14chanwa/MiAM_robotics_ESP32/CAD/PAMI DC Base V2.stl

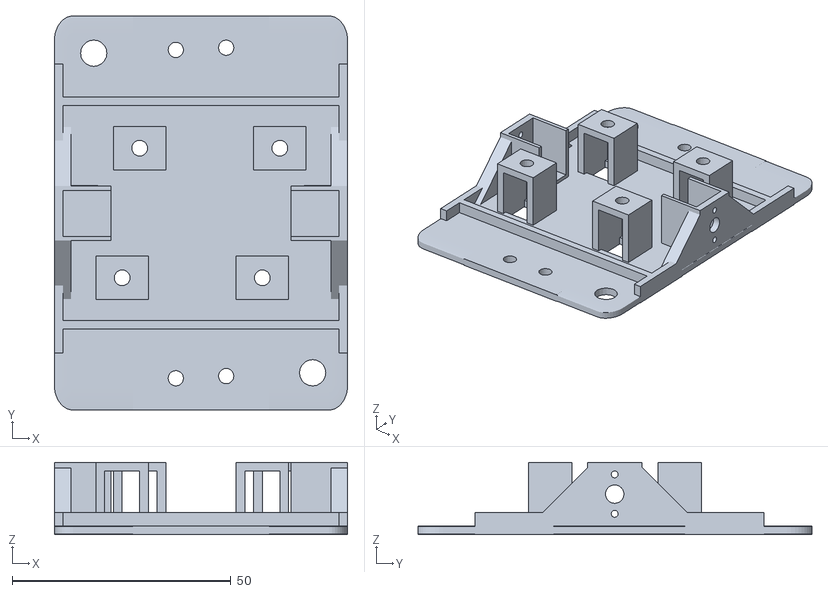
[picture p1: CAD file, 2023-10-16]
CAD/PAMI DC Base V2.stl
67.0 x 90.0 x 16.5
