14chanwa/MiAM_robotics_ESP32/Electronics/eurobot2024/MiAM_PAMI2024_DC/MiAM_PAMI_2024_DC.kicad_pcb

## KiCad design Electronics/eurobot2024/MiAM_PAMI2024_DC/MiAM_PAMI_2024_DC.kicad_pcb (2025-01-02)

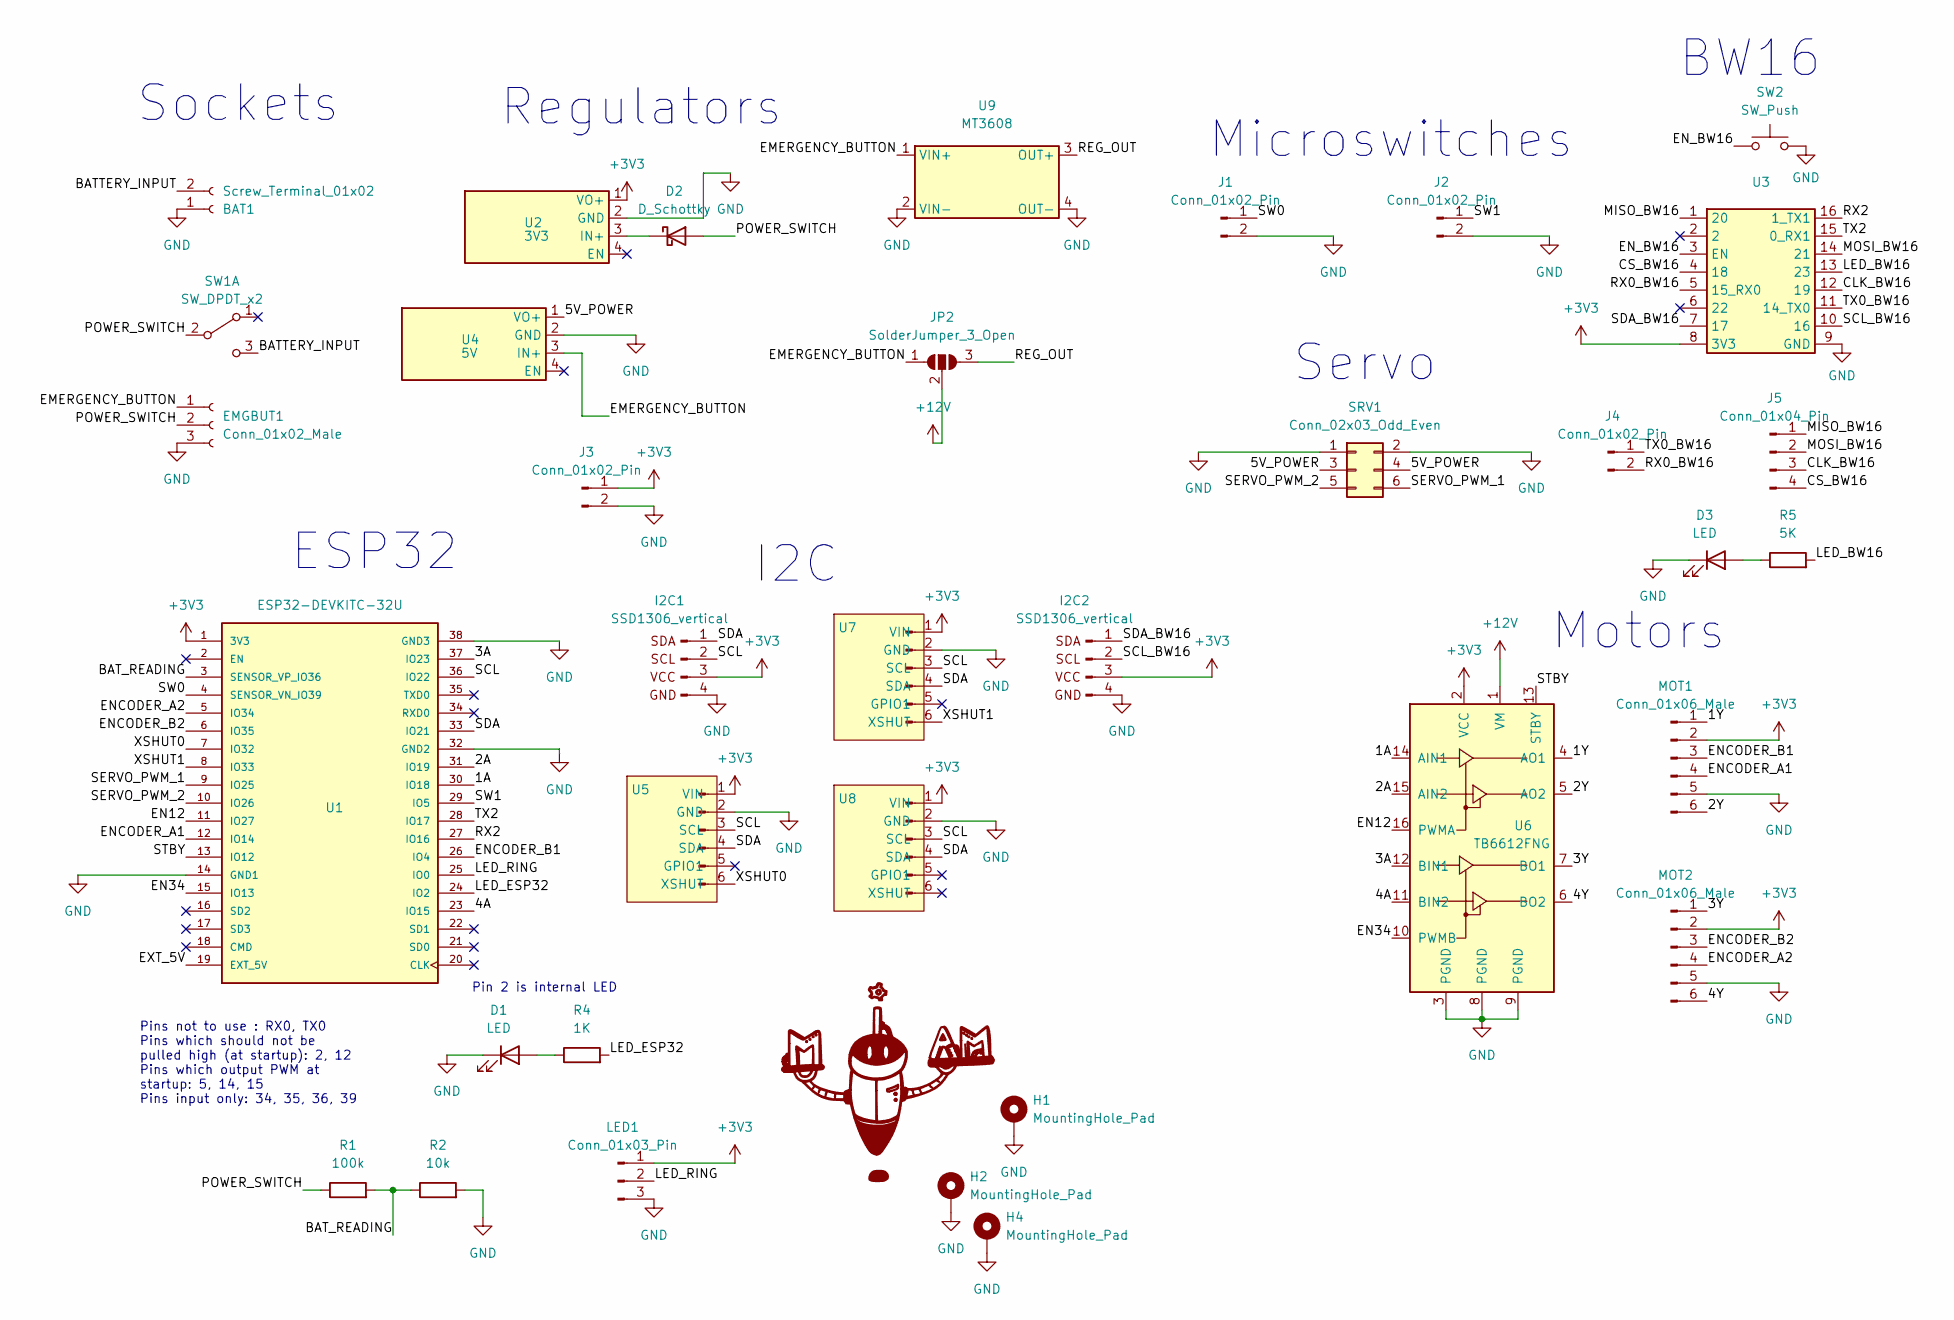
[picture p2: schematic MiAM_PAMI_2024_DC.kicad_sch]

Parts:
BAT1: Screw_Terminal_01x02; JST_PH_B2B-PH-K_1x02_P2.00mm_Vertical
D1, D3: LED; LED_0805_2012Metric
D2: D_Schottky; D_SOD-323_HandSoldering
EMGBUT1: Conn_01x02_Male; JST_PH_B3B-PH-K_1x03_P2.00mm_Vertical
H1, H2, H4: MountingHole_Pad; MountingHole_3.2mm_M3_DIN965_Pad
I2C1, I2C2: SSD1306_vertical; PinHeader_1x04_P2.54mm_Vertical
J1, J2, J3, J4: Conn_01x02_Pin; PinHeader_1x02_P2.54mm_Vertical
J5: Conn_01x04_Pin; PinHeader_1x04_P2.54mm_Vertical
JP2: SolderJumper_3_Open; SolderJumper-3_P1.3mm_Bridged12_Pad1.0x1.5mm_NumberLabels
LED1: Conn_01x03_Pin; PinHeader_1x03_P2.54mm_Vertical
MOT1, MOT2: Conn_01x06_Male; PinHeader_1x06_P2.54mm_Vertical
R1: 100k; R_0805_2012Metric_Pad1.20x1.40mm_HandSolder
R2: 10k; R_0805_2012Metric_Pad1.20x1.40mm_HandSolder
R4: 1K; R_0805_2012Metric
R5: 5K; R_0805_2012Metric
SRV1: Conn_02x03_Odd_Even; PinHeader_2x03_P2.54mm_Vertical
SW1: SW_DPDT_x2; SS-12D11
SW2: SW_Push; SW_Push_1P1T_NO_Vertical_Wuerth_434133025816
U1: ESP32-DEVKITC-32U; ESP32U-ShieldPattern
U2: 3V3; VoltageRegulator
U3: BW16_Breakout
U4: 5V; VoltageRegulator
U5, U7, U8: PinHeader_1x06_P2.54mm_Vertical
U6: TB6612FNG
U9: MT3608

Connections:
+3V3: I2C1.3 (VCC), I2C2.3 (VCC), J3.1, LED1.1, MOT1.2, MOT2.2, U1.1 (3V3), U2.1 (VO+), U3.8 (3V3), U5.1 (VIN), U6.2 (VCC), U7.1 (VIN), U8.1 (VIN)
+12V: JP2.2 (C), U6.1 (VM)
/1A: U1.30 (IO18), U6.14 (AIN1)
/1Y: MOT1.1, U6.4 (AO1)
/2A: U1.31 (IO19), U6.15 (AIN2)
/2Y: MOT1.6, U6.5 (AO2)
/3A: U1.37 (IO23), U6.12 (BIN1)
/3Y: MOT2.1, U6.7 (BO1)
/4A: U1.23 (IO15), U6.11 (BIN2)
/4Y: MOT2.6, U6.6 (BO2)
/5V_POWER: SRV1.3, SRV1.4, U4.1 (VO+)
/BATTERY_INPUT: BAT1.2, SW1.3 (C)
/BAT_READING: R1.2, R2.1, U1.3 (SENSOR_VP_IO36)
/CLK_BW16: J5.3, U3.12 (19)
/CS_BW16: J5.4, U3.4 (18)
/EMERGENCY_BUTTON: EMGBUT1.1, JP2.1 (A), U4.3 (IN+), U9.1 (VIN+)
/EN12: U1.11 (IO27), U6.16 (PWMA)
/EN34: U1.15 (IO13), U6.10 (PWMB)
/ENCODER_A1: MOT1.4, U1.12 (IO14)
/ENCODER_A2: MOT2.4, U1.5 (IO34)
/ENCODER_B1: MOT1.3, U1.26 (IO4)
/ENCODER_B2: MOT2.3, U1.6 (IO35)
/EN_BW16: SW2.1, U3.3 (EN)
/EXT_5V: U1.19 (EXT_5V)
/LED_BW16: R5.2, U3.13 (23)
/LED_ESP32: R4.2, U1.24 (IO2)
/LED_RING: LED1.2, U1.25 (IO0)
/MISO_BW16: J5.1, U3.1 (20)
/MOSI_BW16: J5.2, U3.14 (21)
/POWER_SWITCH: D2.2 (A), EMGBUT1.2, R1.1, SW1.2 (B)
/REG_OUT: JP2.3 (B), U9.3 (OUT+)
/RX0_BW16: J4.2, U3.5 (15_RX0)
/RX2: U1.27 (IO16), U3.16 (1_TX1)
/SCL: I2C1.2 (SCL), U1.36 (IO22), U5.3 (SCL), U7.3 (SCL), U8.3 (SCL)
/SCL_BW16: I2C2.2 (SCL), U3.10 (16)
/SDA: I2C1.1 (SDA), U1.33 (IO21), U5.4 (SDA), U7.4 (SDA), U8.4 (SDA)
/SDA_BW16: I2C2.1 (SDA), U3.7 (17)
/SERVO_PWM_1: SRV1.6, U1.9 (IO25)
/SERVO_PWM_2: SRV1.5, U1.10 (IO26)
/STBY: U1.13 (IO12), U6.13 (STBY)
/SW0: J1.1, U1.4 (SENSOR_VN_IO39)
/SW1: J2.1, U1.29 (IO5)
/TX0_BW16: J4.1, U3.11 (14_TX0)
/TX2: U1.28 (IO17), U3.15 (0_RX1)
/XSHUT0: U1.7 (IO32), U5.6 (XSHUT)
/XSHUT1: U1.8 (IO33), U7.6 (XSHUT)
GND: BAT1.1, D1.1 (K), D3.1 (K), EMGBUT1.3, H1.1, H2.1, H4.1, I2C1.4 (GND), I2C2.4 (GND), J1.2, J2.2, J3.2, LED1.3, MOT1.5, MOT2.5, R2.2, SRV1.1, SRV1.2, SW2.2, U1.14 (GND1), U1.32 (GND2), U1.38 (GND3), U2.2 (GND), U3.9 (GND), U4.2 (GND), U5.2 (GND), U6.3 (PGND), U6.8 (PGND), U6.9 (PGND), U7.2 (GND), U8.2 (GND), U9.2 (VIN-), U9.4 (OUT-)
unnamed: D1.2 (A), R4.1
unnamed: D2.1 (K), U2.3 (IN+)
unnamed: D3.2 (A), R5.1

Notes on the sheet:
Pins not to use : RX0, TX0 Pins which should not be pulled high (at startup): 2, 12 Pins which output PWM at startup: 5, 14, 15 Pins input only: 34, 35, 36, 39
Sockets
ESP32
Regulators
BW16
Microswitches
Pin 2 is internal LED
I2C
Motors
Servo

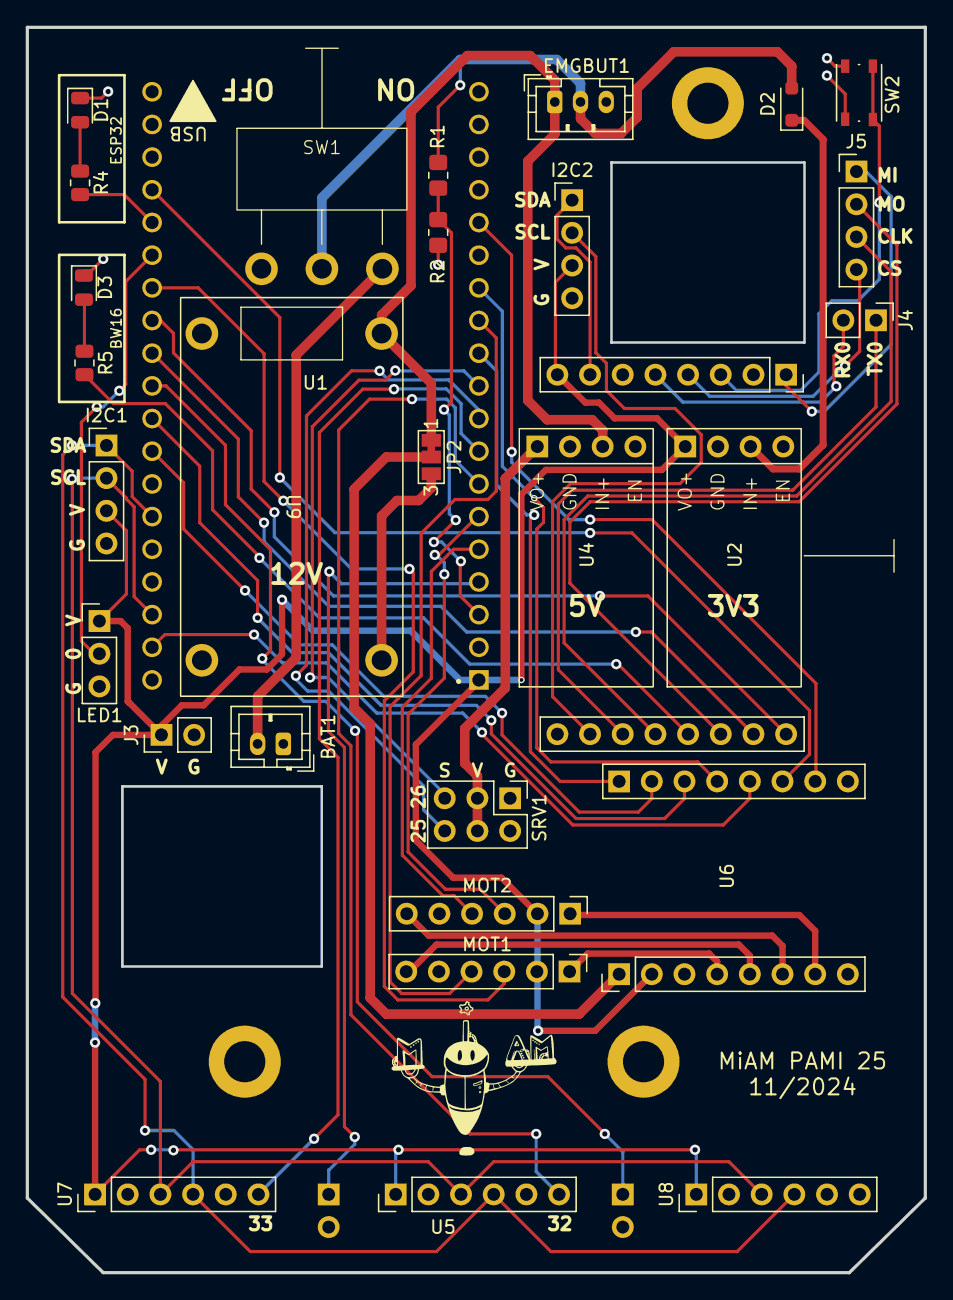
[picture p3: board MiAM_PAMI_2024_DC.kicad_pcb from above]

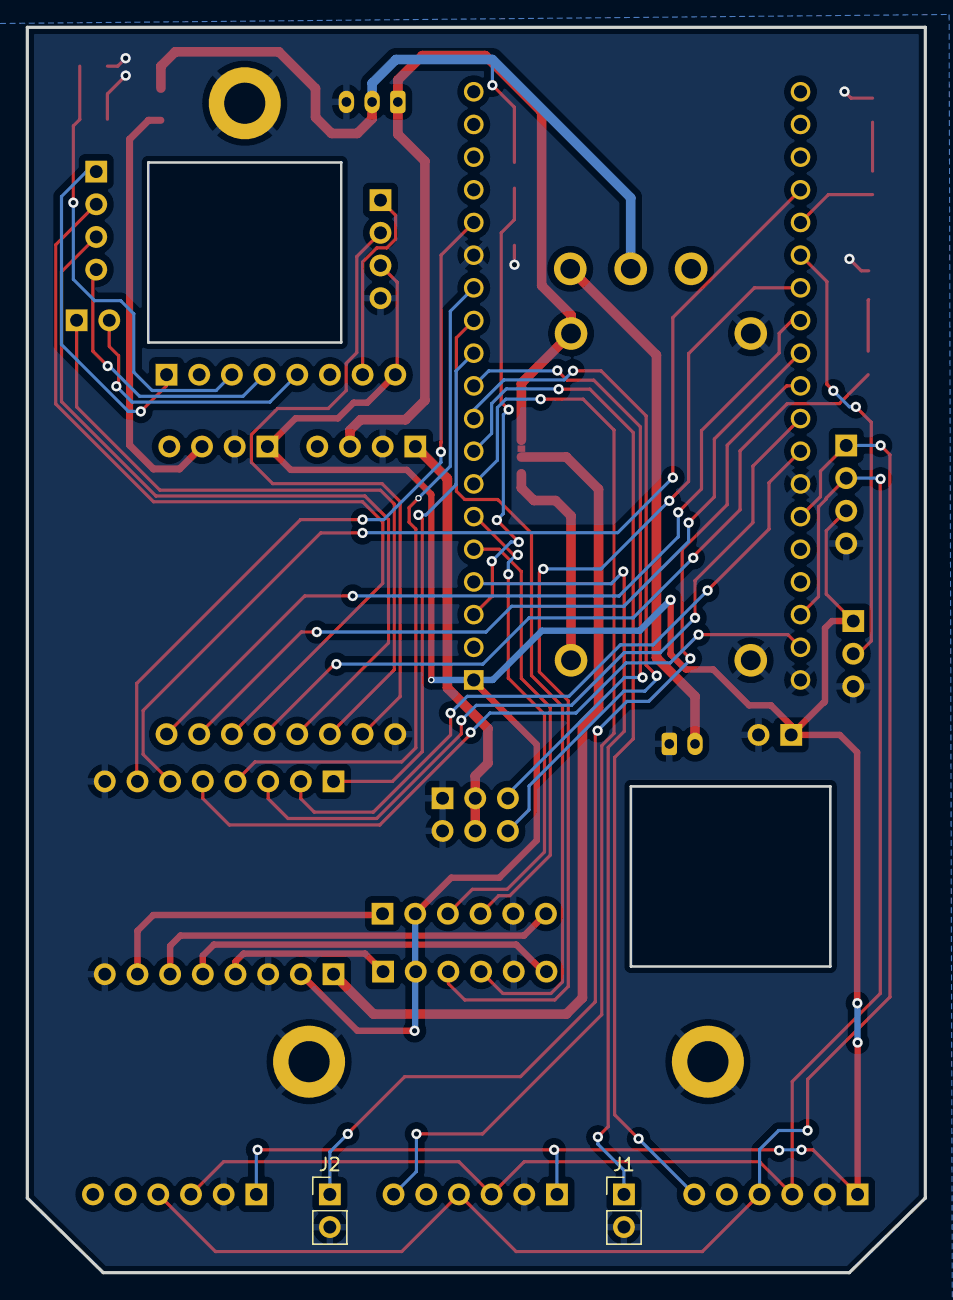
[picture p4: board MiAM_PAMI_2024_DC.kicad_pcb from below]

Board: 2 copper layers, 69.8 x 96.8 mm, 35 parts (2 on the bottom side), 49 nets.
