14chanwa/MiAM_robotics_ESP32/Electronics/eurobot2023/MiAM_PAMI_V2_StepperDriverBoard/MiAM_PAMI_V2_StepperDriverBoard.kicad_pcb

## KiCad design Electronics/eurobot2023/MiAM_PAMI_V2_StepperDriverBoard/MiAM_PAMI_V2_StepperDriverBoard.kicad_pcb (2023-11-03)

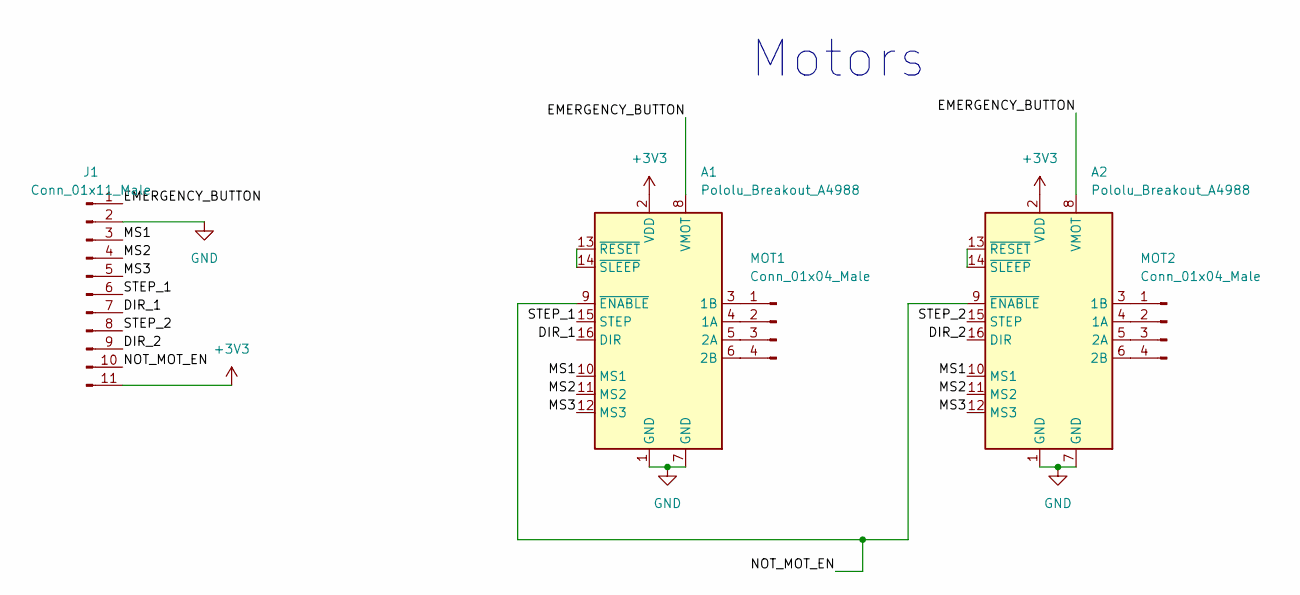
[picture p5: schematic MiAM_PAMI_V2_StepperDriverBoard.kicad_sch]

Parts:
A1, A2: Pololu_Breakout_A4988; Pololu_Breakout-16_15.2x20.3mm
J1: Conn_01x11_Male; PinSocket_1x11_P2.54mm_Vertical
MOT1, MOT2: Conn_01x04_Male; PinHeader_1x04_P2.54mm_Vertical

Connections:
+3V3: A1.2 (VDD), A2.2 (VDD), J1.11
/DIR_1: A1.16 (DIR), J1.7
/DIR_2: A2.16 (DIR), J1.9
/EMERGENCY_BUTTON: A1.8 (VMOT), A2.8 (VMOT), J1.1
/MS1: A1.10 (MS1), A2.10 (MS1), J1.3
/MS2: A1.11 (MS2), A2.11 (MS2), J1.4
/MS3: A1.12 (MS3), A2.12 (MS3), J1.5
/NOT_MOT_EN: A1.9 (~ENABLE), A2.9 (~ENABLE), J1.10
/STEP_1: A1.15 (STEP), J1.6
/STEP_2: A2.15 (STEP), J1.8
GND: A1.1 (GND), A1.7 (GND), A2.1 (GND), A2.7 (GND), J1.2
unnamed: A1.4 (1A), MOT1.2
unnamed: A1.3 (1B), MOT1.1
unnamed: A1.5 (2A), MOT1.3
unnamed: A1.6 (2B), MOT1.4
unnamed: A1.13 (~RESET), A1.14 (~SLEEP)
unnamed: A2.4 (1A), MOT2.2
unnamed: A2.3 (1B), MOT2.1
unnamed: A2.5 (2A), MOT2.3
unnamed: A2.6 (2B), MOT2.4
unnamed: A2.13 (~RESET), A2.14 (~SLEEP)

Notes on the sheet:
Motors

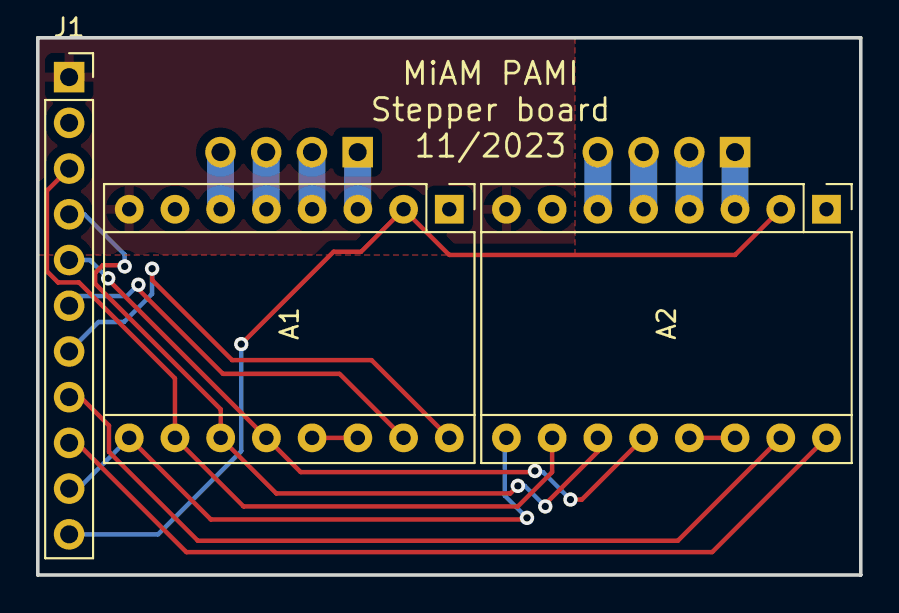
[picture p6: board MiAM_PAMI_V2_StepperDriverBoard.kicad_pcb from above]

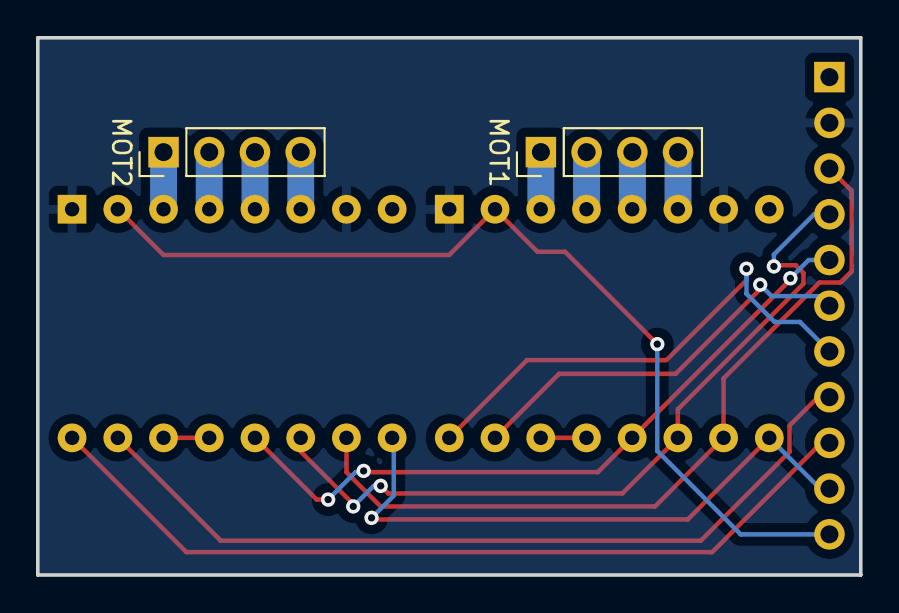
[picture p7: board MiAM_PAMI_V2_StepperDriverBoard.kicad_pcb from below]

Board: 2 copper layers, 45.7 x 29.8 mm, 5 parts (2 on the bottom side), 21 nets.
