14chanwa/MiAM_robotics_ESP32/Electronics/eurobot2023/MiAM_SupervisorBoard/MiAM_SupervisorBoard.kicad_pcb

## KiCad design Electronics/eurobot2023/MiAM_SupervisorBoard/MiAM_SupervisorBoard.kicad_pcb (2024-03-25)

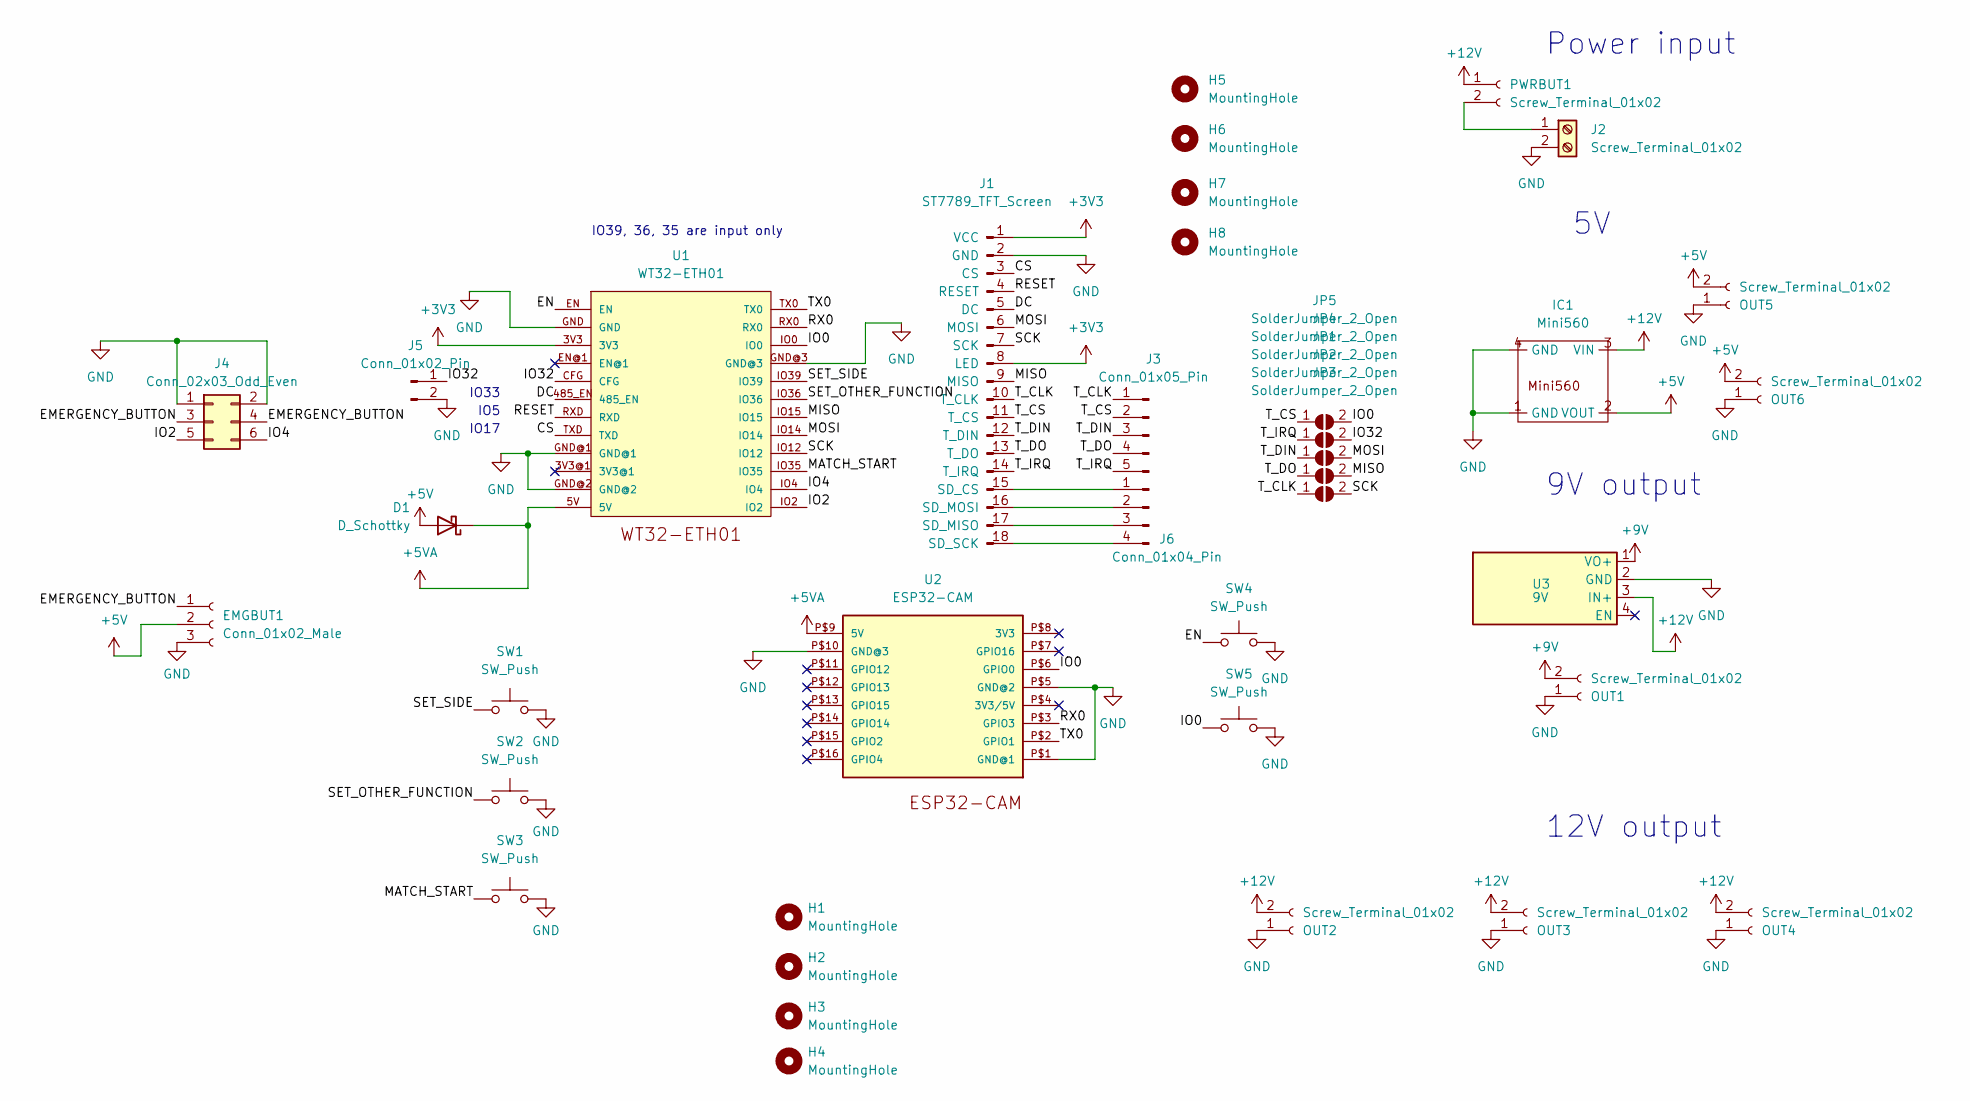
[picture p8: schematic MiAM_SupervisorBoard.kicad_sch]

Parts:
D1: D_Schottky; D_SOD-323_HandSoldering
EMGBUT1: Conn_01x02_Male; JST_PH_B3B-PH-K_1x03_P2.00mm_Vertical
H1, H2, H3, H4: MountingHole; MountingHole_3.2mm_M3
H5, H6, H7, H8: MountingHole; MountingHole_2.7mm_M2.5
IC1: Mini560
J1: ST7789_TFT_Screen; 2.8_tft_240x320_touch_sd_spi
J2: Screw_Terminal_01x02; USBC-Dummy-Card
J3: Conn_01x05_Pin; PinHeader_1x05_P2.54mm_Vertical
J4: Conn_02x03_Odd_Even; PinHeader_2x03_P2.54mm_Vertical
J5: Conn_01x02_Pin; PinHeader_1x02_P2.54mm_Vertical
J6: Conn_01x04_Pin; PinHeader_1x04_P2.54mm_Vertical
JP1, JP2, JP3, JP4, JP5: SolderJumper_2_Open; SolderJumper-2_P1.3mm_Open_RoundedPad1.0x1.5mm
OUT1, OUT2, OUT3, OUT4, OUT5, OUT6: Screw_Terminal_01x02; JST_PH_B2B-PH-K_1x02_P2.00mm_Vertical
PWRBUT1: Screw_Terminal_01x02; JST_PH_B2B-PH-K_1x02_P2.00mm_Vertical
SW1, SW2, SW3: SW_Push; JST_PH_B2B-PH-K_1x02_P2.00mm_Vertical
SW4, SW5: SW_Push; SW_Push_1P1T_NO_Vertical_Wuerth_434133025816
U1: WT32-ETH01; WT32-ETH01-MB
U2: ESP32-CAM; ESP32-CAM_MB
U3: 9V; VoltageRegulator

Connections:
+3V3: J1.1 (VCC), J1.8 (LED), U1.3V3
+5V: D1.2 (A), EMGBUT1.2, IC1.2 (VOUT), OUT5.2, OUT6.2
+5VA: D1.1 (K), U1.5V, U2.P$9 (5V)
+9V: OUT1.2, U3.1 (VO+)
+12V: IC1.3 (VIN), OUT2.2, OUT3.2, OUT4.2, PWRBUT1.1, U3.3 (IN+)
/CS: J1.3 (CS), U1.TXD
/DC: J1.5 (DC), U1.485_EN
/EMERGENCY_BUTTON: EMGBUT1.1, J4.3, J4.4
/EN: SW4.1, U1.EN
/IO0: JP5.2 (B), SW5.1, U1.IO0, U2.P$6 (GPIO0)
/IO2: J4.5, U1.IO2
/IO4: J4.6, U1.IO4
/IO32: J5.1, JP4.2 (B), U1.CFG
/MATCH_START: SW3.1, U1.IO35
/MISO: J1.9 (MISO), JP2.2 (B), U1.IO15
/MOSI: J1.6 (MOSI), JP1.2 (B), U1.IO14
/RESET: J1.4 (RESET), U1.RXD
/RX0: U1.RX0, U2.P$3 (GPIO3)
/SCK: J1.7 (SCK), JP3.2 (B), U1.IO12
/SET_OTHER_FUNCTION: SW2.1, U1.IO36
/SET_SIDE: SW1.1, U1.IO39
/TX0: U1.TX0, U2.P$2 (GPIO1)
/T_CLK: J1.10 (T_CLK), J3.1, JP3.1 (A)
/T_CS: J1.11 (T_CS), J3.2, JP5.1 (A)
/T_DIN: J1.12 (T_DIN), J3.3, JP1.1 (A)
/T_DO: J1.13 (T_DO), J3.4, JP2.1 (A)
/T_IRQ: J1.14 (T_IRQ), J3.5, JP4.1 (A)
GND: EMGBUT1.3, IC1.1 (GND), IC1.4 (GND), J1.2 (GND), J2.2, J4.1, J4.2, J5.2, OUT1.1, OUT2.1, OUT3.1, OUT4.1, OUT5.1, OUT6.1, SW1.2, SW2.2, SW3.2, SW4.2, SW5.2, U1.GND, U1.GND@1, U1.GND@2, U1.GND@3, U2.P$1 (GND@1), U2.P$5 (GND@2), U2.P$10 (GND@3), U3.2 (GND)
unnamed: J1.15 (SD_CS), J6.1
unnamed: J1.17 (SD_MISO), J6.3
unnamed: J1.16 (SD_MOSI), J6.2
unnamed: J1.18 (SD_SCK), J6.4
unnamed: J2.1, PWRBUT1.2

Notes on the sheet:
9V output
IO33
IO39, 36, 35 are input only
IO5
Power input
12V output
IO17

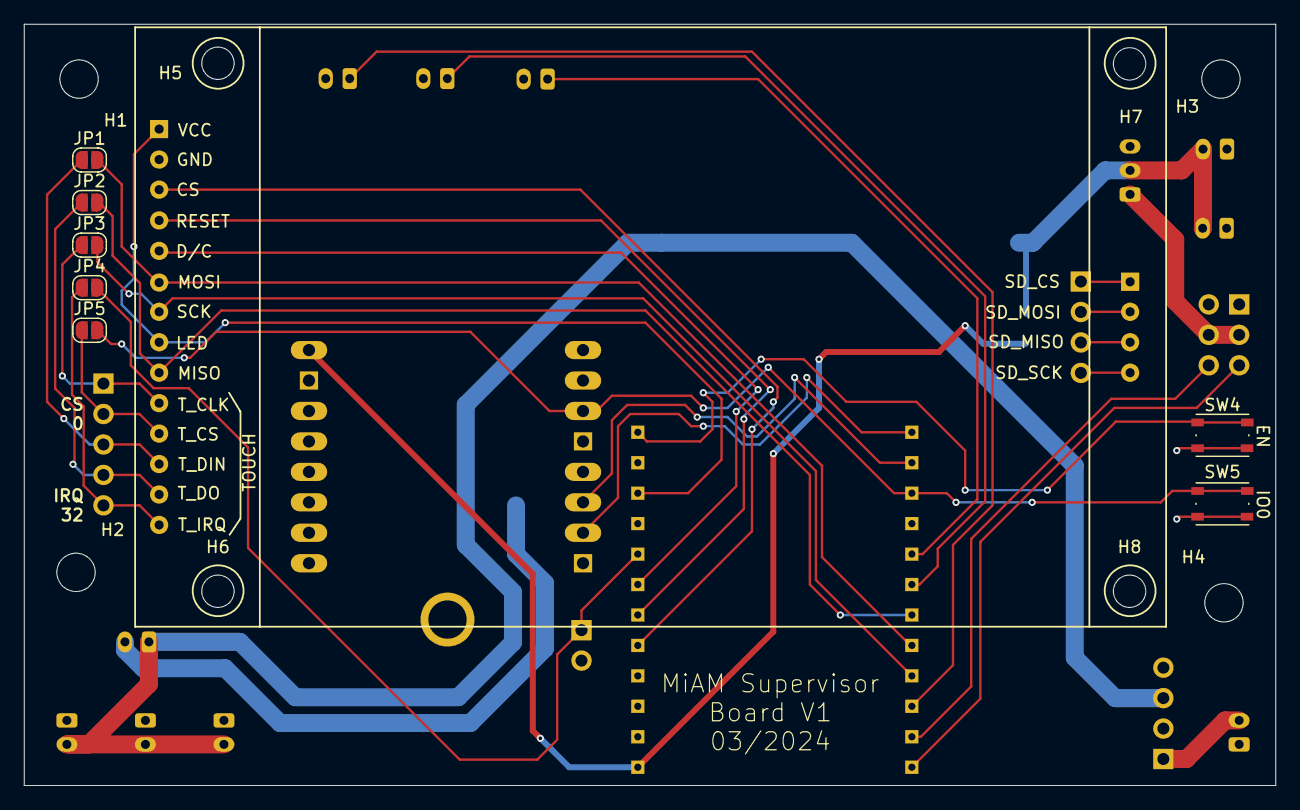
[picture p9: board MiAM_SupervisorBoard.kicad_pcb from above]

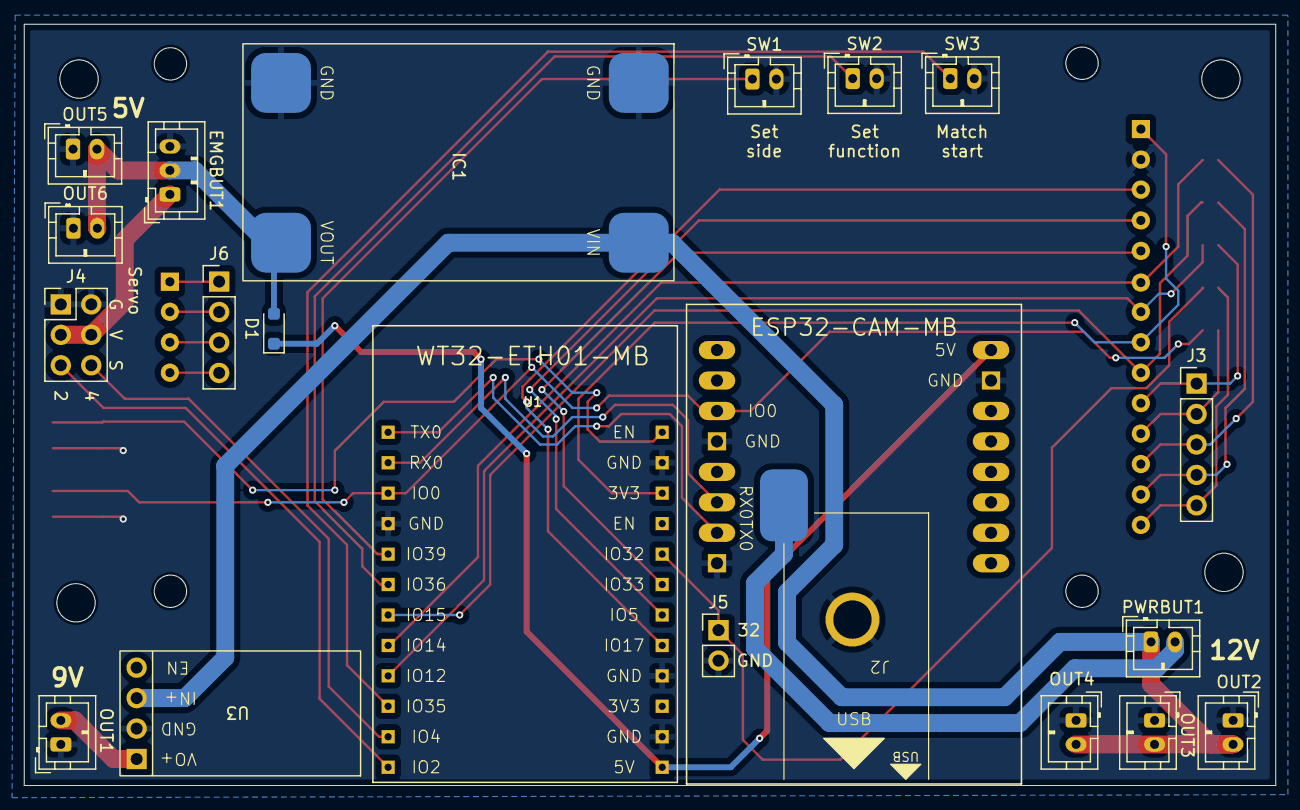
[picture p10: board MiAM_SupervisorBoard.kicad_pcb from below]

Board: 2 copper layers, 104.4 x 63.5 mm, 37 parts (21 on the bottom side), 33 nets.
