14chanwa/MiAM_robotics_ESP32/Electronics/eurobot2023/MiAM_PAMI_V2_StepperMainBoard/MiAM_PAMI_V2_StepperMainBoard.kicad_pcb

## KiCad design Electronics/eurobot2023/MiAM_PAMI_V2_StepperMainBoard/MiAM_PAMI_V2_StepperMainBoard.kicad_pcb (2023-11-26)

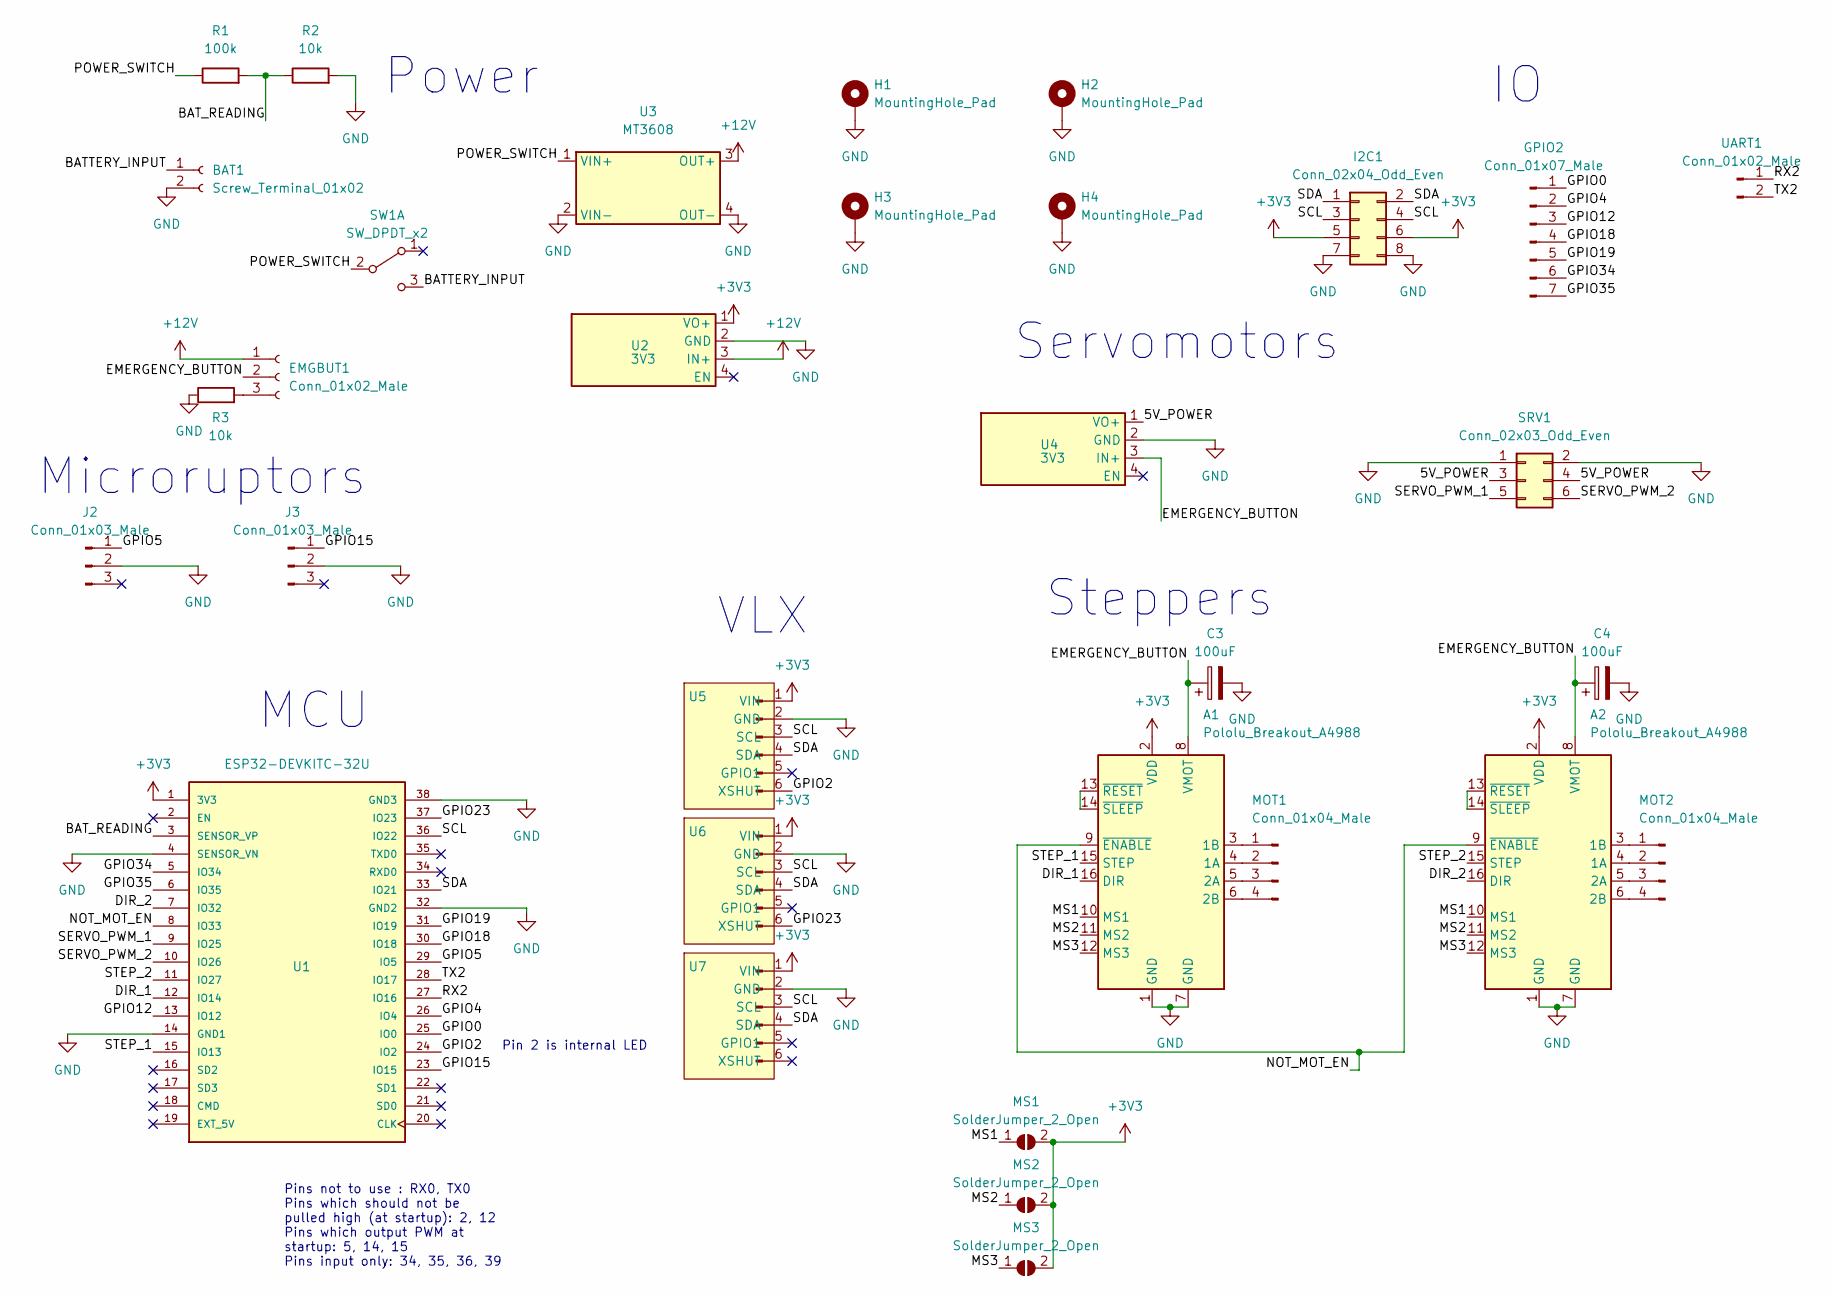
[picture p11: schematic MiAM_PAMI_V2_StepperMainBoard.kicad_sch]

Parts:
A1, A2: Pololu_Breakout_A4988; Pololu_Breakout-16_15.2x20.3mm
BAT1: Screw_Terminal_01x02; JST_PH_B2B-PH-K_1x02_P2.00mm_Vertical
C3, C4: 100uF; CP_Radial_D4.0mm_P2.00mm
EMGBUT1: Conn_01x02_Male; JST_PH_B3B-PH-K_1x03_P2.00mm_Vertical
GPIO2: Conn_01x07_Male; PinHeader_1x07_P2.54mm_Vertical
H1, H2, H3, H4: MountingHole_Pad; MountingHole_3.2mm_M3_DIN965_Pad
I2C1: Conn_02x04_Odd_Even; PinHeader_2x04_P2.54mm_Vertical
J2, J3: Conn_01x03_Male; Microruptor
MOT1, MOT2: Conn_01x04_Male; PinHeader_1x04_P2.54mm_Vertical
MS1, MS2, MS3: SolderJumper_2_Open; SolderJumper-2_P1.3mm_Open_RoundedPad1.0x1.5mm
R1: 100k; R_0805_2012Metric_Pad1.20x1.40mm_HandSolder
R2, R3: 10k; R_0805_2012Metric_Pad1.20x1.40mm_HandSolder
SRV1: Conn_02x03_Odd_Even; PinHeader_2x03_P2.54mm_Vertical
SW1: SW_DPDT_x2; SS-12D11
U1: ESP32-DEVKITC-32U; ESP32U-ShieldPattern
U2, U4: 3V3; VoltageRegulator
U3: MT3608
U5, U6, U7: PinHeader_1x06_P2.54mm_Vertical
UART1: Conn_01x02_Male; PinHeader_1x02_P2.54mm_Vertical

Connections:
+3V3: A1.2 (VDD), A2.2 (VDD), I2C1.5, I2C1.6, MS1.2 (B), MS2.2 (B), MS3.2 (B), U1.1 (3V3), U2.1 (VO+), U5.1 (VIN), U6.1 (VIN), U7.1 (VIN)
+12V: EMGBUT1.1, U2.3 (IN+), U3.3 (OUT+)
/5V_POWER: SRV1.3, SRV1.4, U4.1 (VO+)
/BATTERY_INPUT: BAT1.1, SW1.3 (C)
/BAT_READING: R1.2, R2.1, U1.3 (SENSOR_VP)
/DIR_1: A1.16 (DIR), U1.12 (IO14)
/DIR_2: A2.16 (DIR), U1.7 (IO32)
/EMERGENCY_BUTTON: A1.8 (VMOT), A2.8 (VMOT), C3.1, C4.1, EMGBUT1.2, U4.3 (IN+)
/GPIO0: GPIO2.1, U1.25 (IO0)
/GPIO2: U1.24 (IO2), U5.6 (XSHUT)
/GPIO4: GPIO2.2, U1.26 (IO4)
/GPIO5: J2.1, U1.29 (IO5)
/GPIO12: GPIO2.3, U1.13 (IO12)
/GPIO15: J3.1, U1.23 (IO15)
/GPIO18: GPIO2.4, U1.30 (IO18)
/GPIO19: GPIO2.5, U1.31 (IO19)
/GPIO23: U1.37 (IO23), U6.6 (XSHUT)
/GPIO34: GPIO2.6, U1.5 (IO34)
/GPIO35: GPIO2.7, U1.6 (IO35)
/MS1: A1.10 (MS1), A2.10 (MS1), MS1.1 (A)
/MS2: A1.11 (MS2), A2.11 (MS2), MS2.1 (A)
/MS3: A1.12 (MS3), A2.12 (MS3), MS3.1 (A)
/NOT_MOT_EN: A1.9 (~ENABLE), A2.9 (~ENABLE), U1.8 (IO33)
/POWER_SWITCH: R1.1, SW1.2 (B), U3.1 (VIN+)
/RX2: U1.27 (IO16), UART1.1
/SCL: I2C1.3, I2C1.4, U1.36 (IO22), U5.3 (SCL), U6.3 (SCL), U7.3 (SCL)
/SDA: I2C1.1, I2C1.2, U1.33 (IO21), U5.4 (SDA), U6.4 (SDA), U7.4 (SDA)
/SERVO_PWM_1: SRV1.5, U1.9 (IO25)
/SERVO_PWM_2: SRV1.6, U1.10 (IO26)
/STEP_1: A1.15 (STEP), U1.15 (IO13)
/STEP_2: A2.15 (STEP), U1.11 (IO27)
/TX2: U1.28 (IO17), UART1.2
GND: A1.1 (GND), A1.7 (GND), A2.1 (GND), A2.7 (GND), BAT1.2, C3.2, C4.2, H1.1, H2.1, H3.1, H4.1, I2C1.7, I2C1.8, J2.2, J3.2, R2.2, R3.1, SRV1.1, SRV1.2, U1.4 (SENSOR_VN), U1.14 (GND1), U1.32 (GND2), U1.38 (GND3), U2.2 (GND), U3.2 (VIN-), U3.4 (OUT-), U4.2 (GND), U5.2 (GND), U6.2 (GND), U7.2 (GND)
unnamed: A1.4 (1A), MOT1.2
unnamed: A1.3 (1B), MOT1.1
unnamed: A1.5 (2A), MOT1.3
unnamed: A1.6 (2B), MOT1.4
unnamed: A1.13 (~RESET), A1.14 (~SLEEP)
unnamed: A2.4 (1A), MOT2.2
unnamed: A2.3 (1B), MOT2.1
unnamed: A2.5 (2A), MOT2.3
unnamed: A2.6 (2B), MOT2.4
unnamed: A2.13 (~RESET), A2.14 (~SLEEP)
unnamed: EMGBUT1.3, R3.2

Notes on the sheet:
Pins not to use : RX0, TX0 Pins which should not be pulled high (at startup): 2, 12 Pins which output PWM at startup: 5, 14, 15 Pins input only: 34, 35, 36, 39
Power
MCU
Microruptors
Pin 2 is internal LED
VLX
Steppers
Servomotors

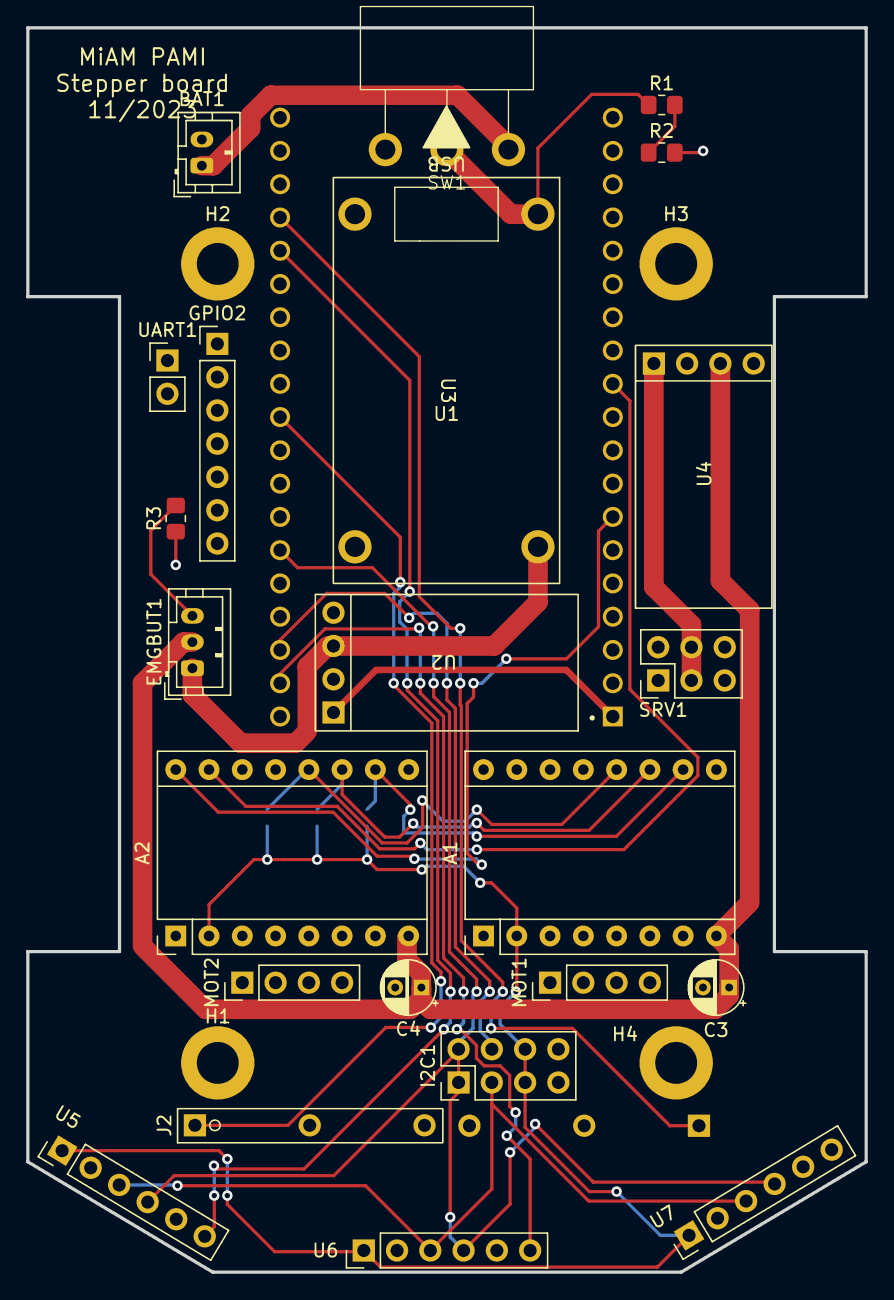
[picture p12: board MiAM_PAMI_V2_StepperMainBoard.kicad_pcb from above]

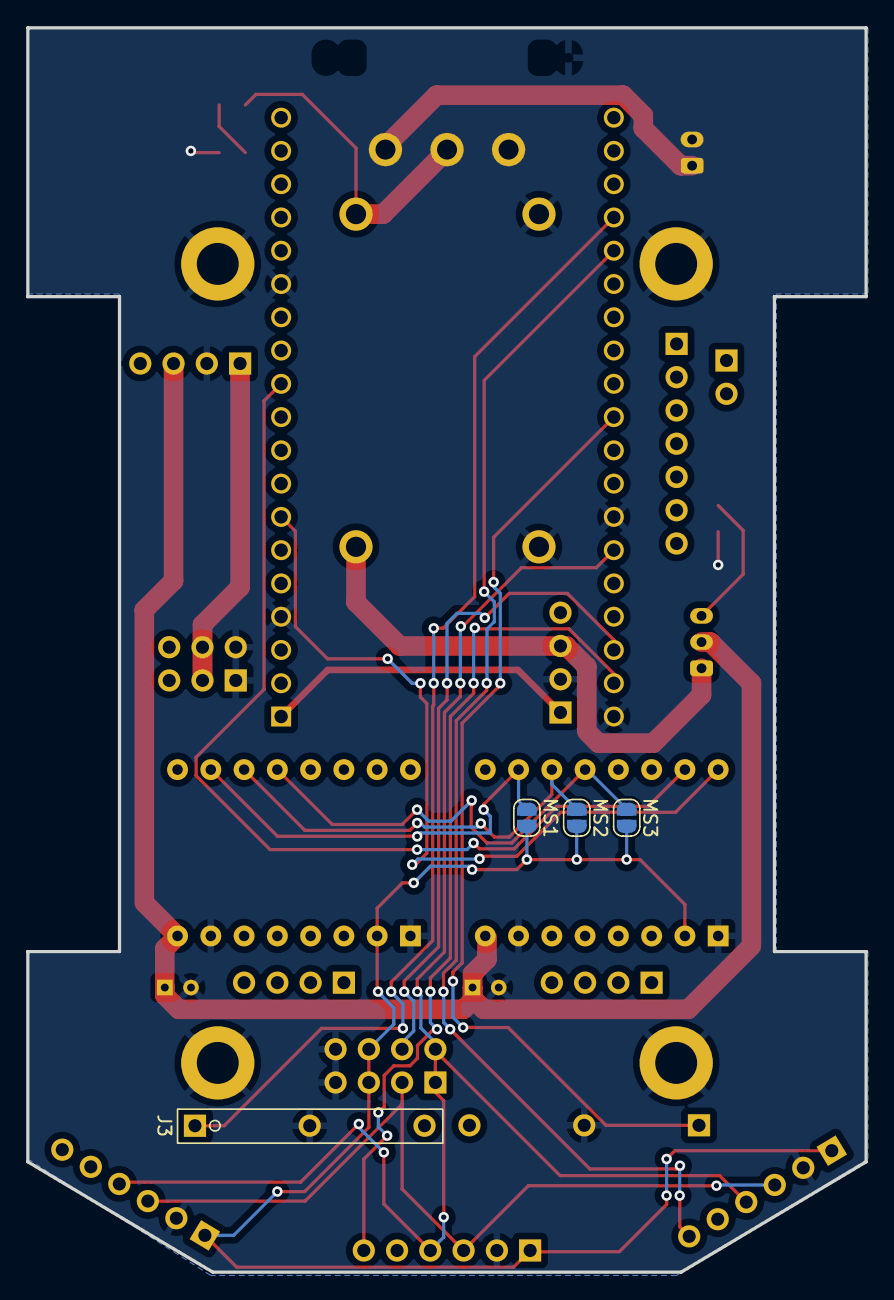
[picture p13: board MiAM_PAMI_V2_StepperMainBoard.kicad_pcb from below]

Board: 2 copper layers, 64.0 x 95.0 mm, 32 parts (4 on the bottom side), 44 nets.
