14chanwa/MiAM_robotics_ESP32/Electronics/eurobot2023/MiAM_ESP32/MiAM_ESP32.kicad_pcb

## KiCad design Electronics/eurobot2023/MiAM_ESP32/MiAM_ESP32.kicad_pcb (2023-10-28)

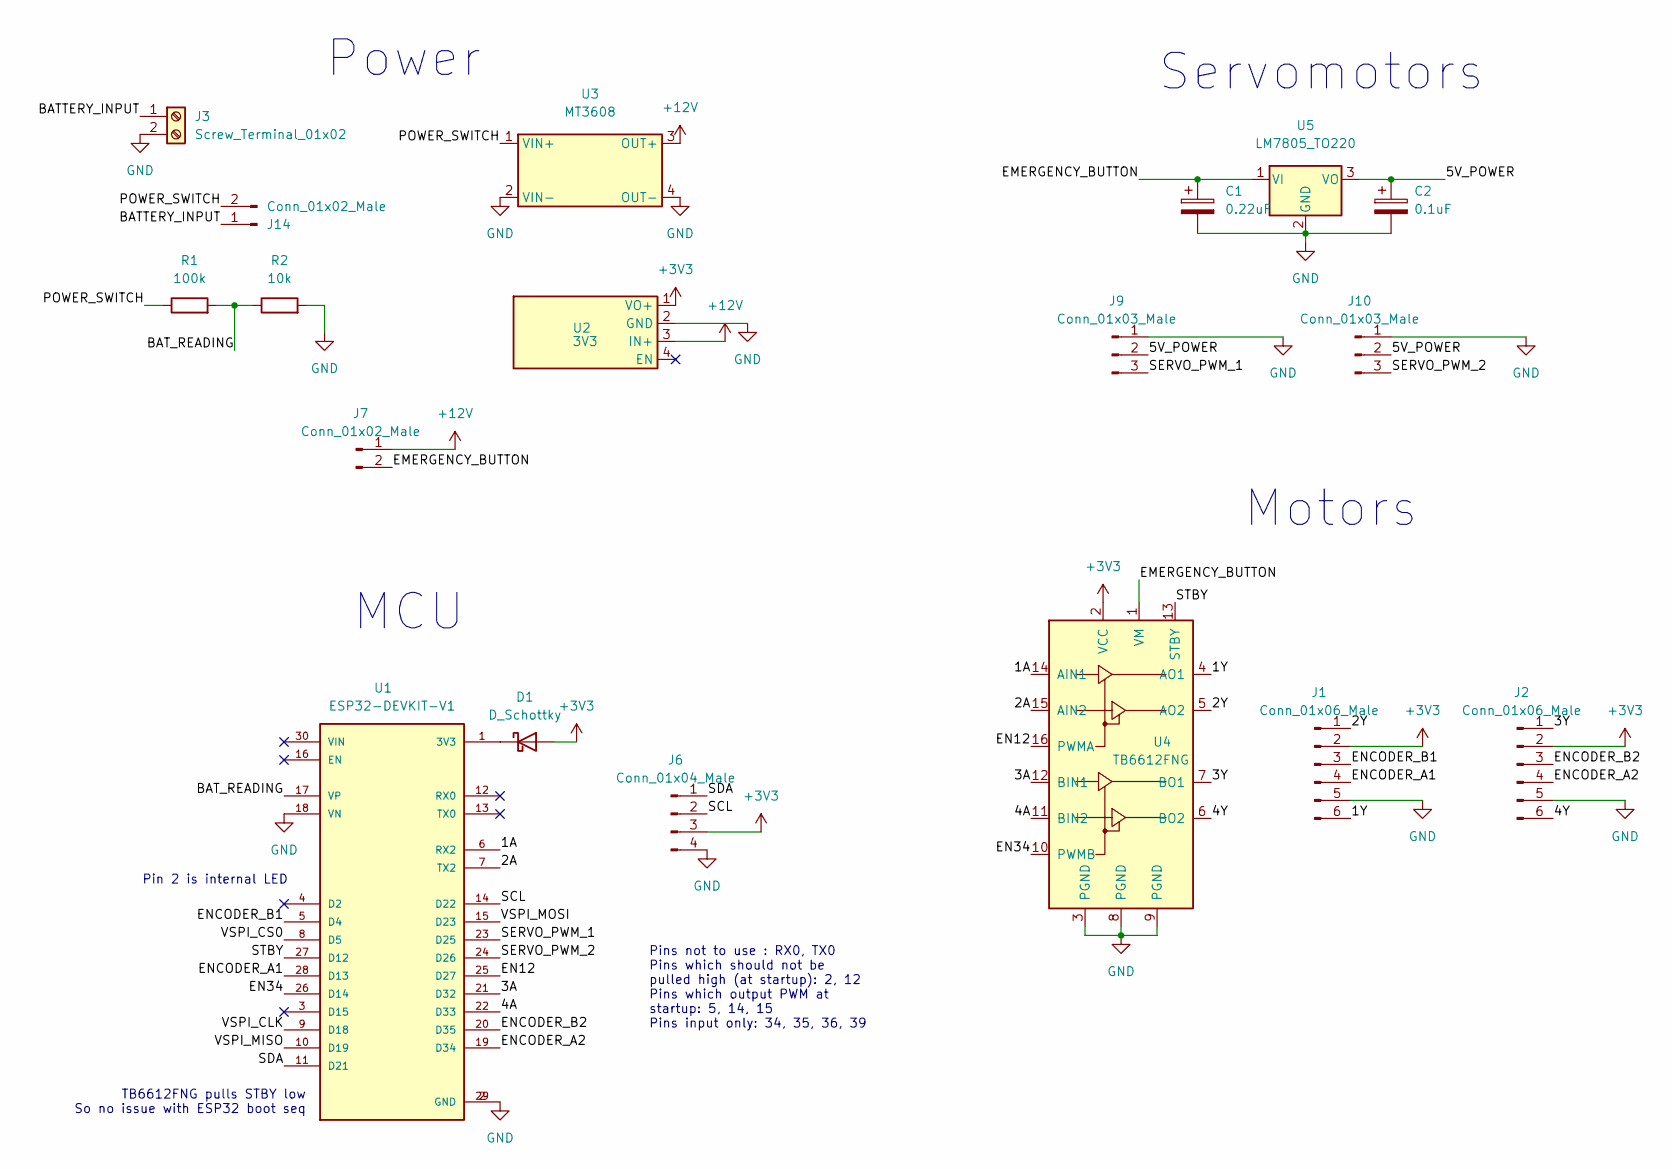
[picture p14: schematic MiAM_ESP32.kicad_sch]

Parts:
C1: 0.22uF; CP_Radial_D4.0mm_P2.00mm
C2: 0.1uF; CP_Radial_Tantal_D5.0mm_P5.00mm
D1: D_Schottky; D_DO-41_SOD81_P7.62mm_Horizontal
J1, J2: Conn_01x06_Male; PinHeader_1x06_P2.54mm_Vertical
J3: Screw_Terminal_01x02; JST_PH_B2B-PH-K_1x02_P2.00mm_Vertical
J6: Conn_01x04_Male; PinHeader_1x04_P2.54mm_Vertical
J7, J14: Conn_01x02_Male; PinHeader_1x02_P2.54mm_Vertical
J9, J10: Conn_01x03_Male; PinHeader_1x03_P2.54mm_Vertical
R1: 100k; R_Axial_DIN0309_L9.0mm_D3.2mm_P12.70mm_Horizontal
R2: 10k; R_Axial_DIN0309_L9.0mm_D3.2mm_P12.70mm_Horizontal
U1: ESP32-DEVKIT-V1; MODULE_ESP32_DEVKIT_V1; PARTREV N/A
U2: 3V3; VoltageRegulator
U3: MT3608
U4: TB6612FNG
U5: LM7805_TO220; TO-220-3_Vertical

Connections:
+3V3: D1.2 (A), J1.2, J2.2, J6.3, U2.1 (VO+), U4.2 (VCC)
+12V: J7.1, U2.3 (IN+), U3.3 (OUT+)
/1A: U1.6 (RX2), U4.14 (AIN1)
/1Y: J1.6, U4.4 (AO1)
/2A: U1.7 (TX2), U4.15 (AIN2)
/2Y: J1.1, U4.5 (AO2)
/3A: U1.21 (D32), U4.12 (BIN1)
/3Y: J2.1, U4.7 (BO1)
/4A: U1.22 (D33), U4.11 (BIN2)
/4Y: J2.6, U4.6 (BO2)
/5V_POWER: C2.1, J9.2, J10.2, U5.3 (VO)
/BATTERY_INPUT: J3.1, J14.1
/BAT_READING: R1.2, R2.1, U1.17 (VP)
/EMERGENCY_BUTTON: C1.1, J7.2, U4.1 (VM), U5.1 (VI)
/EN12: U1.25 (D27), U4.16 (PWMA)
/EN34: U1.26 (D14), U4.10 (PWMB)
/ENCODER_A1: J1.4, U1.28 (D13)
/ENCODER_A2: J2.4, U1.19 (D34)
/ENCODER_B1: J1.3, U1.5 (D4)
/ENCODER_B2: J2.3, U1.20 (D35)
/POWER_SWITCH: J14.2, R1.1, U3.1 (VIN+)
/SCL: J6.2, U1.14 (D22)
/SDA: J6.1, U1.11 (D21)
/SERVO_PWM_1: J9.3, U1.23 (D25)
/SERVO_PWM_2: J10.3, U1.24 (D26)
/STBY: U1.27 (D12), U4.13 (STBY)
/VSPI_CLK: U1.9 (D18)
/VSPI_CS0: U1.8 (D5)
/VSPI_MISO: U1.10 (D19)
/VSPI_MOSI: U1.15 (D23)
GND: C1.2, C2.2, J1.5, J2.5, J3.2, J6.4, J9.1, J10.1, R2.2, U1.2 (GND), U1.18 (VN), U1.29 (GND), U2.2 (GND), U3.2 (VIN-), U3.4 (OUT-), U4.3 (PGND), U4.8 (PGND), U4.9 (PGND), U5.2 (GND)
unnamed: D1.1 (K), U1.1 (3V3)

Notes on the sheet:
Servomotors
Pin 2 is internal LED
Power
TB6612FNG pulls STBY low So no issue with ESP32 boot seq
MCU
Motors
Pins not to use : RX0, TX0 Pins which should not be pulled high (at startup): 2, 12 Pins which output PWM at startup: 5, 14, 15 Pins input only: 34, 35, 36, 39

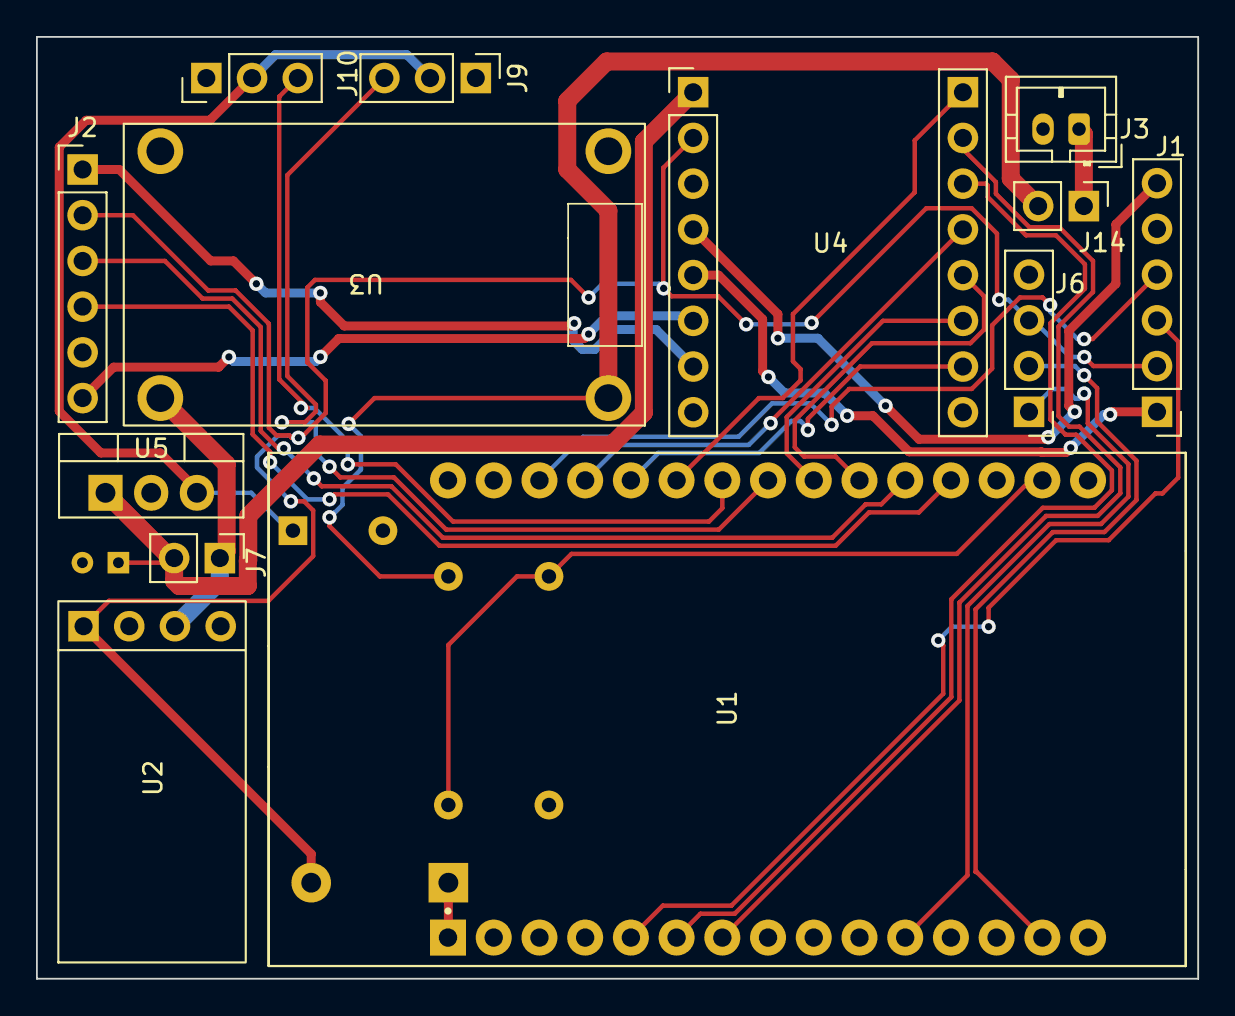
[picture p15: board MiAM_ESP32.kicad_pcb from above]

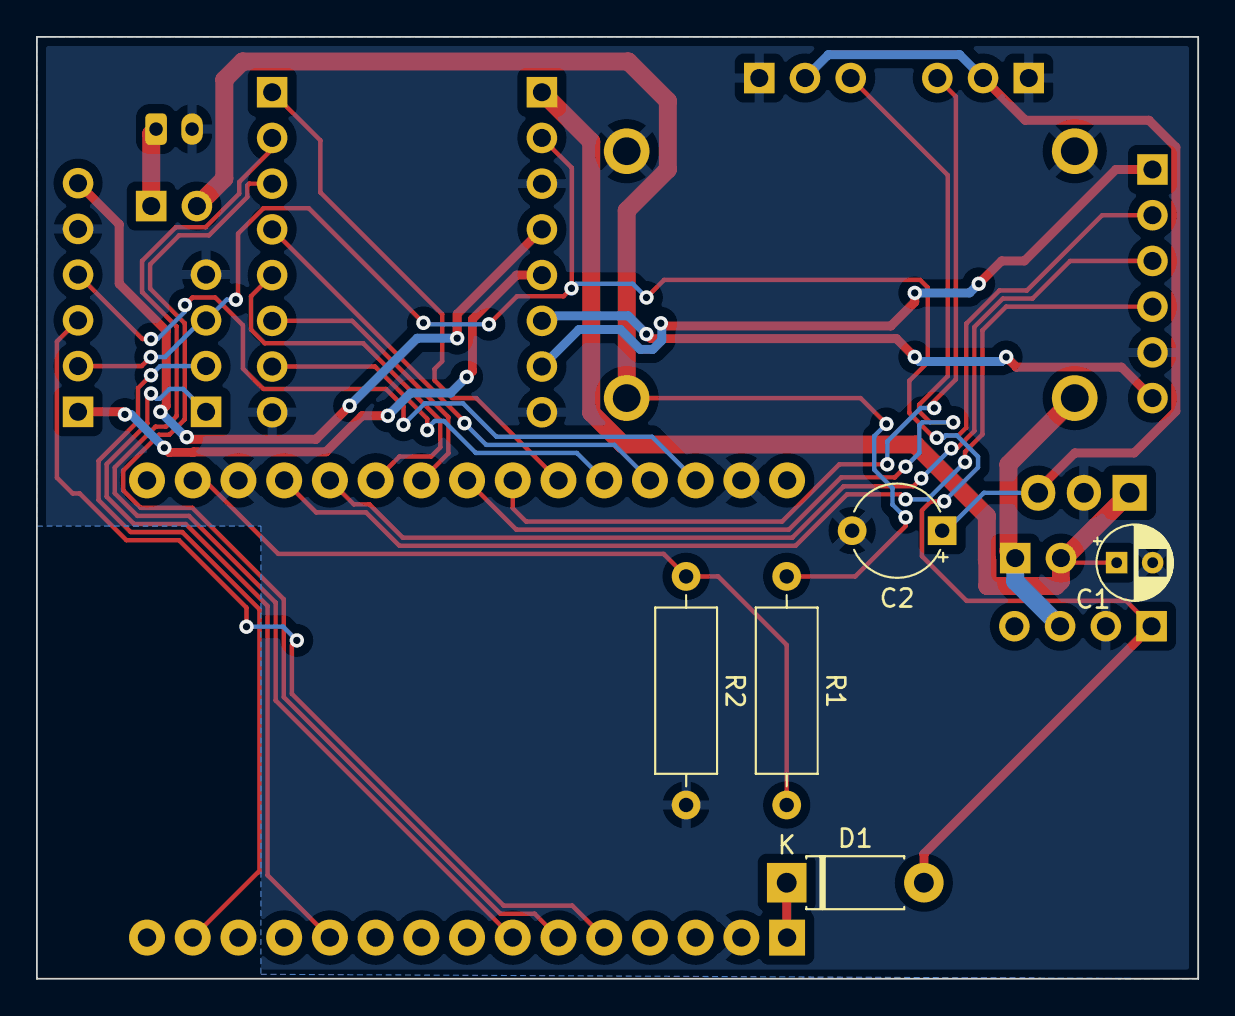
[picture p16: board MiAM_ESP32.kicad_pcb from below]

Board: 2 copper layers, 64.5 x 52.3 mm, 18 parts (5 on the bottom side), 28 nets.
