14chanwa/MiAM_robotics_ESP32/Electronics/eurobot2023/MiAM_PAMI_V3_Stepper/MiAM_PAMI_V3_Stepper.kicad_pcb

## KiCad design Electronics/eurobot2023/MiAM_PAMI_V3_Stepper/MiAM_PAMI_V3_Stepper.kicad_pcb (2023-11-29)

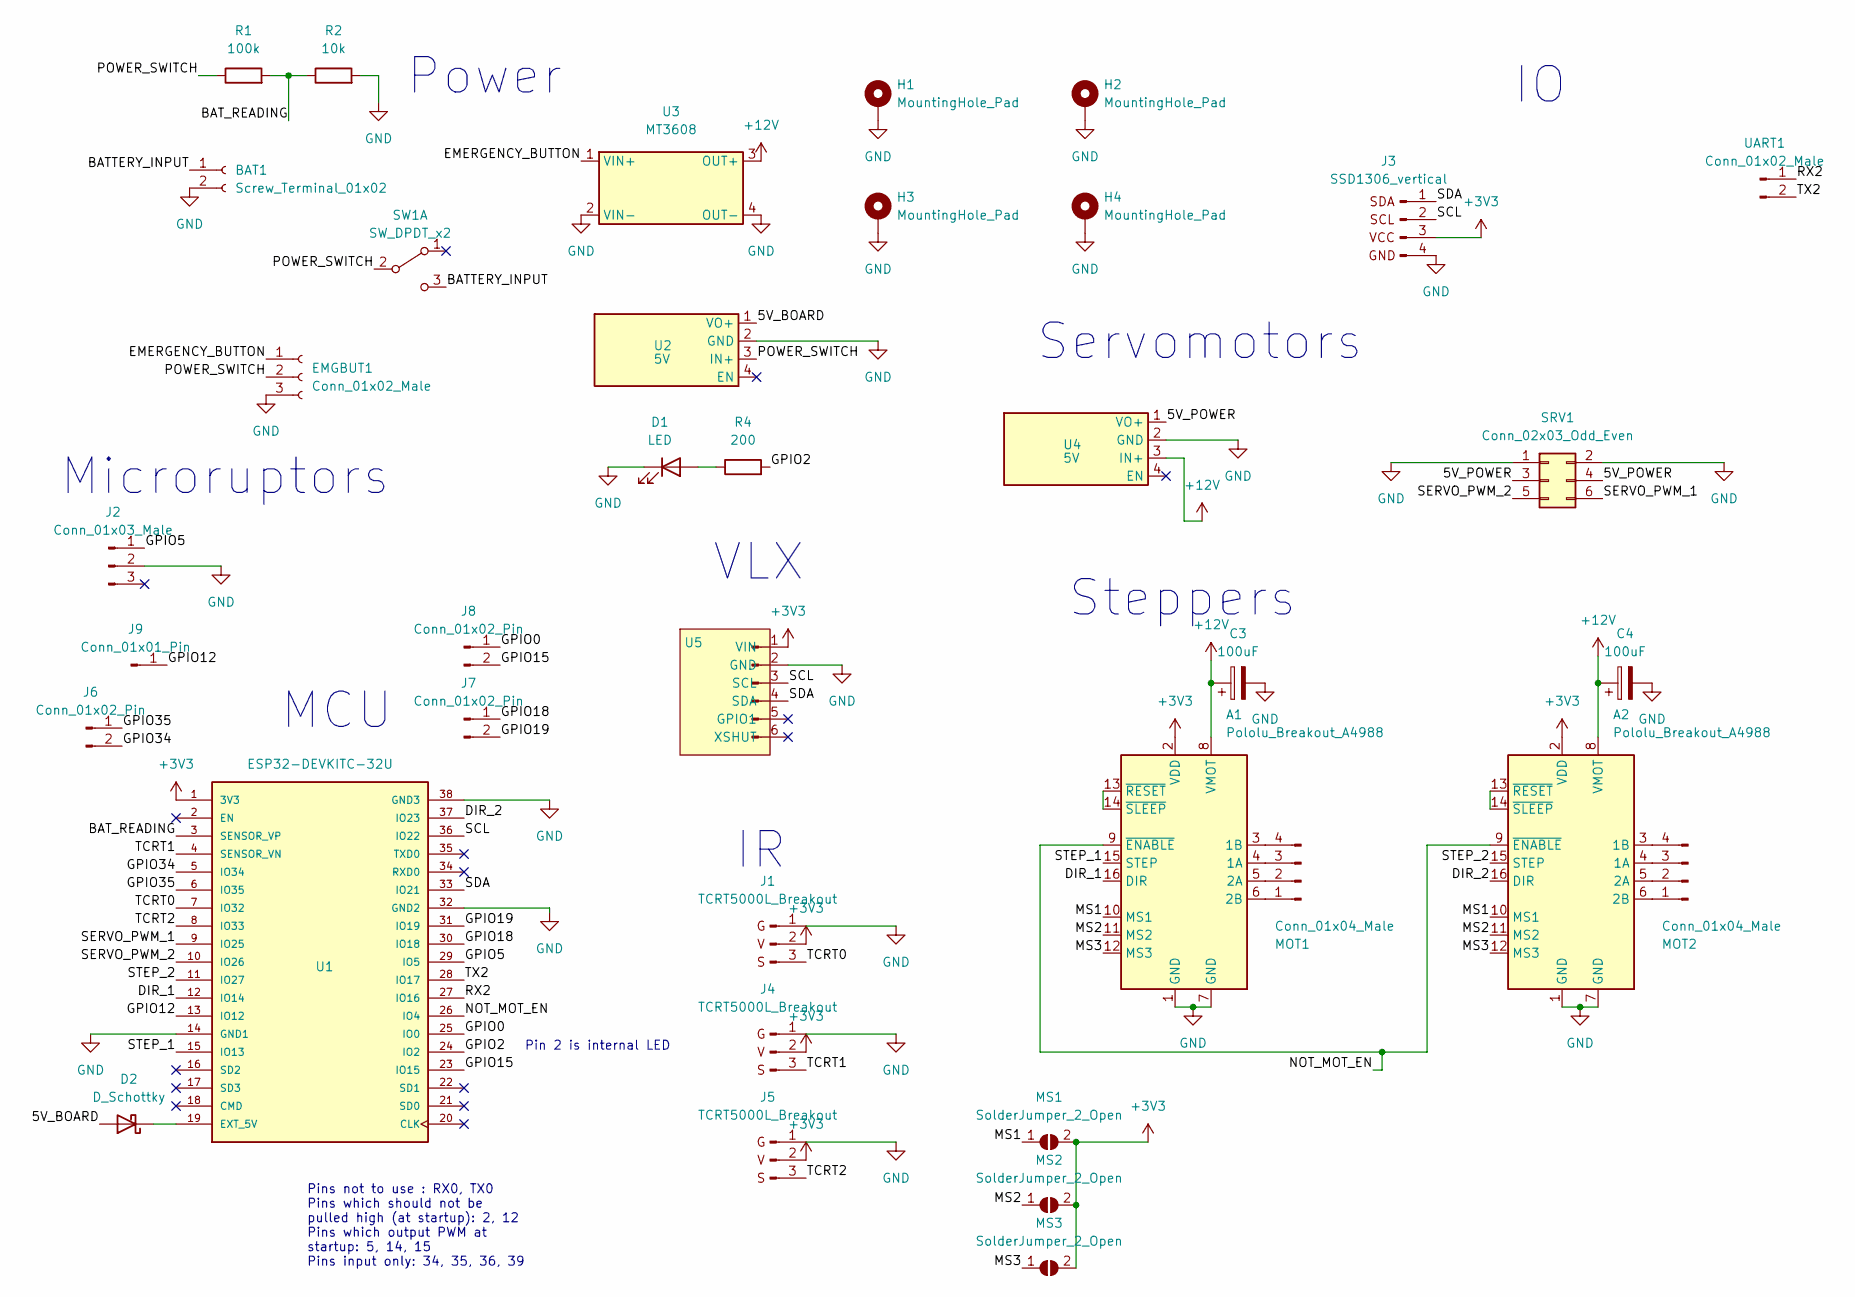
[picture p17: schematic MiAM_PAMI_V3_Stepper.kicad_sch]

Parts:
A1, A2: Pololu_Breakout_A4988; Pololu_Breakout-16_15.2x20.3mm
BAT1: Screw_Terminal_01x02; JST_PH_B2B-PH-K_1x02_P2.00mm_Vertical
C3, C4: 100uF; CP_Radial_D6.3mm_P2.50mm
D1: LED; LED_D3.0mm
D2: D_Schottky; D_SOD-323_HandSoldering
EMGBUT1: Conn_01x02_Male; JST_PH_B3B-PH-K_1x03_P2.00mm_Vertical
H1, H2, H3, H4: MountingHole_Pad; MountingHole_3.2mm_M3_DIN965_Pad
J1, J4, J5: TCRT5000L_Breakout
J2: Conn_01x03_Male; Microruptor
J3: SSD1306_vertical
J6, J7, J8: Conn_01x02_Pin; PinHeader_1x02_P2.54mm_Vertical
J9: Conn_01x01_Pin; PinHeader_1x01_P2.54mm_Vertical
MOT1, MOT2: Conn_01x04_Male; JST_SH_BM04B-SRSS-TB_1x04-1MP_P1.00mm_Vertical
MS1, MS2, MS3: SolderJumper_2_Open; SolderJumper-2_P1.3mm_Open_RoundedPad1.0x1.5mm
R1: 100k; R_0805_2012Metric_Pad1.20x1.40mm_HandSolder
R2: 10k; R_0805_2012Metric_Pad1.20x1.40mm_HandSolder
R4: 200; R_0805_2012Metric
SRV1: Conn_02x03_Odd_Even; PinHeader_2x03_P2.54mm_Vertical
SW1: SW_DPDT_x2; SS-12D11
U1: ESP32-DEVKITC-32U; ESP32U-ShieldPattern
U2, U4: 5V; VoltageRegulator
U3: MT3608
U5: PinHeader_1x06_P2.54mm_Vertical
UART1: Conn_01x02_Male; PinHeader_1x02_P2.54mm_Vertical

Connections:
+3V3: A1.2 (VDD), A2.2 (VDD), J1.2 (V), J3.3 (VCC), J4.2 (V), J5.2 (V), MS1.2 (B), MS2.2 (B), MS3.2 (B), U1.1 (3V3), U5.1 (VIN)
+12V: A1.8 (VMOT), A2.8 (VMOT), C3.1, C4.1, U3.3 (OUT+), U4.3 (IN+)
/5V_BOARD: D2.2 (A), U2.1 (VO+)
/5V_POWER: SRV1.3, SRV1.4, U4.1 (VO+)
/BATTERY_INPUT: BAT1.1, SW1.3 (C)
/BAT_READING: R1.2, R2.1, U1.3 (SENSOR_VP)
/DIR_1: A1.16 (DIR), U1.12 (IO14)
/DIR_2: A2.16 (DIR), U1.37 (IO23)
/EMERGENCY_BUTTON: EMGBUT1.1, U3.1 (VIN+)
/GPIO0: J8.1, U1.25 (IO0)
/GPIO2: R4.2, U1.24 (IO2)
/GPIO5: J2.1, U1.29 (IO5)
/GPIO12: J9.1, U1.13 (IO12)
/GPIO15: J8.2, U1.23 (IO15)
/GPIO18: J7.1, U1.30 (IO18)
/GPIO19: J7.2, U1.31 (IO19)
/GPIO34: J6.2, U1.5 (IO34)
/GPIO35: J6.1, U1.6 (IO35)
/MS1: A1.10 (MS1), A2.10 (MS1), MS1.1 (A)
/MS2: A1.11 (MS2), A2.11 (MS2), MS2.1 (A)
/MS3: A1.12 (MS3), A2.12 (MS3), MS3.1 (A)
/NOT_MOT_EN: A1.9 (~ENABLE), A2.9 (~ENABLE), U1.26 (IO4)
/POWER_SWITCH: EMGBUT1.2, R1.1, SW1.2 (B), U2.3 (IN+)
/RX2: U1.27 (IO16), UART1.1
/SCL: J3.2 (SCL), U1.36 (IO22), U5.3 (SCL)
/SDA: J3.1 (SDA), U1.33 (IO21), U5.4 (SDA)
/SERVO_PWM_1: SRV1.6, U1.9 (IO25)
/SERVO_PWM_2: SRV1.5, U1.10 (IO26)
/STEP_1: A1.15 (STEP), U1.15 (IO13)
/STEP_2: A2.15 (STEP), U1.11 (IO27)
/TCRT0: J1.3 (S), U1.7 (IO32)
/TCRT1: J4.3 (S), U1.4 (SENSOR_VN)
/TCRT2: J5.3 (S), U1.8 (IO33)
/TX2: U1.28 (IO17), UART1.2
GND: A1.1 (GND), A1.7 (GND), A2.1 (GND), A2.7 (GND), BAT1.2, C3.2, C4.2, D1.1 (K), EMGBUT1.3, H1.1, H2.1, H3.1, H4.1, J1.1 (G), J2.2, J3.4 (GND), J4.1 (G), J5.1 (G), R2.2, SRV1.1, SRV1.2, U1.14 (GND1), U1.32 (GND2), U1.38 (GND3), U2.2 (GND), U3.2 (VIN-), U3.4 (OUT-), U4.2 (GND), U5.2 (GND)
unnamed: A1.4 (1A), MOT1.3
unnamed: A1.3 (1B), MOT1.4
unnamed: A1.5 (2A), MOT1.2
unnamed: A1.6 (2B), MOT1.1
unnamed: A1.13 (~RESET), A1.14 (~SLEEP)
unnamed: A2.4 (1A), MOT2.3
unnamed: A2.3 (1B), MOT2.4
unnamed: A2.5 (2A), MOT2.2
unnamed: A2.6 (2B), MOT2.1
unnamed: A2.13 (~RESET), A2.14 (~SLEEP)
unnamed: D1.2 (A), R4.1
unnamed: D2.1 (K), U1.19 (EXT_5V)

Notes on the sheet:
Pins not to use : RX0, TX0 Pins which should not be pulled high (at startup): 2, 12 Pins which output PWM at startup: 5, 14, 15 Pins input only: 34, 35, 36, 39
Power
MCU
Microruptors
Pin 2 is internal LED
VLX
Steppers
Servomotors

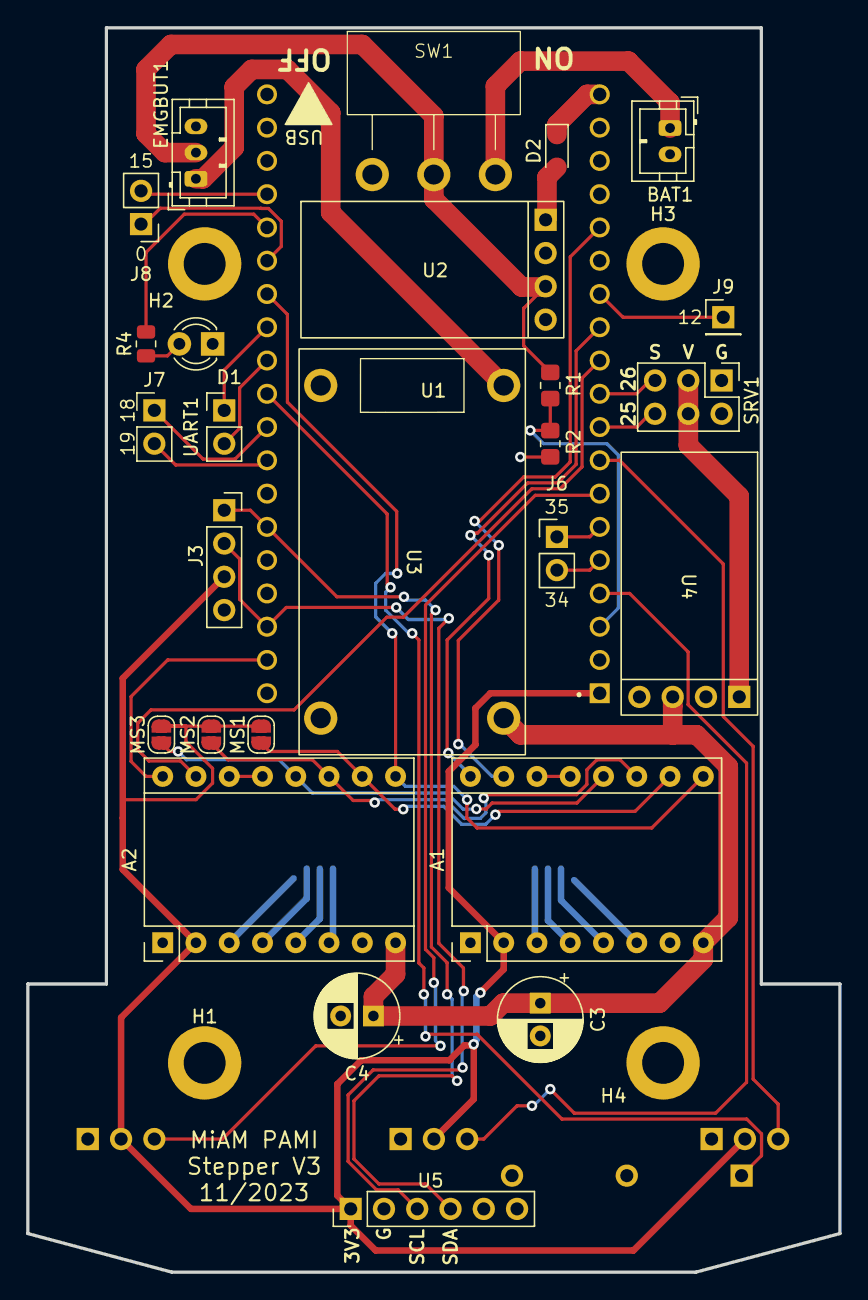
[picture p18: board MiAM_PAMI_V3_Stepper.kicad_pcb from above]

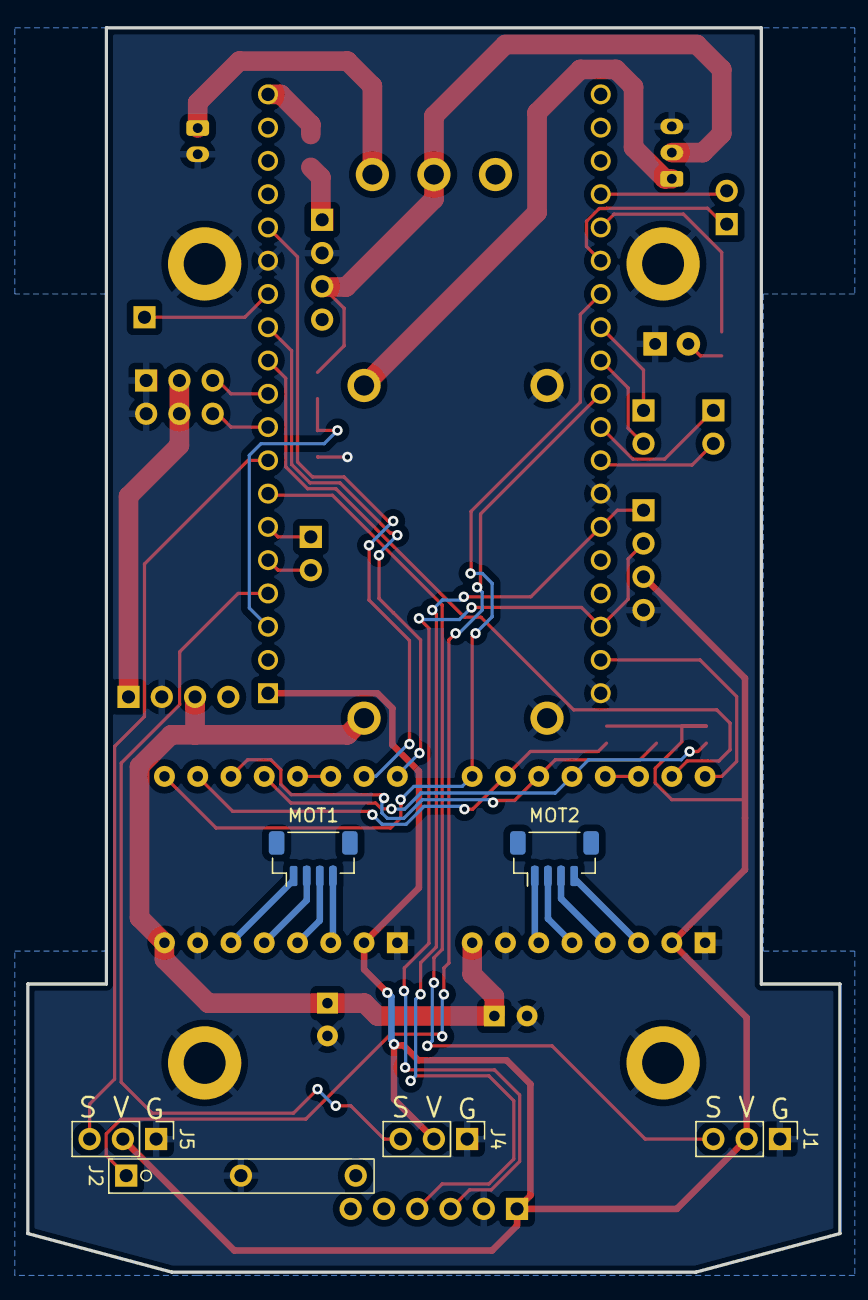
[picture p19: board MiAM_PAMI_V3_Stepper.kicad_pcb from below]

Board: 2 copper layers, 62.0 x 95.0 mm, 37 parts (6 on the bottom side), 47 nets.
