14chanwa/MiAM_robotics_ESP32/Electronics/eurobot2023/MiAM_PAMI_DCShield/MiAM_PAMI_DCShield.kicad_pcb

## KiCad design Electronics/eurobot2023/MiAM_PAMI_DCShield/MiAM_PAMI_DCShield.kicad_pcb (2023-11-01)

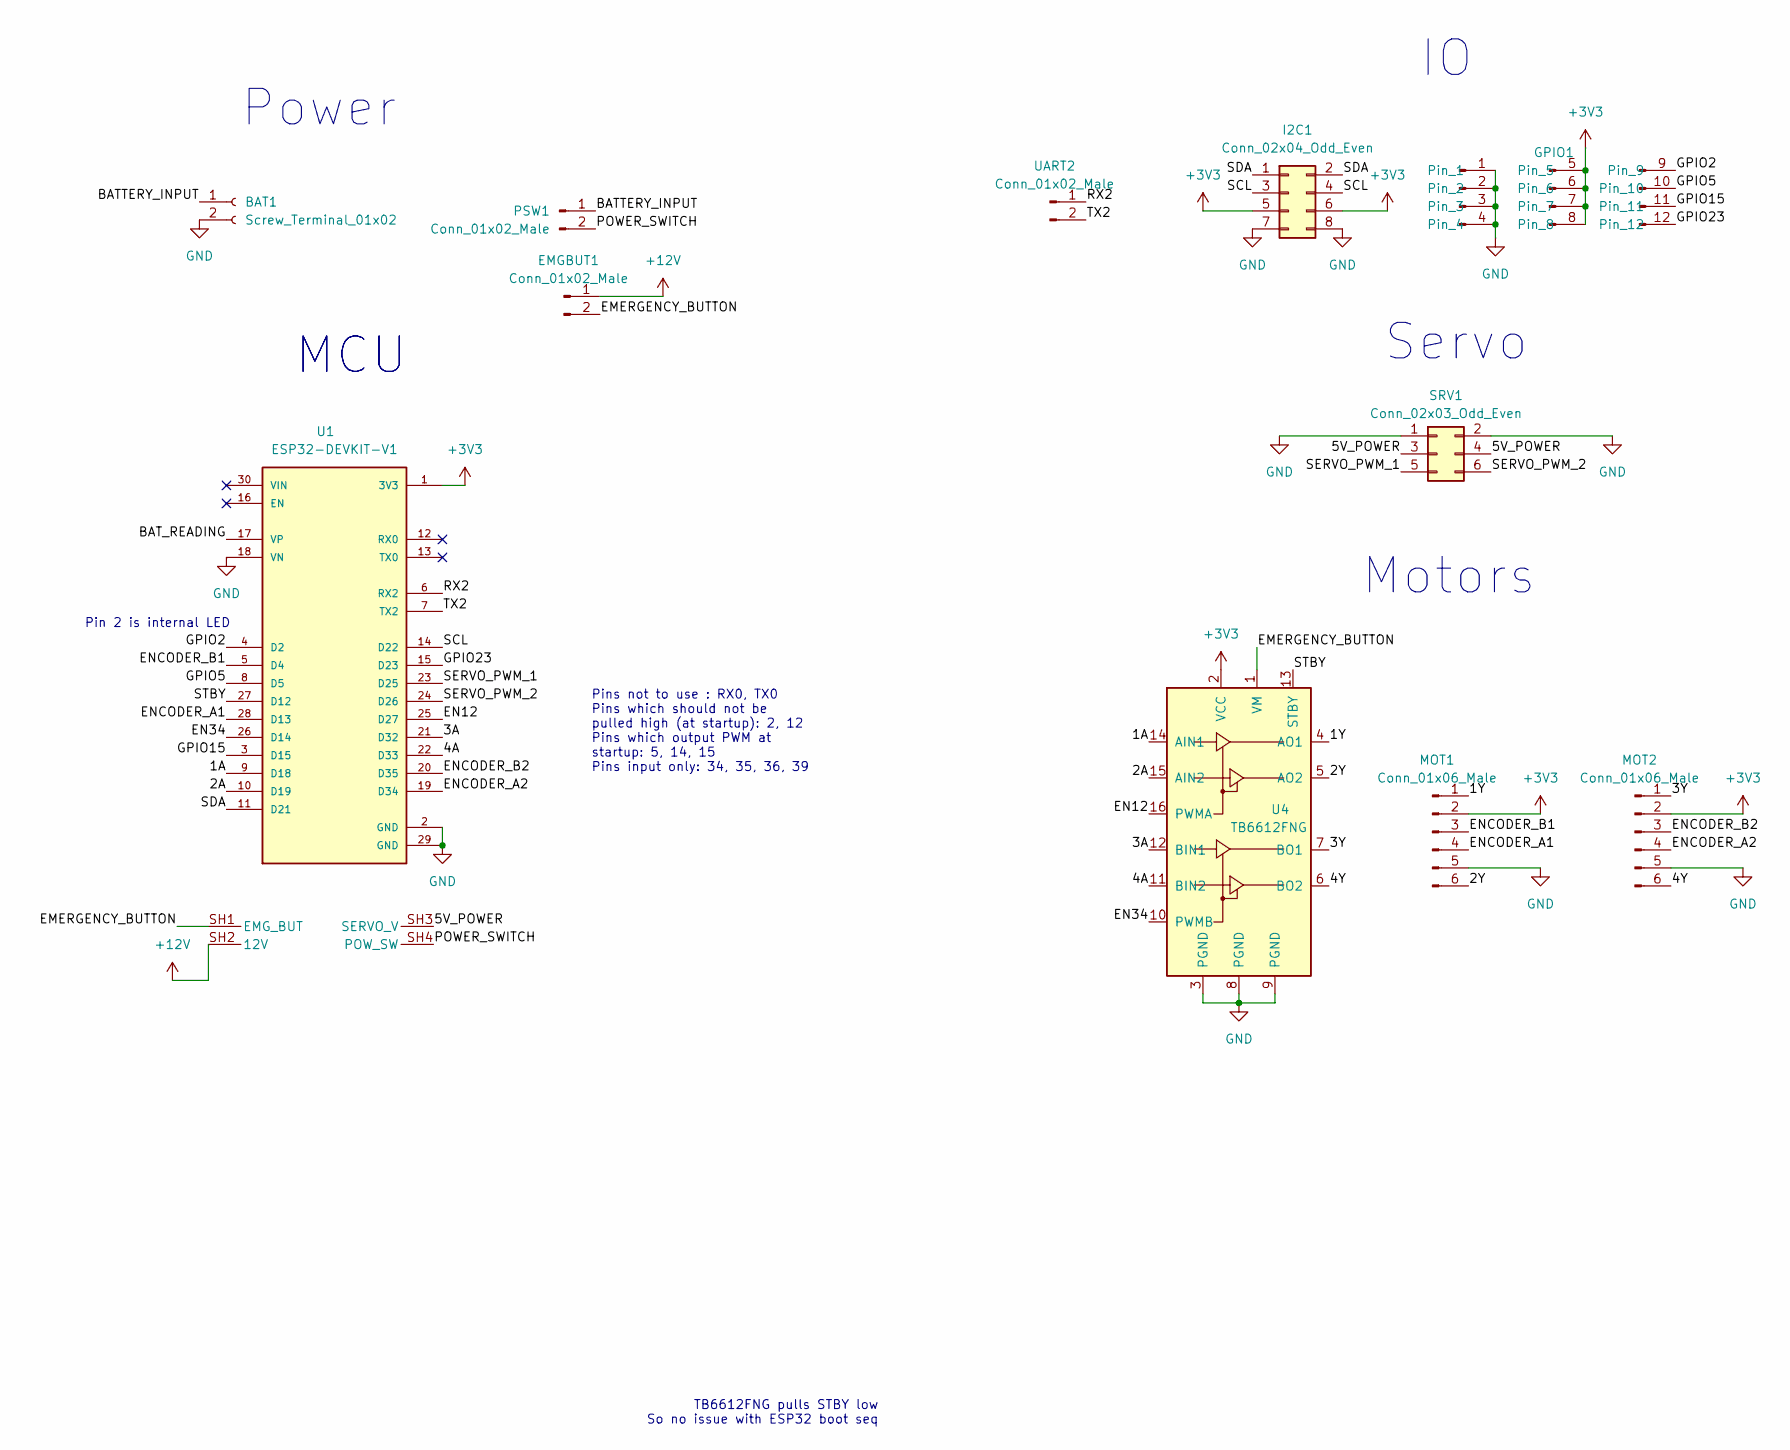
[picture p20: schematic MiAM_PAMI_DCShield.kicad_sch]

Parts:
BAT1: Screw_Terminal_01x02; JST_PH_B2B-PH-K_1x02_P2.00mm_Vertical
EMGBUT1: Conn_01x02_Male; PinHeader_1x02_P2.54mm_Vertical
GPIO1: PinHeader_3x4_P2.54mm_Vertical
I2C1: Conn_02x04_Odd_Even; PinHeader_2x04_P2.54mm_Vertical
MOT1, MOT2: Conn_01x06_Male; PinHeader_1x06_P2.54mm_Vertical
PSW1: Conn_01x02_Male; PinHeader_1x02_P2.54mm_Vertical
SRV1: Conn_02x03_Odd_Even; PinHeader_2x03_P2.54mm_Vertical
U1: ESP32-DEVKIT-V1; ESP32_ShieldPattern; PARTREV N/A
U4: TB6612FNG
UART2: Conn_01x02_Male; PinHeader_1x02_P2.54mm_Vertical

Connections:
+3V3: GPIO1.5, GPIO1.6, GPIO1.7, GPIO1.8, I2C1.5, I2C1.6, MOT1.2, MOT2.2, U1.1 (3V3), U4.2 (VCC)
+12V: EMGBUT1.1, U1.SH2 (12V)
/1A: U1.9 (D18), U4.14 (AIN1)
/1Y: MOT1.1, U4.4 (AO1)
/2A: U1.10 (D19), U4.15 (AIN2)
/2Y: MOT1.6, U4.5 (AO2)
/3A: U1.21 (D32), U4.12 (BIN1)
/3Y: MOT2.1, U4.7 (BO1)
/4A: U1.22 (D33), U4.11 (BIN2)
/4Y: MOT2.6, U4.6 (BO2)
/5V_POWER: SRV1.3, SRV1.4, U1.SH3 (SERVO_V)
/BATTERY_INPUT: BAT1.1, PSW1.1
/BAT_READING: U1.17 (VP)
/EMERGENCY_BUTTON: EMGBUT1.2, U1.SH1 (EMG_BUT), U4.1 (VM)
/EN12: U1.25 (D27), U4.16 (PWMA)
/EN34: U1.26 (D14), U4.10 (PWMB)
/ENCODER_A1: MOT1.4, U1.28 (D13)
/ENCODER_A2: MOT2.4, U1.19 (D34)
/ENCODER_B1: MOT1.3, U1.5 (D4)
/ENCODER_B2: MOT2.3, U1.20 (D35)
/GPIO2: GPIO1.9, U1.4 (D2)
/GPIO5: GPIO1.10, U1.8 (D5)
/GPIO15: GPIO1.11, U1.3 (D15)
/GPIO23: GPIO1.12, U1.15 (D23)
/POWER_SWITCH: PSW1.2, U1.SH4 (POW_SW)
/RX2: U1.6 (RX2), UART2.1
/SCL: I2C1.3, I2C1.4, U1.14 (D22)
/SDA: I2C1.1, I2C1.2, U1.11 (D21)
/SERVO_PWM_1: SRV1.5, U1.23 (D25)
/SERVO_PWM_2: SRV1.6, U1.24 (D26)
/STBY: U1.27 (D12), U4.13 (STBY)
/TX2: U1.7 (TX2), UART2.2
GND: BAT1.2, GPIO1.1, GPIO1.2, GPIO1.3, GPIO1.4, I2C1.7, I2C1.8, MOT1.5, MOT2.5, SRV1.1, SRV1.2, U1.2 (GND), U1.18 (VN), U1.29 (GND), U4.3 (PGND), U4.8 (PGND), U4.9 (PGND)

Notes on the sheet:
Pin 2 is internal LED
Power
MCU
Servo
TB6612FNG pulls STBY low So no issue with ESP32 boot seq
Motors
Pins not to use : RX0, TX0 Pins which should not be pulled high (at startup): 2, 12 Pins which output PWM at startup: 5, 14, 15 Pins input only: 34, 35, 36, 39

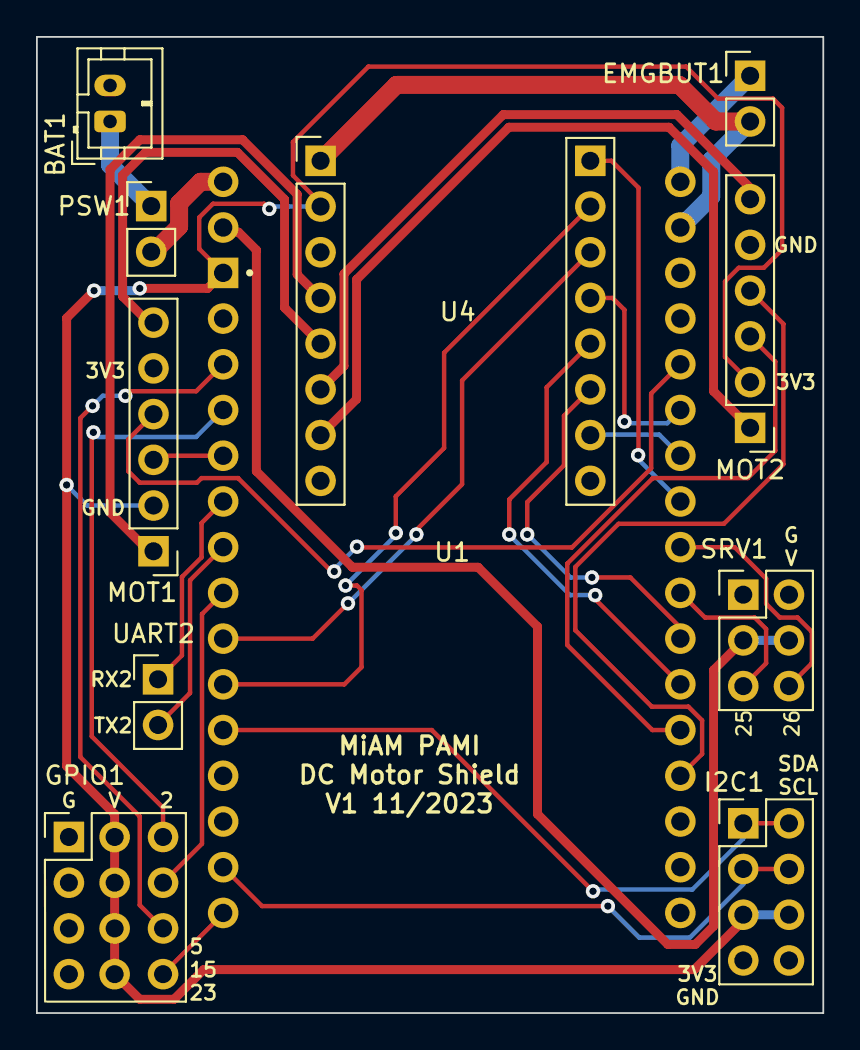
[picture p21: board MiAM_PAMI_DCShield.kicad_pcb from above]

Board: 2 copper layers, 43.7 x 54.2 mm, 11 parts (0 on the bottom side), 32 nets.
