14chanwa/MiAM_robotics_ESP32/Electronics/eurobot2023/MiAM_PAMI_PowerShield/MiAM_PAMI_PowerShield.kicad_pcb

## KiCad design Electronics/eurobot2023/MiAM_PAMI_PowerShield/MiAM_PAMI_PowerShield.kicad_pcb (2023-11-01)

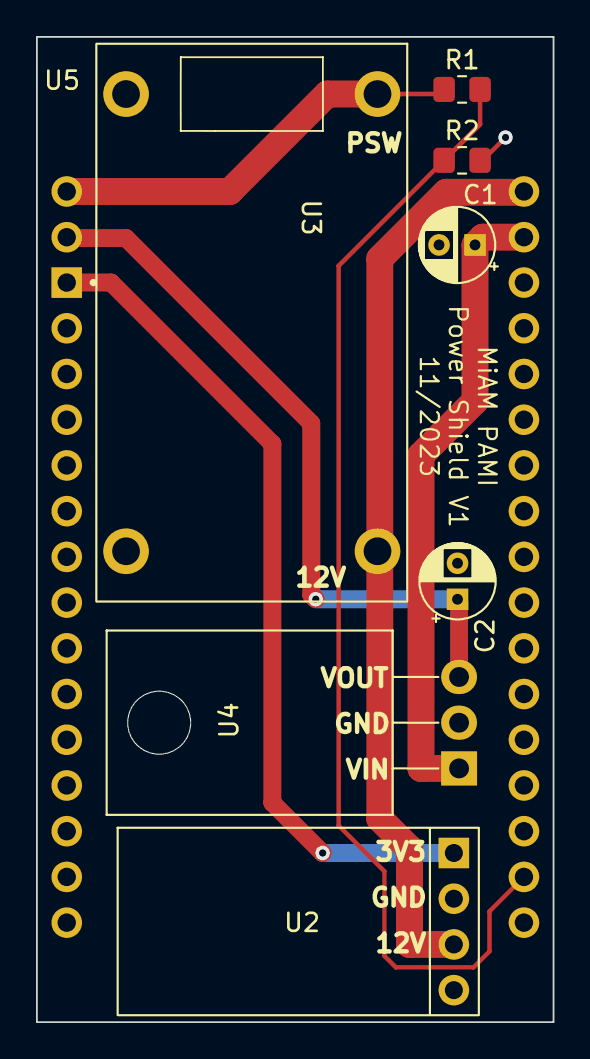
[picture p22: board MiAM_PAMI_PowerShield.kicad_pcb from above]

Board: 2 copper layers, 28.7 x 54.7 mm, 8 parts (0 on the bottom side), 7 nets.

Parts:
C1: 0.22uF; CP_Radial_D4.0mm_P2.00mm
C2: 0.1uF; CP_Radial_D4.0mm_P2.00mm
R1: 100k; R_0805_2012Metric_Pad1.20x1.40mm_HandSolder
R2: 10k; R_0805_2012Metric_Pad1.20x1.40mm_HandSolder
U2: 3V3; VoltageRegulator
U3: MT3608
U4: LM7805_TO220; TO-220-3_Horizontal_TabDown
U5: ESP32-DEVKIT-V1; ESP32_ShieldPattern

Connections:
+3V3: U2.1 (VO+), U5.1 (3V3)
+12V: U2.3 (IN+), U3.3 (OUT+), U5.SH2 (12V)
/5V_POWER: C2.1, U4.3 (VO), U5.SH3 (SERVO_V)
/BAT_READING: R1.2, R2.1, U5.17 (VP)
/EMERGENCY_BUTTON: C1.1, U4.1 (VI), U5.SH1 (EMG_BUT)
/POWER_SWITCH: R1.1, U3.1 (VIN+), U5.SH4 (POW_SW)
GND: C1.2, C2.2, R2.2, U2.2 (GND), U3.2 (VIN-), U3.4 (OUT-), U4.2 (GND), U5.18 (VN), U5.29 (GND)
