14chanwa/MiAM_robotics_ESP32/Electronics/eurobot2023/MiAM_TCRT5000L/MiAM_TCRT5000L.kicad_pcb

## KiCad design Electronics/eurobot2023/MiAM_TCRT5000L/MiAM_TCRT5000L.kicad_pcb (2023-11-29)

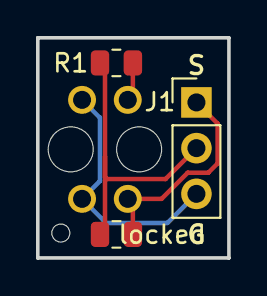
[picture p23: board MiAM_TCRT5000L.kicad_pcb from above]

Board: 2 copper layers, 10.6 x 12.2 mm, 4 parts (1 on the bottom side), 4 nets.

Parts:
IC1: TCRT5000L
J1: Conn_01x03_Pin; PinHeader_1x03_P2.54mm_Vertical
R1: 100; R_0805_2012Metric
locked: 5000; R_0805_2012Metric

Connections:
+3V3: J1.2, R1.1, locked.1
/S: IC1.1 (COLLECTOR), J1.1, locked.2
GND: IC1.2 (EMITTER), IC1.3 (CATHODE), J1.3
unnamed: IC1.4 (ANODE), R1.2
