14chanwa/MiAM_robotics_ESP32/Code/eurobot2026/RobotCode/src/main.cpp

#include <Arduino.h>
#include <parameters.hpp>
#include <DrivetrainKinematics.h>
#include <RobotPosition.h>
#include <Trajectory.h>
#include <StraightLine.h>
#include <PointTurn.h>
#include <Utilities.h>
#include <SampledTrajectory.h>

#include <Robot.hpp>

#include <Strategy.hpp>
#include <AnalogReadings.hpp>
#include <ServoHandler.hpp>
#include <I2CHandler.hpp>
#include <WiFiHandler.hpp>
#include <HeartbeatHandler.hpp>
#include <MessageHandler.hpp>
#include <TelemetryHandler.hpp>

//#define DEBUG_MODE_SIMPLE_TRAJECTORY
//#define DEBUG_MODE_SERVO


/////////////////////////////////////////////////////////////////////
// Tasks
/////////////////////////////////////////////////////////////////////

using namespace miam;
using namespace miam::trajectory;

/////////////////////////////////////////////////////////////////////
// Setup
/////////////////////////////////////////////////////////////////////


//#define DEBUG_MODE_SIMPLE_TRAJECTORY

void setup()
{
  Serial.begin(115200);
  Serial.println("Setup begin");
  vTaskDelay(1000 / portTICK_PERIOD_MS);

  Robot::init();

  // start heartbeat
  HeartbeatHandler::start_heartbeat();

  // Serial.println("Attempt connect WiFi");
  
  // // connect wifi
  // WiFiHandler::initWiFi();

  // Init i2c peripherals
#if PAMI_ID != 5
  I2CHandler::init();
#endif

  // analog readings: monitor battery and infrared captors
  Serial.println("Init analog readings");
  AnalogReadings::init();

  // init the ServoHandler
  ServoHandler::init();
  ServoHandler::servoUp();

  Serial.println("Low Level Loop");
  Robot::startLowLevelLoop();

  // TelemetryHandler::begin();

#ifdef DEBUG_MODE_MATCH
  match_started = true;
  match_current_time_s = 85.0f;  
#endif
#ifdef DEBUG_MODE_SERVO
  //taskYIELD();
  Robot* robot = Robot::getInstance();
  for(;;)
  {
    // for(int posDegrees = 0; posDegrees <= 180; posDegrees++) {
    //   ServoHandler::servoWrite(posDegrees);
    //   // Serial.println(posDegrees);
    //   delay(20);
    // }
    robot->currentRobotState_ = RobotState::MATCH_ENDED;
    taskYIELD();
  }
#endif 
#ifdef DEBUG_MODE_SIMPLE_TRAJECTORY
  // taskYIELD();
  Robot* robot = Robot::getInstance();
  for (;;)
  {
    Serial.println("Moving...");
    strategy::go_forward(robot->motionController, 300);
    robot->currentRobotState_ = RobotState::MOVING_SETUP_TRAJECTORY;
    robot->motionController->waitForTrajectoryFinished();
    // strategy::go_to_zone_3(motionController);

    vTaskDelay(5000 / portTICK_PERIOD_MS);
  }
#endif

  // MessageHandler::startListening();
  MessageHandler::startReportBroadcast();
}

void loop()
{
  for(;;)
  {
    taskYIELD();
    vTaskDelay(10000 / portTICK_PERIOD_MS);
  }
  
}
