14chanwa/MiAM_robotics_ESP32/Code/eurobot2026/RobotCode/src/MotionControllerSlowdown.cpp

#include <MotionController.hpp>
#include <Utilities.h>
#include <Strategy.hpp>
#include <parameters.hpp>

#define MIN_RANGE 100
#define MAX_RANGE 300

#define BORDER_RANGE_IGNORE 50
#define TABLE_MAX_X 3000
#define TABLE_MAX_Y 2000

#define SLOWDOWN_KEEP_GOING 0.9f

float MotionController::computeObstacleAvoidanceSlowdown(float vlx_range_detection_mm, bool const &hasMatchStarted)
{

    float coeff = 1.0f;

    // if going backwards, do not slow down
    if (!currentTrajectories_.empty() && 
        (
            // back
            currentTrajectories_.front()->getCurrentPoint(curvilinearAbscissa_).linearVelocity < 0.0f ||
            // point turn
            std::abs(currentTrajectories_.front()->getCurrentPoint(curvilinearAbscissa_).linearVelocity) < 1e-3
        )
    )
    {
        return 1.0f;
    }

    if (vlx_range_detection_mm <= MIN_RANGE)
    {
#if (PAMI_ID == 1 || PAMI_ID == 5 || PAMI_ID == 4)
        // No vlx avoidance for this PAMI
        coeff = 1.0; //SLOWDOWN_KEEP_GOING;
#else
        coeff = 0.0f;
#endif
    }
    else if (vlx_range_detection_mm < MAX_RANGE)
    {
        coeff = (vlx_range_detection_mm - MIN_RANGE) / (MAX_RANGE - MIN_RANGE);
// #if (PAMI_ID == 4 || PAMI_ID == 5)
//         coeff = std::max(coeff, SLOWDOWN_KEEP_GOING);
// #endif
    }

    // if detected point is outside of table (+- 5 cm), keep going
    RobotPosition coordinates_of_detected_point = getCurrentPosition();
    coordinates_of_detected_point.x += std::cos(coordinates_of_detected_point.theta) * vlx_range_detection_mm;
    coordinates_of_detected_point.y += std::sin(coordinates_of_detected_point.theta) * vlx_range_detection_mm;

    if (
        coordinates_of_detected_point.x <= BORDER_RANGE_IGNORE || 
        coordinates_of_detected_point.x >= TABLE_MAX_X - BORDER_RANGE_IGNORE ||
        coordinates_of_detected_point.y <= BORDER_RANGE_IGNORE ||
        coordinates_of_detected_point.y >= TABLE_MAX_Y - BORDER_RANGE_IGNORE
    )
    {
        coeff = std::max(coeff, 0.75f);
    }

    // if (mirrored) point is in the end zone, continue
    if (
        strategy::position_in_end_zone(coordinates_of_detected_point)
    )
    {
        coeff = std::max(coeff, SLOWDOWN_KEEP_GOING);
    }


    // vlx detection range should be taken into account less if the robot is currently turning
    // apply a coefficient cos(angularVelocity)
    if (coeff <= 0.65)
    {
        float currentAngularVelocity = 0.0;
        if (!currentTrajectories_.empty())
        {
            currentAngularVelocity = currentTrajectories_.front()->getCurrentPoint(curvilinearAbscissa_).angularVelocity;
        }
        coeff = (coeff < 1.0 ? (1-cos(currentAngularVelocity)) * 0.65f + cos(currentAngularVelocity) * coeff : coeff);
    }

    return coeff;
}
