14chanwa/MiAM_robotics_ESP32/Code/eurobot2026/SquirelCode/include/ServoHandler.hpp

#ifndef _SERVO_HANDLER_HPP
#define _SERVO_HANDLER_HPP


namespace ServoHandler
{
    void init();
    // void servoWrite(float angle);
    // void servoUp();
    // void servoDown();

    void armPositionUp();
    void armPositionUpWithCrate();
    void armPositionUpHorizontal();
    void armPositionDown();
    void armPositionMid();
    void armPositionFold();
    void pumpOn();
    void pumpOff();

    void armPositionFunnyUp();
    void armPositionFunnyDown();
}

#endif
