14chanwa/MiAM_robotics_ESP32/Code/eurobot2025/AvoidanceRobot/include/StepperHandler.hpp

#ifndef _STEPPER_HANDLER_H
#define _STEPPER_HANDLER_H

#include <L6470Driver.h>

namespace stepper_handler
{
    bool is_inited();
    bool init(int maxSpeed, int maxAcceleration, miam::L6470_STEP_MODE stepMode);

    void setSpeed(float rightValue, float leftValue);

    miam::L6470* getStepperMotors();
}

#endif
