14chanwa/MiAM_robotics_ESP32/Code/CommonLibraries/message/Message.hpp

#ifndef _MESSAGE_HPP
#define _MESSAGE_HPP

#include <Utilities.h>
#include <memory>
#include <RobotPosition.h>

/*
Messages from SCD to PAMI can be of categories:
- configuration message: set side (right side, left side)
- immediate new trajectory: pami should execute traj immediatly (i.e. setup trajectory)
- match state message: whether match started and currrent match time
- alternative travel trajectory: replanified trajectory to objective 

Messages from PAMI to SCD can be of categories:
- pami report message
*/

using namespace miam::trajectory;
using namespace miam;

enum MessageType
{
    CONFIGURATION = 0,
    NEW_TRAJECTORY = 1,
    MATCH_STATE = 2,
    FULL_MATCH_STATE = 3,
    PAMI_REPORT = 10,
    FULL_PAMI_REPORT = 11,
    ERROR = 99
};

enum PlayingSide
{
    BLUE_SIDE = 0,
    YELLOW_SIDE = 1
};

class Message
{
public:
    MessageType get_message_type() { return messageType_; }
    uint8_t get_sender_id() { return senderId_; }

    static std::shared_ptr<Message > parse(const uint8_t* message, int sizeOfMessage, uint8_t senderId = 255);

    virtual int serialize(uint8_t* results, int maxsize) = 0;
    
    static uint get_expected_size() { return 2; }

private:
    MessageType messageType_;
    uint8_t senderId_;
    
    Message(MessageType mt, uint8_t senderId = 255) : messageType_(mt), senderId_(senderId) {};

    void write_header(uint8_t* results, uint& byte_index);
    void read_header(const uint8_t* buffer, uint& byte_index);

    friend class ConfigurationMessage;
    friend class MatchStateMessage;
    friend class NewTrajectoryMessage;
    friend class ErrorMessage;
    friend class PamiReportMessage;
    friend class FullMatchStateMessage;
    friend class FullPamiReportMessage;
};

/* Specialized messages */

// CONFIGURATION
class ConfigurationMessage : public Message
{
public:
    ConfigurationMessage(PlayingSide playingSide, bool stopMotors, uint8_t senderId = 255) :
        Message(MessageType::CONFIGURATION, senderId),
        playingSide_(playingSide),
        stopMotors_(stopMotors) {};
    ConfigurationMessage(const uint8_t* buffer, const uint size);
    
    int serialize(uint8_t* results, int maxsize);
    static uint get_expected_size() { return Message::get_expected_size() + 2; }

    PlayingSide playingSide_;
    bool stopMotors_;
};

// NEW TRAJECTORY
class NewTrajectoryMessage : public Message
{
public:
    NewTrajectoryMessage(TrajectoryVector trajectory, uint8_t senderId = 255) :
        Message(MessageType::NEW_TRAJECTORY, senderId),
        newTrajectory_(trajectory) {};
    NewTrajectoryMessage(const uint8_t* buffer, const uint size);

    int serialize(uint8_t* results, int maxsize);
    static uint get_expected_size() { return Message::get_expected_size() + 4 + 4 + 5*(1+1); /* Minimum 1 + 1 pts */ }
    
    TrajectoryVector newTrajectory_;
};

// MATCH_STATE
class MatchStateMessage : public Message
{
public:
    MatchStateMessage(bool matchStarted, float matchTime, uint8_t senderId = 255) :
        Message(MessageType::MATCH_STATE, senderId),
        matchStarted_(matchStarted),
        matchTime_(matchTime) {};
    MatchStateMessage(const uint8_t* buffer, const uint size);
    
    int serialize(uint8_t* results, int maxsize);
    static uint get_expected_size() { return Message::get_expected_size() + 1 + 4; }

    bool matchStarted_;
    float matchTime_;
};

// FULL_MATCH_STATE
class FullMatchStateMessage : public Message
{
public:
    FullMatchStateMessage(PlayingSide playingSide, bool matchStarted, float matchTime, uint8_t senderId = 255) :
        Message(MessageType::FULL_MATCH_STATE, senderId),
        playingSide_(playingSide),
        matchStarted_(matchStarted),
        matchTime_(matchTime) {};
    FullMatchStateMessage(const uint8_t* buffer, const uint size);
    
    int serialize(uint8_t* results, int maxsize);
    static uint get_expected_size() { return Message::get_expected_size() + 1 + 1 + 4; }

    PlayingSide playingSide_;
    bool matchStarted_;
    float matchTime_;
};

// ERROR
class ErrorMessage : public Message
{
public:
    ErrorMessage(uint8_t senderId = 255) : Message(MessageType::ERROR, senderId) {};  

    int serialize(uint8_t* results, int maxsize);
};

// PAMI_REPORT
class PamiReportMessage : public Message
{
public:
    PamiReportMessage(
        bool matchStarted, 
        float matchTime, 
        PlayingSide playingSide, 
        float batteryReading,
        uint8_t senderId = 255
    ) : Message(MessageType::PAMI_REPORT, senderId),
        matchStarted_(matchStarted),
        matchTime_(matchTime),
        playingSide_(playingSide),
        batteryReading_(batteryReading) {};
    PamiReportMessage(const uint8_t* buffer, const uint size);
    
    int serialize(uint8_t* results, int maxsize);
    static uint get_expected_size() { return Message::get_expected_size() + 1 + 4 + 1 + 4; }

    bool matchStarted_;
    float matchTime_;
    PlayingSide playingSide_;
    float batteryReading_;
};


// FULL_PAMI_REPORT
class FullPamiReportMessage : public Message
{
public:
    FullPamiReportMessage(
        bool matchStarted, 
        float matchTime, 
        PlayingSide playingSide, 
        float batteryReading,
        RobotPosition currentPosition,
        // float currentLinearVelocity,
        // float currentAngularVelocity,
        uint8_t senderId = 255
    ) : Message(MessageType::FULL_PAMI_REPORT, senderId),
        matchStarted_(matchStarted),
        matchTime_(matchTime),
        playingSide_(playingSide),
        batteryReading_(batteryReading),
        currentPosition_(currentPosition)//,
        // currentLinearVelocity_(currentLinearVelocity),
        // currentAngularVelocity_(currentAngularVelocity) 
        {};
    FullPamiReportMessage(const uint8_t* buffer, const uint size);
    
    int serialize(uint8_t* results, int maxsize);
    static uint get_expected_size() { return Message::get_expected_size() + 1 + 4 + 1 + 4 + 3*4; } // + 5: }

    bool matchStarted_;
    float matchTime_;
    PlayingSide playingSide_;
    float batteryReading_;
    RobotPosition currentPosition_;
    // float currentLinearVelocity_;
    // float currentAngularVelocity_;
};

#endif
