14chanwa/MiAM_robotics_ESP32/Code/eurobot2026/SquirelCode/src/HeartbeatHandler.cpp

#include <Arduino.h>
#include <HeartbeatHandler.hpp>
#include <Strategy.hpp>
#include <Robot.hpp>
#include <LEDTimer.hpp>
#include <vector>
#include <I2CHandler.hpp>

#include <FastLED.h>
#define FASTLED_PIN 0

// LED

#define LED_SLOW_BLINK_MS 1000
#define LED_FAST_BLINK_MS 150

#define LED_PIN 2
#define LED_PWM_CHANNEL 0

#define LED_PWM_FREQUENCY 1000
#define LED_PWM_RESOLUTION 8
#define LED_PWM_HIGH_LEVEL 32

// LED RING
#define LED_RING_BRIGHTNESS 2

// How many leds in your strip?
#define NUM_LEDS 16

// VLX leds constants
#define STOP_RANGE 50
#define STOP_COLOR CRGB(255,0,0)
#define NEAR_RANGE 300
#define NEAR_COLOR CRGB(153,255,51)//(255,128,0)
#define FAR_COLOR CRGB(153,255,51)
#define OFF_COLOR CRGB(178,102,255)


namespace HeartbeatHandler
{
    CRGB leds[NUM_LEDS];

    void task_blink_led(void* parameters)
    {
        FastLED.setBrightness(LED_RING_BRIGHTNESS);
        FastLED.addLeds<WS2812, FASTLED_PIN, GRB>(leds, NUM_LEDS);  // GRB ordering is typical
        
        ledcAttachPin(LED_PIN, LED_PWM_CHANNEL);
        ledcSetup(LED_PWM_CHANNEL, LED_PWM_FREQUENCY, LED_PWM_RESOLUTION);
        
        Robot* robot = Robot::getInstance();
        RobotState ms;

        // Back LED and status led
        PWMLEDTimer status_led_timer(LED_PWM_CHANNEL, LED_PWM_HIGH_LEVEL);
        CRGBLEDTimer status_ring_timer(&(leds[8]));
        status_ring_timer.setColor(CRGB(255,0,0));
        status_ring_timer.setPeriod(500);

        // Side indicator leds
        std::vector<std::shared_ptr<CRGBLEDTimer > > side_indicator_ring_timers;
        side_indicator_ring_timers.push_back(std::make_shared<CRGBLEDTimer >(&(leds[5])));
        side_indicator_ring_timers.push_back(std::make_shared<CRGBLEDTimer >(&(leds[6])));
        side_indicator_ring_timers.push_back(std::make_shared<CRGBLEDTimer >(&(leds[7])));
        side_indicator_ring_timers.push_back(std::make_shared<CRGBLEDTimer >(&(leds[9])));
        side_indicator_ring_timers.push_back(std::make_shared<CRGBLEDTimer >(&(leds[10])));
        side_indicator_ring_timers.push_back(std::make_shared<CRGBLEDTimer >(&(leds[11])));

        // VLX indicator leds
        std::vector<std::shared_ptr<CRGBLEDTimer > > leds_right;
        leds_right.push_back(std::make_shared<CRGBLEDTimer >(&(leds[2])));
        leds_right.push_back(std::make_shared<CRGBLEDTimer >(&(leds[3])));
        leds_right.push_back(std::make_shared<CRGBLEDTimer >(&(leds[4])));
        for (auto timer : leds_right)
        {
            timer->setPeriod(0);
        }
        std::vector<std::shared_ptr<CRGBLEDTimer > > leds_middle;
        leds_middle.push_back(std::make_shared<CRGBLEDTimer >(&(leds[15])));
        leds_middle.push_back(std::make_shared<CRGBLEDTimer >(&(leds[0])));
        leds_middle.push_back(std::make_shared<CRGBLEDTimer >(&(leds[1])));
        for (auto timer : leds_middle)
        {
            timer->setPeriod(0);
        }
        std::vector<std::shared_ptr<CRGBLEDTimer > > leds_left;
        leds_left.push_back(std::make_shared<CRGBLEDTimer >(&(leds[12])));
        leds_left.push_back(std::make_shared<CRGBLEDTimer >(&(leds[13])));
        leds_left.push_back(std::make_shared<CRGBLEDTimer >(&(leds[14])));
        for (auto timer : leds_left)
        {
            timer->setPeriod(0);
        }

        for(;;)
        {
            // Handle status led 
            ms = robot->get_current_robot_state();

            // Led color
            if (ms == RobotState::MATCH_ENDED)
            {
                status_ring_timer.setColor(CRGB(0,255,0));
            }
            else if (ms == RobotState::WAIT_FOR_CONFIGURATION || ms == RobotState::WAIT_FOR_MATCH_START)
            {
                status_ring_timer.setColor(CRGB(178,102,255));
            }
            else
            {
                status_ring_timer.setColor(CRGB(255,0,0));
            }

            // Led period
            if (ms == RobotState::WAIT_FOR_CONFIGURATION)
            {
                // constant ON
                status_led_timer.setPeriod(0);
                status_ring_timer.setPeriod(0);
            }
            else if (ms == RobotState::MATCH_STARTED_WAITING ||
                ms == RobotState::MATCH_STARTED_ACTION ||
                ms == RobotState::MATCH_STARTED_FINAL_APPROACH ||
                ms == RobotState::MOVING_SETUP_TRAJECTORY)
            {
                // blink fast
                status_led_timer.setPeriod(LED_FAST_BLINK_MS);
                status_ring_timer.setPeriod(LED_FAST_BLINK_MS);
            }
            else
            {
                // blink slow
                status_led_timer.setPeriod(LED_SLOW_BLINK_MS);
                status_ring_timer.setPeriod(LED_SLOW_BLINK_MS);
            }
            status_led_timer.update();
            status_ring_timer.update();
            
            // Handle side indicator
            for (auto timer : side_indicator_ring_timers)
            {
                if (robot->motionController->isPlayingRightSide_)
                {
                    timer->setColor(CRGB(255,255,51));
                }
                else
                {
                    timer->setColor(CRGB(0,0,255));
                }

                // Blink if last message was more than 3 sec ago
                if (millis() - robot->lastMessageReceivedTime_ > 3000)
                {
                    timer->setPeriod(300);
                }
                else
                {
                    timer->setPeriod(0);
                }

                timer->update();
            }

            // Handle vlx
            int16_t vlx_value = I2CHandler::get_smoothed_vlx_side(I2CHandler::RIGHT);
            for (auto timer : leds_right)
            {
                if (vlx_value < 0)
                { 
                    timer->setColor(OFF_COLOR);
                }
                else if (vlx_value > NEAR_RANGE)
                {
                    timer->setColor(FAR_COLOR);
                }
                else if (vlx_value > STOP_RANGE)
                {
                    uint8_t prop = (uint8_t) 255 * (1.0 - (vlx_value - STOP_RANGE) / (1.0 * (NEAR_RANGE - STOP_RANGE)));
                    CRGB color = CRGB::blend(NEAR_COLOR, STOP_COLOR, prop);
                    timer->setColor(color);
                }
                else
                {
                    timer->setColor(STOP_COLOR);
                }
                timer->update();
            }
            vlx_value = I2CHandler::get_smoothed_vlx_side(I2CHandler::MIDDLE);
            for (auto timer : leds_middle)
            {
                if (vlx_value < 0)
                { 
                    timer->setColor(OFF_COLOR);
                }
                else if (vlx_value > NEAR_RANGE)
                {
                    timer->setColor(FAR_COLOR);
                }
                else if (vlx_value > STOP_RANGE)
                {
                    uint8_t prop = (uint8_t) 255 * (1.0 - (vlx_value - STOP_RANGE) / (1.0 * (NEAR_RANGE - STOP_RANGE)));
                    CRGB color = CRGB::blend(NEAR_COLOR, STOP_COLOR, prop);
                    timer->setColor(color);
                }
                else
                {
                    timer->setColor(STOP_COLOR);
                }
                timer->update();
            }
            vlx_value = I2CHandler::get_smoothed_vlx_side(I2CHandler::LEFT);
            for (auto timer : leds_left)
            {
                if (vlx_value < 0)
                { 
                    timer->setColor(OFF_COLOR);
                }
                else if (vlx_value > NEAR_RANGE)
                {
                    timer->setColor(FAR_COLOR);
                }
                else if (vlx_value > STOP_RANGE)
                {
                    uint8_t prop = (uint8_t) 255 * (1.0 - (vlx_value - STOP_RANGE) / (1.0 * (NEAR_RANGE - STOP_RANGE)));
                    CRGB color = CRGB::blend(NEAR_COLOR, STOP_COLOR, prop);
                    timer->setColor(color);
                }
                else
                {
                    timer->setColor(STOP_COLOR);
                }
                timer->update();
            }


            FastLED.show();
            vTaskDelay(50 / portTICK_PERIOD_MS);
        }
    }

    void start_heartbeat()
    {
        // start heartbeat
        Serial.println("Launch heartbeat");
        xTaskCreatePinnedToCore(
            task_blink_led, 
            "task_blink_led",
            10000,
            NULL,
            30,
            NULL,
            0 // pin to core 0
        );
    }
}
