14chanwa/MiAM_robotics_ESP32/Code/eurobot2026/RobotCode/src/Strategy_defaults.cpp

#include <Strategy.hpp>
#include <parameters.hpp>

#define SLOW_APPROACH_WHEEL_VELOCITY 75.0f
#define FINAL_TRAJECTORY_DISTANCE_MM 100.0f

// xmin xmax ymin ymax
#define COORD_ZONE_1 960.0, 1250.0, 1380.0, 1540.0
#define COORD_ZONE_2 1300.0, 1750.0, 1300.0, 1540.0
#define COORD_ZONE_3 1740.0, 2000.0, 1380.0, 1540.0

#define PAMI_1_START 45.0, 1615.0, -M_PI_2
#define PAMI_2_START 45.0, 1680.0, 0.0
#define PAMI_3_START 45.0, 1745.0, 0.0
#define PAMI_4_START 45.0, 1900.0, 0.0
#define PAMI_5_START 35.0, 1905.0, 0.0

#define PAMI_1_GOAL 100, 840, 0
#define PAMI_2_GOAL 660, 128, 0
#define PAMI_3_GOAL 760, 840, 0
#define PAMI_4_GOAL 1450, 860, 0
#define PAMI_5_GOAL 1256, 1530, 0

#define PAMI_1_WAIT 0
#define PAMI_2_WAIT 0.0
#define PAMI_3_WAIT 1.5
#define PAMI_4_WAIT 0.0
#define PAMI_5_WAIT 1.5

RobotPosition strategy::get_goal()
{
    return RobotPosition(
#if PAMI_ID == 1
        PAMI_1_GOAL
#elif PAMI_ID == 2
        PAMI_2_GOAL
#elif PAMI_ID == 3
        PAMI_3_GOAL
#elif PAMI_ID == 4
        PAMI_4_GOAL
#elif PAMI_ID == 5
        PAMI_5_GOAL
#endif
    );
}

bool robot_position_in_zone(RobotPosition& position, float xmin, float xmax, float ymin, float ymax)
{
    return (
        position.x >= xmin &&
        position.x <= xmax &&
        position.y >= ymin &&
        position.y <= ymax
    );
}

namespace strategy
{
    float get_waiting_time_s()
    {
        #if PAMI_ID == 1
            return PAMI_1_WAIT;
        #elif PAMI_ID == 2
            return PAMI_2_WAIT;
        #elif PAMI_ID == 3
            return PAMI_3_WAIT;
        #elif PAMI_ID == 4
            return PAMI_4_WAIT;
        #elif PAMI_ID == 5
            return PAMI_5_WAIT;
        #endif
        return 0.0;
    };

    bool position_in_end_zone(RobotPosition position)
    {
        RobotPosition goal(
#if PAMI_ID == 1
            PAMI_1_GOAL
#elif PAMI_ID == 2
            PAMI_2_GOAL
#elif PAMI_ID == 3
            PAMI_3_GOAL
#elif PAMI_ID == 4
            PAMI_4_GOAL
#elif PAMI_ID == 5
            PAMI_5_GOAL
#endif
        );
        return (position - goal).norm() < 300;
        // #if PAMI_ID == 1
        //     return robot_position_in_zone(position, PAMI_1_GOAL);
        // #elif PAMI_ID == 2
        //     return robot_position_in_zone(position, PAMI_2_GOAL;
        // #elif PAMI_ID == 3
        //     return robot_position_in_zone(position, COORD_ZONE_2);
        // #elif PAMI_ID == 4
        //     return robot_position_in_zone(position, COORD_ZONE_1);
        // #endif
        // return false;
    }

    bool position_in_avoidance_exclusion(RobotPosition position)
    {
        return false;
    }

    TrajectoryVector get_default_trajectory(MotionController* motionController)
    {
        RobotPosition startPosition;
        RobotPosition targetPosition;

        TrajectoryVector res;

        TrajectoryVector tv;
        std::vector<RobotPosition > positions;
        TrajectoryConfig tc = motionController->getTrajectoryConfig();

    #if PAMI_ID == 1
        startPosition = RobotPosition(PAMI_1_START);
    #elif PAMI_ID == 2
       startPosition = RobotPosition(PAMI_2_START);
    #elif PAMI_ID == 3
       startPosition = RobotPosition(PAMI_3_START);
    #elif PAMI_ID == 4
       startPosition = RobotPosition(PAMI_4_START);
    #elif PAMI_ID == 5
       startPosition = RobotPosition(PAMI_5_START);  
    #endif

        motionController->resetPosition(startPosition, true, true, true);
        positions.clear();
        positions.push_back(startPosition);
       
    #if PAMI_ID == 3

        targetPosition = RobotPosition(PAMI_3_GOAL);
        RobotPosition tmp = targetPosition;

        tmp = startPosition;
        tmp.x += 150;
        positions.push_back(tmp);
        positions.push_back(targetPosition);
        
        tv = computeTrajectoryRoundedCorner(tc, positions, 200.0);
        res.insert(res.end(), tv.begin(), tv.end());

    #elif PAMI_ID == 2

        targetPosition = RobotPosition(PAMI_2_GOAL);

        RobotPosition tmp = targetPosition;
        tmp = startPosition;
        tmp.x += 150;
        positions.push_back(tmp);
        positions.push_back(targetPosition);
        
        tv = computeTrajectoryRoundedCorner(tc, positions, 200.0);
        res.insert(res.end(), tv.begin(), tv.end());


    #elif PAMI_ID == 4

        targetPosition = RobotPosition(PAMI_4_GOAL);

        RobotPosition tmp = startPosition;
        tmp.x += 200;
        positions.push_back(tmp);
        tmp.x = 644;
        tmp.y = 1280;
        positions.push_back(tmp);
        positions.push_back(targetPosition);
        
        tv = computeTrajectoryRoundedCorner(tc, positions, 150.0);
        res.insert(res.end(), tv.begin(), tv.end());

    #elif PAMI_ID == 1

        targetPosition = RobotPosition(PAMI_1_GOAL);
        
        RobotPosition tmp = startPosition;
        positions.push_back(targetPosition);
        
        tv = computeTrajectoryRoundedCorner(tc, positions, 200.0);
        res.insert(res.end(), tv.begin(), tv.end());

    #elif PAMI_ID == 5

        targetPosition = RobotPosition(PAMI_5_GOAL);

        RobotPosition tmp = startPosition;
        tmp.x += 100;
        positions.push_back(tmp);
        tmp.x = 500;
        tmp.y = 1460;
        positions.push_back(tmp);
        tmp.x = 600;
        tmp.y = 1440;
        positions.push_back(tmp);
        //positions.push_back(targetPosition);
        tv = computeTrajectoryRoundedCorner(tc, positions, 150.0);
        res.insert(res.end(), tv.begin(), tv.end());
        tmp = res.getEndPoint().position;
        tv = computeTrajectoryStraightLine(tc, tmp, 600);
        res.insert(res.end(), tv.begin(), tv.end());

    #endif
        return res;

    };

    TrajectoryVector get_alternative_trajectory(MotionController* motionController)
    {
        RobotPosition startPosition;
        RobotPosition targetPosition;

        TrajectoryVector res;

        TrajectoryVector tv;
        std::vector<RobotPosition > positions;
        TrajectoryConfig tc = motionController->getTrajectoryConfig();
        res = strategy::get_default_trajectory(motionController);
        return res;
    }


    TrajectoryVector get_final_action_trajectory(MotionController* motionController)
    {
        TrajectoryConfig tc = motionController->getTrajectoryConfig();
        TrajectoryVector res;
        RobotPosition currentPosition(motionController->getCurrentPosition());
// #if PAMI_ID == 1
//         std::shared_ptr<Trajectory > pointTurnTowardsLeft(
//         std::make_shared<PointTurn >(
//                 tc, 
//                 currentPosition, 
//                 M_PI)
//         );
//         res.push_back(pointTurnTowardsLeft);
//         currentPosition = res.back()->getEndPoint().position;
// #endif
// #if PAMI_ID == 5
//         // Go forward
//         float distance = 2300;
//         // Movement should be very slow
//         tc.maxWheelVelocity = SLOW_APPROACH_WHEEL_VELOCITY;
//         TrajectoryVector sl = computeTrajectoryStraightLine(tc, currentPosition, distance);
//         res.insert(res.end(), sl.begin(), sl.end());
// #endif

        // Go forward
        float distance = 20;
        // Movement should be very slow
        tc.maxWheelVelocity = SLOW_APPROACH_WHEEL_VELOCITY;
        TrajectoryVector sl = computeTrajectoryStraightLine(tc, currentPosition, distance);
        res.insert(res.end(), sl.begin(), sl.end());
        for (auto traj : res)
        {
            traj->setAvoidanceEnabled(false);
        }
        return res;
    }
}
