14chanwa/MiAM_robotics_ESP32/Code/eurobot2026/RobotCode/src/I2CHandler_vl53l0x.cpp

#include <I2CHandler.hpp>

#include <Wire.h>
#include <parameters.hpp>

#define RIGHT_VLX_ENABLE 33
#define MIDDLE_VLX_ENABLE 32
#define LEFT_VLX_ENABLE 5

#define LEFT_VLX_ADDRESS 0x31
#define MIDDLE_VLX_ADDRESS 0x30

namespace I2CHandler
{

    VL0XSensor right_sensor;
    VL0XSensor middle_sensor;
    VL0XSensor left_sensor;

#if PAMI_ID == 5
    VL1XSensor bottom_sensor;
#endif

    void init_vl53l0x()
    {
        pinMode(RIGHT_VLX_ENABLE, OUTPUT);
        pinMode(MIDDLE_VLX_ENABLE, OUTPUT);
        pinMode(LEFT_VLX_ENABLE, OUTPUT);

        // Reset all vlx : low, high, low
        digitalWrite(MIDDLE_VLX_ENABLE, LOW);
        digitalWrite(RIGHT_VLX_ENABLE, LOW);
        digitalWrite(LEFT_VLX_ENABLE, LOW);

        vTaskDelay(10 / portTICK_PERIOD_MS);

        digitalWrite(MIDDLE_VLX_ENABLE, HIGH);
        digitalWrite(RIGHT_VLX_ENABLE, HIGH);
        digitalWrite(LEFT_VLX_ENABLE, HIGH);

        vTaskDelay(10 / portTICK_PERIOD_MS);

        digitalWrite(MIDDLE_VLX_ENABLE, LOW);
        digitalWrite(RIGHT_VLX_ENABLE, LOW);
        digitalWrite(LEFT_VLX_ENABLE, LOW);

#if PAMI_ID == 5

        // // Init bottom vlx
        // vTaskDelay(50 / portTICK_PERIOD_MS);
        // digitalWrite(RIGHT_VLX_ENABLE, HIGH);
        // vTaskDelay(50 / portTICK_PERIOD_MS);
        // bottom_sensor.init(LEFT_VLX_ADDRESS);

        // Init middle vlx
        vTaskDelay(50 / portTICK_PERIOD_MS);
        digitalWrite(MIDDLE_VLX_ENABLE, HIGH);
        vTaskDelay(50 / portTICK_PERIOD_MS);
        middle_sensor.init(MIDDLE_VLX_ADDRESS);

#else

        // Init left vlx
        vTaskDelay(50 / portTICK_PERIOD_MS);
        digitalWrite(LEFT_VLX_ENABLE, HIGH);
        vTaskDelay(50 / portTICK_PERIOD_MS);
        left_sensor.init(LEFT_VLX_ADDRESS);

        // Init middle vlx
        vTaskDelay(50 / portTICK_PERIOD_MS);
        digitalWrite(MIDDLE_VLX_ENABLE, HIGH);
        vTaskDelay(50 / portTICK_PERIOD_MS);
        middle_sensor.init(MIDDLE_VLX_ADDRESS);

        // Init right vlx
        vTaskDelay(50 / portTICK_PERIOD_MS);
        digitalWrite(RIGHT_VLX_ENABLE, HIGH);
        vTaskDelay(50 / portTICK_PERIOD_MS);
        right_sensor.init(VL53L0X_I2C_ADDR);
#endif

    };

    uint16_t get_current_vl53l0x()
    {
        return std::min(std::min(right_sensor.get_current(), middle_sensor.get_current()), left_sensor.get_current());
    };

    uint16_t get_smoothed_vl53l0x()
    {
        return std::min(std::min(right_sensor.get_smoothed(), middle_sensor.get_smoothed()), left_sensor.get_smoothed());
    };


    uint16_t get_bottom_smoothed()
    {
// #if PAMI_ID == 5
//         return bottom_sensor.get_smoothed();
// #else
        return 1000;
//#endif
    }

    int16_t get_smoothed_vlx_side(Side side)
    {
        switch (side)
        {
            case RIGHT:
                if (right_sensor.is_init())
                {
                    return right_sensor.get_smoothed();
                }
                else
                {
                    return -1;
                }
                break;
            case MIDDLE:
                if (middle_sensor.is_init())
                {
                    return middle_sensor.get_smoothed();
                }
                else
                {
                    return -1;
                }
                break;
            case LEFT:
                if (left_sensor.is_init())
                {
                    return left_sensor.get_smoothed();
                }
                else
                {
                    return -1;
                }
                break;
            default:
                return -1;
        }
    }


    void update_vl53l0x()
    {
        right_sensor.update();
        middle_sensor.update();
        left_sensor.update();

// #if PAMI_ID == 5
//         bottom_sensor.update();
// #endif
    };

}

void VL0XSensor::init(uint8_t target_i2c_addr)
{
    if (I2CHandler::i2c_get())
    {
        if (lox_.begin(target_i2c_addr, true,
                        I2CHandler::get_wire(),
                        Adafruit_VL53L0X::VL53L0X_SENSE_DEFAULT))
        {
            // start continuous ranging
            lox_.startRangeContinuous(20);
            is_init_ = true;
        }
        else
        {
            Serial.println(F("Failed to boot VL53L0X"));
        }

        // Release i2c
        I2CHandler::i2c_give();
    }
}

void VL0XSensor::update()
{
    if (I2CHandler::i2c_get())
    {
        if (is_init_ && lox_.isRangeComplete())
        {
            current_ = lox_.readRange();
            smoothed_ = adc_.readADC_Avg(current_);
        }

        // Release i2c
        I2CHandler::i2c_give();
    }
}

void VL1XSensor::init(uint8_t target_i2c_addr)
{
    if (I2CHandler::i2c_get())
    {
        if (l1x_.begin(target_i2c_addr,
                        I2CHandler::get_wire(),
                        true))
        {
            // start continuous ranging
            l1x_.startRanging();
            is_init_ = true;
            Serial.println(F("VL53L1X sensor OK!"));
            
            Serial.print(F("Sensor ID: 0x"));
            Serial.println(l1x_.sensorID(), HEX);
            
            if (! l1x_.startRanging()) {
                Serial.print(F("Couldn't start ranging: "));
                Serial.println(l1x_.vl_status);
                while (1)       delay(10);
            }
            Serial.println(F("Ranging started"));
            
            // Valid timing budgets: 15, 20, 33, 50, 100, 200 and 500ms!
            l1x_.setTimingBudget(20);
            Serial.print(F("Timing budget (ms): "));
            Serial.println(l1x_.getTimingBudget());
        
        }
        else
        {
            Serial.println(F("Failed to boot VL53L1X"));
        }

        // Release i2c
        I2CHandler::i2c_give();
    }
}

void VL1XSensor::update()
{
    if (I2CHandler::i2c_get())
    {
        if (is_init_)
        {
            int16_t current_reading = l1x_.distance();
            //Serial.println(current_reading);
            if (current_reading > 100)
            {
                current_reading = 8000;
            }
            current_ = (uint16_t)current_reading;
            smoothed_ = adc_.readADC_Min(current_);
        }

        // Release i2c
        I2CHandler::i2c_give();
    }
}
