14chanwa/MiAM_robotics_ESP32/Code/eurobot2026/SupervisorBoardCode/src/TFTScreen.cpp

#include <TFTScreen.hpp>
#include <TFT_eSPI.h>
#include <SPI.h>
#include <vector>
#include <Types.h>
#include <Match.hpp>
#include <PAMIStates.hpp>

#include <PAMIDrawable.hpp>
#include <ButtonDrawable.hpp>


// #define DEBUG_TFT_SCREEN

#define PAMI_RECT_XSIZE 100
#define PAMI_RECT_YSIZE 60

#define MAX_PAMI_ID 6

TFT_eSPI tft = TFT_eSPI();       // Invoke custom library

std::vector<std::shared_ptr<PAMIDrawable > > pami_drawables;
std::shared_ptr<ButtonDrawable > button_change_color;
std::shared_ptr<ButtonDrawable > button_debug_mode;

void TFTScreen::init()
{
    // Create PAMIs
    pami_drawables.clear();
    for (uint i=1; i<=MAX_PAMI_ID; i++)
    {
        uint8_t gridX;
        uint8_t gridY;
        switch (i)
        {
            case 1:
                gridX = 0;
                gridY = 0;
                break;
            case 2:
                gridX = 1;
                gridY = 0;
                break;
            case 3:
                gridX = 2;
                gridY = 0;
                break;
            case 4:
                gridX = 0;
                gridY = 1;
                break;
            case 5:
                gridX = 1;
                gridY = 1;
                break;
            case 6:
                gridX = 2;
                gridY = 1;
                break;
        };

        Vector2 top_left_corner(5 + gridX * (PAMI_RECT_XSIZE + 5), 5 + gridY * (PAMI_RECT_YSIZE + 5));
        Vector2 dimensions(PAMI_RECT_XSIZE, PAMI_RECT_YSIZE);

        std::shared_ptr<PAMIDrawable > new_drawable(new PAMIDrawable(i, top_left_corner, dimensions));
        pami_drawables.push_back(new_drawable);
    }

    // Button change color
    {
        Vector2 top_left_corner(5 + 1 * (PAMI_RECT_XSIZE + 5), 25 + 2 * (PAMI_RECT_YSIZE + 5));
        Vector2 dimensions(PAMI_RECT_XSIZE, 40);
        button_change_color = std::make_shared<ButtonDrawable >(
            top_left_corner,
            dimensions
        );

    }
    {
        Vector2 top_left_corner(5 + 2 * (PAMI_RECT_XSIZE + 5), 25 + 2 * (PAMI_RECT_YSIZE + 5));
        Vector2 dimensions(PAMI_RECT_XSIZE, 40);
        button_debug_mode = std::make_shared<ButtonDrawable >(
            top_left_corner,
            dimensions
        );
    }
    

    tft.init(); 
    tft.setRotation(3); 
    tft.invertDisplay(false);

    tft.setTextWrap(true);
    tft.fillScreen(TFT_BLACK);
    tft.setTextColor(TFT_WHITE);
    tft.setTextSize(1);

    tft.setCursor(10, 230);
    tft.println("Sketch has been running for");
}

void TFTScreen::update(IPAddress localIP)
{

    for (uint8_t i=1; i<pami_drawables.size()+1; i++)
    {
        drawPAMI(PAMIStates::readPAMIMessage(i), i);
    }

    // Update match time
    tft.setTextSize(2);
    tft.setTextColor(TFT_WHITE, TFT_BLACK);
    tft.setCursor(15 + 0 * (PAMI_RECT_XSIZE + 5), 40 + 2 * (PAMI_RECT_YSIZE + 5));
    if (Match::getMatchStarted())
    {
        tft.print("      ");
        tft.setCursor(15 + 0 * (PAMI_RECT_XSIZE + 5), 40 + 2 * (PAMI_RECT_YSIZE + 5));
        tft.print(Match::getMatchTimeSeconds());
    }
    else
    {
        tft.print("Wait..");
    }

    // Update current side
    if (Match::getSide() == PlayingSide::BLUE_SIDE)
    {
        button_change_color->update(
            "BLUE",
            TFT_BLACK,
            TFT_BLACK,
            2,
            TFT_BLUE
        );
    }
    else
    {
        button_change_color->update(
            "YELLOW",
            TFT_BLACK,
            TFT_BLACK,
            2,
            TFT_YELLOW
        );
    }

    button_change_color->draw(tft);

    // Update current side
    if (Match::getDebugMode())
    {
        button_debug_mode->update(
            "DEBUG",
            TFT_BLACK,
            TFT_BLACK,
            2,
            TFT_RED
        );
    }
    else
    {
        button_debug_mode->update(
            "Match",
            TFT_BLACK,
            TFT_BLACK,
            2,
            TFT_LIGHTGREY
        );
    }

    button_debug_mode->draw(tft);

    // tft.setCursor(230, 150);
    // if (Match::getSide() == PlayingSide::BLUE_SIDE)
    // {
    //     tft.setTextSize(2);
    //     tft.setTextColor(TFT_BLUE, TFT_BLACK);
    //     tft.print("BLUE  ");
    // }
    // else
    // {
    //     tft.setTextSize(2);
    //     tft.setTextColor(TFT_YELLOW, TFT_BLACK);
    //     tft.print("YELLOW");
    // }

    // Update seconds count
    tft.setTextSize(1);
    tft.setCursor(180, 230);
    tft.setTextColor(TFT_MAGENTA, TFT_BLACK);
    tft.print(millis() / 1000);
    tft.setTextColor(TFT_WHITE, TFT_BLACK);
    tft.print(" seconds.");

    // Update local IP
    if (localIP != lastIP)
    {
        tft.setCursor(10, 220);
        tft.print("               ");
        tft.setCursor(10, 220);
        tft.print(localIP);
        lastIP = localIP;
    }

#ifdef DEBUG_TFT_SCREEN
    tft.setCursor(10, 210);
    tft.print("Last received message at time: ");
    tft.print(PAMIStates::readLastMessageTime());
#endif

    // // PAMI motor lock
    // tft.setTextSize(1);
    // tft.setCursor(230, 180);
    // if (Match::getStopMotors())
    // {
    //     tft.print("Motors LOCKED");
    // }
    // else
    // {
    //     tft.print("             ");
    // }

}

#define TOUCH_MAX_X 319.0f
#define TOUCH_MAX_Y 8.0f
#define TOUCH_MIN_X 8.0f
#define TOUCH_MIN_Y 238.0f

Vector2 touch_to_screen(uint16_t x, uint16_t y)
{
    Vector2 v;
    v[0] = (x - TOUCH_MIN_X) / (TOUCH_MAX_X - TOUCH_MIN_X);
    v[1] = (y - TOUCH_MIN_Y) / (TOUCH_MAX_Y - TOUCH_MIN_Y);
    v[0] = std::max(std::min(v[0], 1.0f), 0.0f);
    v[1] = std::max(std::min(v[1], 1.0f), 0.0f);
    v[0] = v[0] * TFT_HEIGHT;
    v[1] = v[1] * TFT_WIDTH;
    return v;
}

void TFTScreen::registerTouch()
{
    uint16_t x, y;
    if (tft.getTouch(&x, &y)) {
        // Serial.print("Pressure = ");
        // Serial.print(p.z);
        // Serial.print("x = ");
        // Serial.print(x);
        // Serial.print(", y = ");
        // Serial.print(y);
        // Serial.print(", ");
        Vector2 v = touch_to_screen(x, y);
        // Serial.print(v[0]);
        // Serial.print(", ");
        // Serial.println(v[1]);
        // Serial.println();
        for (auto p : pami_drawables)
        {
            if (p->clicked(v))
            {
                Serial.print("PAMI Clicked: ");
                Serial.print(p->pami_id_);
                Serial.println();
            }
        }
        if (button_change_color->clicked(v))
        {
            Serial.println("Button clicked");
            if (Match::getSide() == PlayingSide::YELLOW_SIDE)
            {
                Match::setSide(PlayingSide::BLUE_SIDE);
            }
            else
            {
                Match::setSide(PlayingSide::YELLOW_SIDE);
            }
        }

        if (button_debug_mode->clicked(v))
        {
            Serial.println("Button DEBUG clicked");
            if (Match::getDebugMode())
            {
                Match::setDebugMode(false);
            }
            else
            {
                Match::setDebugMode(true);
            }
        }
        delay(30);
    }
}


void TFTScreen::drawPAMI(FullPamiReportMessage pamiReport, uint8_t pamiID)
{
   pami_drawables.at(pamiID-1)->update(pamiReport);
   pami_drawables.at(pamiID-1)->draw(tft);
}
