14chanwa/MiAM_robotics_ESP32/Code/eurobot2026/SquirelCode/src/I2CHandler_ssd1306.cpp

// #include <SPI.h>
// #include <Wire.h>
// #include <Adafruit_GFX.h>
// #include <Adafruit_SSD1306.h>

// #include <I2CHandler.hpp>

// #define SCREEN_WIDTH 128 // OLED display width, in pixels
// #define SCREEN_HEIGHT 64 // OLED display height, in pixels

// // Declaration for an SSD1306 display connected to I2C (SDA, SCL pins)
// #define OLED_RESET -1 // Reset pin # (or -1 if sharing Arduino reset pin)

// #define OLED_ADDRESS 0x3C

// Adafruit_SSD1306 *display;

// namespace I2CHandler
// {
//     void initOLEDScreen()
//     {
//         if (I2CHandler::i2c_get())
//         {
//             display = new Adafruit_SSD1306(SCREEN_WIDTH, SCREEN_HEIGHT, I2CHandler::get_wire(), OLED_RESET);

//             if (!display->begin(SSD1306_SWITCHCAPVCC, OLED_ADDRESS, true, false))
//             {
//                 Serial.println(F("SSD1306 allocation failed"));
//             }
//             else
//             {
//                 Serial.println("Begin OK");
//             }

//             display->setRotation(2);

//             // Show initial display buffer contents on the screen --
//             // the library initializes this with an Adafruit splash screen.
//             display->clearDisplay();
//             display->display();

//             // Release i2c
//             I2CHandler::i2c_give();
//         }
//     };

//     void printOLEDMessage(String message, int16_t cursor_offset_x, int16_t cursor_offset_y, uint8_t size)
//     {
//         display->setTextSize(size);                           // Normal 1:1 pixel scale
//         display->setTextColor(WHITE, BLACK);                  // Draw white text
//         display->setCursor(cursor_offset_x, cursor_offset_y); // Start at top-left corner
//         display->println(message);
//         display->display();
//     };

//     bool flipMessage = false;

//     DisplayInformations current_displayed_informations;

//     void update_ssd1306(DisplayInformations *display_informations)
//     {
//         if (I2CHandler::i2c_get())
//         {
//             // display->clearDisplay();
//             flipMessage = !flipMessage;

//             // ip
//             if (current_displayed_informations.ip_address != display_informations->ip_address)
//             {
//                 // clear
//                 printOLEDMessage("               ", 0, 20, 2);
//                 printOLEDMessage(display_informations->ip_address, 0, 0, 1);
//             }

//             // heartbeat
//             if (flipMessage)
//             {
//                 printOLEDMessage("/", 0, 10, 1);
//             }
//             else
//             {
//                 printOLEDMessage("\\", 0, 10, 1);
//             }

//             // id
//             if (current_displayed_informations.id != display_informations->id)
//             {
//                 // clear
//                 printOLEDMessage("   ", 0, 20, 2);
//                 printOLEDMessage(std::to_string(display_informations->id).c_str(), 0, 20, 2);
//             }

//             // time
//             if (current_displayed_informations.match_started != display_informations->match_started ||
//                 current_displayed_informations.current_time_s != display_informations->match_started)
//             {
//                 // clear
//                 printOLEDMessage("     ", 60, 20, 2);
//                 if (display_informations->match_started)
//                 {
//                     std::string tmp;
//                     tmp += "t=" + std::to_string(display_informations->current_time_s);
//                     printOLEDMessage(tmp.c_str(), 60, 20, 2);
//                 }
//             }

//             current_displayed_informations = *display_informations;

//             // Release i2c
//             I2CHandler::i2c_give();
//         }
//     };

// }
