14chanwa/MiAM_robotics_ESP32/src/task_monitor_battery.cpp

#include <Arduino.h>
#include <parameters.hpp>
#include <tasks.hpp>

// Moving average for battery reading
#define FILTER_LEN  15

uint32_t AN_Pot1_Buffer[FILTER_LEN] = {0};
int AN_Pot1_i = 0;
int AN_Pot1_Raw = 0;
uint32_t readADC_Avg(int ADC_Raw);
bool MA_inited = false;

// float batReading_unfiltered = 0;
float batReading = 0;
float minBatReading = 100;


void run_monitor_battery()
{
    analogReadResolution(12);
    analogSetAttenuation(ADC_6db);

    xTaskCreate(
        task_monitor_battery, 
        "task_monitor_battery",
        1000,
        NULL,
        1,
        NULL
    ); 
}

void task_monitor_battery(void* parameters)
{
  for(;;)
  {
    AN_Pot1_Raw = analogReadMilliVolts(BAT_READING);
    // batReading_unfiltered = AN_Pot1_Raw * (R1 + R2) / R2 / 1000.0;
    batReading = readADC_Avg(AN_Pot1_Raw) * (R1 + R2) / R2 / 1000.0;
    minBatReading = std::min(minBatReading, batReading);
    vTaskDelay(10.0 / portTICK_PERIOD_MS);
  }    
}

float get_current_battery_reading()
{
    return batReading;
}

float get_min_battery_reading()
{
    return minBatReading;
}


/////////////////////////////////////////////
// Functions
/////////////////////////////////////////////

uint32_t readADC_Avg(int ADC_Raw)
{

  if (!MA_inited)
  {
    for (int i = 0; i < FILTER_LEN; i++)
      AN_Pot1_Buffer[i] = ADC_Raw;
    
    MA_inited = true;
  }

  int i = 0;
  uint32_t Sum = 0;
  
  AN_Pot1_Buffer[AN_Pot1_i++] = ADC_Raw;
  if(AN_Pot1_i == FILTER_LEN)
  {
    AN_Pot1_i = 0;
  }
  for(i=0; i<FILTER_LEN; i++)
  {
    Sum += AN_Pot1_Buffer[i];
  }
  return (Sum/FILTER_LEN);
}
