14chanwa/MiAM_robotics_ESP32/Code/CommonLibraries/miam_utils_arduino/Utilities.cpp

/// \author MiAM Robotique, Matthieu Vigne
/// \copyright GNU GPLv3
#include "Utilities.h"
#include "StraightLine.h"
#include "PointTurn.h"
#include "ArcCircle.h"

#include <cmath>
#include <limits>

namespace miam{
    namespace trajectory{

        TrajectoryVector TrajectoryVector::operator+(const TrajectoryVector b) const
        {
            TrajectoryVector v = *this;
            v.insert(v.end(), b.begin(), b.end());
            return v;
        }

        float TrajectoryVector::getDuration() const
        {
            float duration = 0;
            for (auto traj : *this)
            {
                duration += traj->getDuration();
            }
            return duration;
        }

        TrajectoryPoint TrajectoryVector::getCurrentPoint(float const& currentTime) const
        {

            if (this->empty())
                return TrajectoryPoint();

            float sum_time = 0;
            for (long unsigned int i = 0; i < this->size(); i++) {
                float traj_time = this->at(i)->getDuration();
                if (sum_time + traj_time > currentTime) {
                    return this->at(i)->getCurrentPoint(currentTime - sum_time);
                }
                sum_time += traj_time;
            }
            return this->back()->getEndPoint();
        };


        TrajectoryPoint TrajectoryVector::getEndPoint() const
        {
            if (this->empty())
                return TrajectoryPoint();
            return this->back()->getEndPoint();
        }


        RobotPosition computeCircleCenter(RobotPosition const& startingPosition, float const& radius, rotationside const& side)
        {
            RobotPosition circleCenter;
            float centerAngle = startingPosition.theta + M_PI / 2.0;
            if(side == rotationside::RIGHT)
                centerAngle += M_PI;
            circleCenter.x = startingPosition.x + std::abs(radius) * std::cos(centerAngle);
            circleCenter.y = startingPosition.y + std::abs(radius) * std::sin(centerAngle);
            // Absolue angle of segment [center, startPoint]
            circleCenter.theta = centerAngle - M_PI;
            return circleCenter;
        }


        float computeShortestAngle(RobotPosition startPoint, RobotPosition endPoint)
        {
            // Compute line angle.
            if (std::abs(endPoint.y - startPoint.y) < std::numeric_limits<float>::epsilon() && std::numeric_limits<float>::epsilon() < 0)
            {
                return 0;
            }

            float angle = std::atan2(endPoint.y - startPoint.y, endPoint.x - startPoint.x);
            // Return value in ]-pi, pi] of the original angle.
            return moduloTwoPi(angle - startPoint.theta);
        }


        float distance(RobotPosition const& first, RobotPosition const& second)
        {
            return (first - second).norm();
        }

        float moduloTwoPi(float angle)
        {
            angle = std::fmod(angle, 2 * M_PI);
            if (angle <= -M_PI)
                angle += 2 * M_PI;
            if (angle > M_PI)
                angle -= 2 * M_PI;
            return angle;
        }

        TrajectoryVector computeTrajectoryStraightLineToPoint(TrajectoryConfig const& config,
                                                              RobotPosition const& startPosition,
                                                              RobotPosition const& endPosition,
                                                              float const& endVelocity,
                                                              bool const& backward)
        {
            TrajectoryVector vector;
            std::shared_ptr<StraightLine> line(new StraightLine(config, startPosition, endPosition, 0.0, endVelocity, backward));

            // Get angle from straight line as rotation target.
            vector.push_back(std::shared_ptr<Trajectory>(new PointTurn(config, startPosition, line->getAngle())));
            vector.push_back(std::shared_ptr<Trajectory>(line));
            return vector;
        }

        TrajectoryVector computeTrajectoryRoundedCorner(TrajectoryConfig const& config,
                                                        std::vector<RobotPosition> const& positions,
                                                        float radius,
                                                        float transitionVelocityFactor,
                                                        bool backward,
                                                        float endVelocity)
        {
            TrajectoryVector trajectories;
            if(positions.size() < 2)
                return trajectories;
            // Compute the transition angular velocity.
            float factor = transitionVelocityFactor;
            if(factor < 0.0)
                factor = 0.0;
            else if(factor > 1.0)
                factor = 1.0;

            float transitionLinearVelocity = factor * config.maxWheelVelocity;
            float transitionAngularVelocity = transitionLinearVelocity / (std::abs(radius) + config.robotWheelSpacing);

            // Compute first rotation to be aligned with second point.
            TrajectoryVector straightLine = computeTrajectoryStraightLineToPoint(config, positions.at(0),
                positions.at(1),
                transitionLinearVelocity,
                backward);
            trajectories.push_back(straightLine[0]);

            // For each remaining pair of points, computed the line and rounded corner to go there.
            for(uint i = 1; i < positions.size() - 1; i++)
            {
                RobotPosition startPoint = trajectories.back()->getEndPoint().position;
                RobotPosition roundedCornerPoint = positions.at(i);
                RobotPosition endPoint = positions.at(i + 1);

                // Find position of the center of the circle.
                // Get vectors going from the corner to both points.
                RobotPosition firstVector = startPoint - roundedCornerPoint;
                float firstNorm = firstVector.norm();
                firstVector.normalize();
                RobotPosition secondVector = endPoint - roundedCornerPoint;
                float secondNorm = secondVector.norm();
                secondVector.normalize();

                // Find angle between both vectors.
                float angle = std::acos(firstVector.dot(secondVector));

                // Get distance from roundedCornerPoint to center along each vector, reducing the radius if it is too large.
                float coefficient = 1 / std::tan(angle / 2.0);

                float circleRadius = std::min(radius, std::min(firstNorm, secondNorm) / coefficient * 0.99f);

                // Compute point where the circle intersects both trajectories: get the first point and the
                // angle.
                RobotPosition circleIntersection = roundedCornerPoint + circleRadius * coefficient * firstVector;
                // Put back right angle.
                circleIntersection.theta = startPoint.theta;

                // Compute direction of the circle, based on cross-product.
                rotationside side = rotationside::LEFT;
                if(firstVector.cross(secondVector) > 0.0)
                    side = rotationside::RIGHT;
                if (backward)
                {
                    if (side == rotationside::RIGHT)
                        side = rotationside::LEFT;
                    else
                        side = rotationside::RIGHT;
                }

                // Compute end angle: minus the angle of secondVector.
                float endAngle = std::atan2(secondVector.y, secondVector.x);
                if(side == rotationside::LEFT)
                    endAngle -= M_PI_2;
                else
                    endAngle += M_PI_2;

                if (backward)
                    endAngle += M_PI;

                // Compute trajectory.
                std::shared_ptr<StraightLine> line(new StraightLine(config, startPoint, circleIntersection, (i == 1 ? 0.0 : transitionLinearVelocity), transitionLinearVelocity, backward));
                trajectories.push_back(line);
                std::shared_ptr<ArcCircle> circle(new ArcCircle(config, circleIntersection, circleRadius, side, endAngle, transitionAngularVelocity, transitionAngularVelocity, backward));
                trajectories.push_back(circle);
            }
            // Append final straight line.
            RobotPosition currentPoint = trajectories.back()->getEndPoint().position;
            RobotPosition endPoint = positions.back();
            std::shared_ptr<StraightLine> line(new StraightLine(config, currentPoint, endPoint, (positions.size() == 2 ? 0 : transitionLinearVelocity), endVelocity, backward));
            trajectories.push_back(line);

            return trajectories;
        }

        TrajectoryVector computeTrajectoryStraightLine(TrajectoryConfig const& config, RobotPosition & position, float const& distance)
        {
            RobotPosition endPosition = position + RobotPosition(distance, 0.0, 0.0).rotate(position.theta);
            endPosition.theta = position.theta;

            TrajectoryVector vector;
            std::shared_ptr<StraightLine> line(new StraightLine(config, position, endPosition, 0.0, 0.0, (distance < 0)));

            vector.push_back(std::shared_ptr<Trajectory>(line));
            position = endPosition;
            return vector;
        }
    }
}
