14chanwa/MiAM_robotics_ESP32/Code/CommonLibraries/miam_utils_arduino/Utilities.h

/// \file trajectory/Utilities.h
/// \brief Utility functions for trajectory generation.
/// \author MiAM Robotique, Matthieu Vigne
/// \copyright GNU GPLv3
#ifndef MIAM_TRAJECTORY_UTILITIES
#define MIAM_TRAJECTORY_UTILITIES

    #include "Trajectory.h"
    #include "ArcCircle.h"
    #include <vector>
    #include <memory>

    namespace miam{
        namespace trajectory{

            /// \brief Simple class for working with vectors of trajectories>
            class TrajectoryVector: public std::vector<std::shared_ptr<Trajectory>>
            {
                public:
                    /// \brief Concatenate two trajectory vectors.
                    /// \param[in] b Vector to concatenate.
                    /// \return The concatenated vector.
                    TrajectoryVector operator+(const TrajectoryVector b) const;

                    /// \brief Get trajectory duration, in seconds.
                    /// \return Trajectory duration.
                    float getDuration() const;

                    /// \brief Get trajectory point at current time.
                    ///
                    /// \param[in] currentTime Time relative to trajectory start, in seconds.
                    /// \return The current trajectory point.
                    TrajectoryPoint getCurrentPoint(float const& currentTime) const;

                    /// \brief Get the last point of the last trajectory.
                    /// \return The last point of the last trajectory.
                    TrajectoryPoint getEndPoint() const;
            };
            //~ typedef std::vector<std::shared_ptr<miam::trajectory::Trajectory>> TrajectoryVector; ///< Vector of trajectories for trajectory following.

            /// \brief Concatenate two trajectory vectors.
            /// \param[in, out] a First vector, to which the second vector is appended.
            /// \param[in] b Second vector.
            //~ void concatenate(TrajectoryVector & a, TrajectoryVector const& b);

            /// \brief Compute coordinates of the center of a circle of a given radius tangent to the given position.
            ///
            /// \param[in] startingPosition Starting position.
            /// \param[in] radius Circle radius.
            /// \param[in] side Rotation side.
            /// \return Center position, with angle set to match startingPosition angle when computing the coordinates
            ///         of a point along the circle.
            RobotPosition computeCircleCenter(RobotPosition const& startingPosition,
                                              float const& radius,
                                              rotationside const& side);


            /// \brief Compute shortest angle between two points.
            /// \details Given two (x,y) coordinates, compute the line angle between them. Return the angle,
            ///          modulo two pi, closest to the startPoint angle.
            ///
            /// \param[in] startPoint Starting point.
            /// \param[in] startPoint End point.
            /// \return An angle value.
            float computeShortestAngle(RobotPosition startPoint, RobotPosition endPoint);

            /// \brief Return the distance between two point.
            ///
            /// \param[in] first First point.
            /// \param[in] second Second point.
            /// \return Euclidean distance between these two points.
            float distance(RobotPosition const& first, RobotPosition const& second);

            /// \brief Return equivalent angle, modulo two pi.
            /// \return angle in ]-pi, pi]
            float moduloTwoPi(float angle);

            /// \brief Compute a rotation followed by a straight line to go from the start to end position.
            ///
            /// \details This functions returns a length 2 vector of pointers: the first is the rotation required to
            ///          go to the specified point in a straight line, while the second one is the line to that point.
            ///
            /// \param[in] startPosition Starting position
            /// \param[in] endPosition Final position - angle is not taken into account.
            /// \param[in] endVelocity Final velocity.
            /// \param[in] backward If translation should be done backward.
            /// \return Vector of pointer toward two trajectories: rotation then translation.
            TrajectoryVector computeTrajectoryStraightLineToPoint(TrajectoryConfig const& config,
                                                                  RobotPosition const& startPosition,
                                                                  RobotPosition const& endPosition,
                                                                  float const& endVelocity = 0.0,
                                                                  bool const& backward = false);

            /// \brief Given a list of points, compute a polyline going from the first point to the last, with rounded
            ///        corners.
            ///
            /// \details Given three points in the trajectory (a_{i-1}, a_i, a_{i+1}), the trajectory is a straight
            ///          line to a_i, then a circle starting at a_i torward a_{i+1}, then a line to a_{i+}
            ///
            /// \param[in] positions Vector of positions through which to go. Angles are not taken into account except
            ///                      for the first position.
            /// \param[in] radius Circle radius - the same is used at each point.
            /// \param[in] transitionVelocityFactor Percentage of the maximum velocity along the circle at which to do the transition.
            /// \return Vector of pointer toward the full trajectory.
            TrajectoryVector computeTrajectoryRoundedCorner(TrajectoryConfig const& config,
                                                            std::vector<RobotPosition> const& positions,
                                                            float radius,
                                                            float transitionVelocityFactor = 0.5,
                                                            bool backward = false,
                                                            float endVelocity = 0.0);

            /// \brief Compute a simple trajectory: going forward for a given distance.
            ///
            /// \details The output trajectory consists of only one straight line, no rotation is added.
            ///
            /// \param[in, out] position The starting position ; this is updated to the end position of the trajectory.
            /// \param[in] distance Travel distance ; can be negative, in which case the robot will go backward.
            /// \return The trajectory.
            TrajectoryVector computeTrajectoryStraightLine(TrajectoryConfig const& config,
                                                           RobotPosition & position,
                                                           float const& distance);
        }
    }
#endif
