14chanwa/MiAM_robotics_ESP32/Code/CommonLibraries/miam_utils_arduino/ArcCircle.cpp

/// \author MiAM Robotique, Matthieu Vigne
/// \copyright GNU GPLv3
#include "ArcCircle.h"
#include "Utilities.h"

#include <cmath>

namespace miam{
    namespace trajectory{
        ArcCircle::ArcCircle(TrajectoryConfig const& config,
                             RobotPosition const& startPoint,
                             float const& radius,
                             rotationside const& side,
                             float const& endAngle,
                             float const& startVelocity,
                             float const& endVelocity,
                             bool const& backward):
            Trajectory(config),
            movingBackward_(1.0),
            radius_(std::abs(radius)),
            side_(side),
            endAngle_(endAngle),
            endVelocity_(endVelocity)
        {
            description_ = "ArcCircle";
            if (backward)
                movingBackward_ = -1.0;
            make(startPoint, startVelocity);
        }

        TrajectoryPoint ArcCircle::getCurrentPoint(float const& currentTime)
        {
            TrajectoryPoint output;
            output.position = circleCenter_;
            TrapezoidState state = trapezoid_.getState(currentTime);

            // Compute point along circle.
            output.position.x += radius_ * std::cos(circleCenter_.theta + motionSign_ * state.position);
            output.position.y += radius_ * std::sin(circleCenter_.theta + motionSign_ * state.position);
            output.position.theta = circleCenter_.theta + motionSign_ * M_PI_2 + motionSign_ * state.position;
            if(movingBackward_ == -1.0)
                output.position.theta -= M_PI  *motionSign_;
            // Compute linear and angular velocity
            output.linearVelocity = movingBackward_ * state.velocity * radius_;
            output.angularVelocity = motionSign_ * state.velocity;

            return output;
        }

        void ArcCircle::make(RobotPosition const& startPoint, float const& startVelocity)
        {
             motionSign_ = 1.0;

            // Compute position of circle center.
            // Get angle of robot wheel axis, swich sign based on direction.
            circleCenter_ = computeCircleCenter(startPoint, radius_, side_);

            // Compute angle of travel along the circle.
            float travelAngle = moduloTwoPi(endAngle_ - circleCenter_.theta);
            // Give it the correct sign, based on desired direction and rotation side.
            if(side_ == rotationside::RIGHT)
                motionSign_ = -1.0;
            motionSign_ = motionSign_ * movingBackward_;

            // Compute angle with right sign, modulo 2 Pi
            if(motionSign_ < 0)
            {
                if(travelAngle > 0)
                    travelAngle -=2 * M_PI;
            }
            else
            {
                if(travelAngle < 0)
                    travelAngle +=2 * M_PI;
            }

            // Compute trapezoid.
            float maxAngularVelocity = config_.maxWheelVelocity / (radius_ + config_.robotWheelSpacing);
            float maxAngularAcceleration = config_.maxWheelAcceleration / (radius_ + config_.robotWheelSpacing);
            trapezoid_ = Trapezoid(travelAngle, startVelocity, endVelocity_, maxAngularVelocity, maxAngularAcceleration);

            duration_ = trapezoid_.getDuration();
        }


        void ArcCircle::replanify(float const& replanificationTime, float const& maxStartVelocity)
        {
            RobotPosition startPoint = getCurrentPoint(replanificationTime).position;
            float startVelocity = std::min(maxStartVelocity, getCurrentPoint(replanificationTime).linearVelocity);
            make(startPoint, startVelocity);
        }
    }
}
