14chanwa/MiAM_robotics_ESP32/Code/CommonLibraries/miam_utils_arduino/ArcCircle.h

/// \file trajectory/ArcCircle.h
/// \brief A circular arc trajectory.
/// \author MiAM Robotique, Matthieu Vigne
/// \copyright GNU GPLv3
#ifndef MIAM_TRAJECTORY_ARC_CIRCLE
#define MIAM_TRAJECTORY_ARC_CIRCLE

    #include "Trajectory.h"
    #include "Trapezoid.h"

    namespace miam{
        namespace trajectory{
            enum class rotationside{
                RIGHT,
                LEFT
            };

            class ArcCircle: public Trajectory
            {
                public:
                    /// \brief Constructor.
                    /// \details Specify the trajectory, giving robot starting position, circle radius, rotation
                    ///          side (used to define if the circle is on the right or on the left of the robot),
                    ///          and final angle along the arc. The final angle is the angle between -pi and
                    ///          pi of the end point along the circle, and not the robot angle.
                    ///
                    /// \param[in] config Trajectory configuration (wheel spacing, max speed and acceleration)
                    /// \param[in] startPoint Strating point.
                    /// \param[in] radius Circle radius.
                    /// \param[in] side  On which side the trajectory is generated.
                    /// \param[in] endAngle Position of endpoint along the circle.
                    /// \param[in] startVelocity Start velocity.
                    /// \param[in] endVelocity Desired end velocity.
                    /// \param[in] backward If robot should move backward along the trajectory.
                    ArcCircle(TrajectoryConfig const& config,
                              RobotPosition const& startPoint,
                              float const& radius,
                              rotationside const& side,
                              float const& endAngle,
                              float const& startVelocity=0.0,
                              float const& endVelocity=0.0,
                              bool const& backward = false);

                    TrajectoryPoint getCurrentPoint(float const& currentTime);

                    void replanify(float const& replanificationTime, float const& maxStartVelocity = 0.0);

                private:
                    void make(RobotPosition const& startPoint, float const& startVelocity); ///< Build (or rebuild) the trajectory.

                    int movingBackward_; ///< 1 or -1, to indicate if robot is moving forward or backward.
                    int motionSign_; ///< 1 or -1, to indicate if rotation is direct or indirect.
                    float radius_; ///< Circle radius.
                    RobotPosition circleCenter_; ///< Center of the circle.
                    Trapezoid trapezoid_; ///< Velocity trapezoid.

                    rotationside side_; ///< Rotation direction.
                    float endAngle_; ///< End angle.
                    float endVelocity_; ///< End velocity.
            };
        }
    }
#endif
