14chanwa/MiAM_robotics_ESP32/Code/CommonLibraries/miam_utils_arduino/Types.h

/// \file Types.h
/// \brief Typedefs
///
/// \author MiAM Robotique, Matthieu Vigne
/// \copyright GNU GPLv3
#ifndef MIAM_TYPES
#define MIAM_TYPES
    
    #include <ArduinoEigenDense.h>

    typedef Eigen::Vector2f Vector2;
    typedef Eigen::Vector3f Vector3;
#endif
