14chanwa/MiAM_robotics_ESP32/Code/CommonLibraries/miam_utils_arduino/Trajectory.cpp

/// \author MiAM Robotique, Matthieu Vigne
/// \copyright GNU GPLv3
#include "Trajectory.h"

#include <cmath>

namespace miam{
    namespace trajectory{

        TrajectoryPoint::TrajectoryPoint():
            position(),
            linearVelocity(0.0),
            angularVelocity(0.0)
            {}

        Trajectory::Trajectory(TrajectoryConfig const& config):
            duration_(0.0),
            config_(config),
            avoidanceEnabled_(true),
            isAvoidanceTrajectory_(false),
            needReplanning_(false)
        {
        }

        float Trajectory::getDuration()
        {
            return duration_;
        }

        TrajectoryPoint Trajectory::getEndPoint()
        {
            return getCurrentPoint(getDuration());
        }
    }
}
