14chanwa/MiAM_robotics_ESP32/(commit log)

2023-07-31 Start implementing PID
2023-07-31 Write a specific Motor class
2023-08-01 Change control unit to PWM
2023-08-05 Add first version of pcb
    [MiAM_ESP32.kicad_pcb, MiAM_ESP32.kicad_sch]
2023-08-06 Add miam utils and kinematics
2023-08-08 Do straight lines & fix params
    [main.cpp, parameters.hpp]
2023-08-08 Change calibration trajectory
2023-08-09 Add LED heartbeat
2023-09-02 Update driver and add ota update
2023-10-16 Add first PAMI CAD
    [PAMI DC Base V2.stl]
2023-10-18 Make more condensed version of pcb
    [MiAM_ESP32.kicad_pcb, MiAM_ESP32.kicad_sch]
2023-10-23 Make genric robot wheel structure
2023-10-28 Add modular structure for stepper & dc pami
2023-10-28 Fix initial PAMI pcb
    [MiAM_ESP32.kicad_pcb, MiAM_ESP32.kicad_sch]
2023-10-28 Add 3 PCB for DC & Stepper PAMI
    [MiAM_PAMI_DCShield.kicad_pcb, MiAM_PAMI_DCShield.kicad_sch, MiAM_PAMI_PowerShield.kicad_pcb, MiAM_PAMI_PowerShield.kicad_sch, MiAM_PAMI_StepperShield.kicad_pcb, MiAM_PAMI_StepperShield.kicad_sch]
2023-10-28 Fix MT3608 footprint
    [MiAM_PAMI_PowerShield.kicad_pcb]
2023-10-28 Fix shield footprint
    [MiAM_PAMI_DCShield.kicad_pcb, MiAM_PAMI_PowerShield.kicad_pcb, MiAM_PAMI_StepperShield.kicad_pcb]
2023-11-01 Faster DC
    [MiAM_PAMI_DCShield.kicad_pcb, MiAM_PAMI_DCShield.kicad_sch, MiAM_PAMI_PowerShield.kicad_pcb]
2023-11-03 Add V2 of PAMI stepper
    [MiAM_PAMI_V2_StepperMainBoard.kicad_pcb, MiAM_PAMI_V2_StepperMainBoard.kicad_sch]
2023-11-03 Fix pcb & add driver board
    [MiAM_PAMI_V2_StepperDriverBoard.kicad_pcb, MiAM_PAMI_V2_StepperDriverBoard.kicad_sch, MiAM_PAMI_V2_StepperMainBoard.kicad_pcb, MiAM_PAMI_V2_StepperMainBoard.kicad_sch]
2023-11-06 Put stepper driver on main board
    [MiAM_PAMI_V2_StepperMainBoard.kicad_pcb, MiAM_PAMI_V2_StepperMainBoard.kicad_sch]
2023-11-06 Begin optimizing stepper code
2023-11-06 Fix new stepper code
    [main.cpp, parameters.hpp]
2023-11-06 Switch to ArduinoOTA and cleanup
2023-11-24 Switch to esp-idf+arduino & fix lag issues
    [partitions.csv]
2023-11-26 Initial commit PAMI V3
    [MiAM_PAMI_V2_StepperMainBoard.kicad_pcb, MiAM_PAMI_V2_StepperMainBoard.kicad_sch]
2023-11-26 Init pami v3
    [MiAM_PAMI_V3_Stepper.kicad_pcb, MiAM_PAMI_V3_Stepper.kicad_sch]
2023-11-26 Fix PCB for v3
    [MiAM_PAMI_V3_Stepper.kicad_pcb, MiAM_PAMI_V3_Stepper.kicad_sch]
2023-11-26 Fix pcb v3
    [MiAM_PAMI_V3_Stepper.kicad_pcb, MiAM_PAMI_V3_Stepper.kicad_sch]
2023-11-26 Fixes, adds vlx & tcrt
    [partitions.csv]
2023-11-29 PCB order 2023-11-29
    [MiAM_PAMI_V3_Stepper.kicad_pcb, MiAM_PAMI_V3_Stepper.kicad_sch, MiAM_TCRT5000L.kicad_pcb, MiAM_TCRT5000L.kicad_sch]
2024-01-21 Functional stepper code for a square
2024-02-06 Add DC PAMI board
    [MiAM_PAMI_V3_DC.kicad_pcb, MiAM_PAMI_V3_DC.kicad_sch]
2024-02-17 Fix message length bug
    [MessageReceiver.cpp, MessageReceiver.hpp, main.cpp]
2024-02-18 Fix PCB
    [MiAM_PAMI_V3_DC.kicad_pcb, MiAM_PAMI_V3_DC.kicad_sch]
2024-02-18 Fix DC PAMI schematic
    [MiAM_PAMI_V3_DC.kicad_pcb, MiAM_PAMI_V3_DC.kicad_sch]
2024-03-09 Working DC PAMI (need invert one motor)
    [MotionController.cpp, MotionController.hpp, main.cpp, parameters.hpp]
2024-03-09 Fix invert motor
2024-03-13 Add servo example code
2024-03-13 Clean servo code
2024-03-16 Rework i2c tasks
2024-03-17 Make PAMI listen to UDP broadcasts
    [partitions.csv, positions_pami.ods]
2024-03-17 Update positions
    [positions_pami.ods]
2024-03-22 Add SupervisorBoard tft screen & routing
    [MiAM_SupervisorBoard.kicad_pcb, MiAM_SupervisorBoard.kicad_sch]
2024-03-25 Complete supervisor PCB
    [MiAM_SupervisorBoard.kicad_pcb, MiAM_SupervisorBoard.kicad_sch]
2024-03-25 Add front switches code
    [MiAM_SupervisorBoard.kicad_pcb]
2024-03-30 Fix TCP issue (not closing connections)
    [MessageHandler.cpp, MessageReceiver.cpp]
2024-04-05 Block steppers in match ended state, handle switches, send reports to scd
2024-04-06 Fix message sending & receiving for PAMI
    [MessageHandler.cpp, MessageReceiver.cpp, MessageReceiver.hpp, TFTScreen.cpp, TFTScreen.hpp, WiFiHandler.cpp, main.cpp, parameters.hpp]
2024-04-07 Fix segfault in message sender
    [MessageHandler.cpp, MessageReceiver.cpp, MessageReceiver.hpp, main.cpp]
2024-04-28 Add tirette functionnality
2024-05-04 Add comm delay and battery voltage info
2024-05-04 Add lock motors option
2024-05-04 Add Supervisor Servo
2024-05-06 Fix traj continuation and begin avoidance
    [MotionController.cpp, MotionController.hpp, MotionControllerSlowdown.cpp, Robot.cpp, Strategy_defaults.cpp]
2024-05-06 Add avoidance for PAMI
    [MotionController.cpp, MotionControllerSlowdown.cpp, parameters.hpp]
2024-05-07 Avoidance trajectories are now velocity-continuous
    [MotionController.cpp, MotionController.hpp, Robot.cpp, Strategy.hpp, Strategy_defaults.cpp, TelemetryHandler.cpp]
2024-05-07 BF pami & set supervisor board match code
2024-05-07 Put avoidance in an other file
    [MotionController.cpp, MotionController.hpp, parameters.hpp]
2024-05-07 Remove clear trajectories from old avoidance and add conditions on obstacle position
    [MotionController.cpp, Strategy_defaults.cpp]
2024-07-23 Switch to touchscreen
2024-07-24 Make clickable touch buttons
2024-07-26 Implement clickable button and switch to asynctcp
2024-08-18 Apparently fix issues with asynctcp lib
    [MessageReceiver.cpp, main.cpp]
2024-08-18 Clean supervisor board project
2024-08-18 Add button to CommonLibraries
2024-08-25 Reorganise projects
    [MiAM_ESP32.kicad_pcb, MiAM_ESP32.kicad_sch, MiAM_PAMI_DCShield.kicad_pcb, MiAM_PAMI_DCShield.kicad_sch, MiAM_PAMI_PowerShield.kicad_pcb, MiAM_PAMI_PowerShield.kicad_sch, MiAM_PAMI_StepperShield.kicad_pcb, MiAM_PAMI_StepperShield.kicad_sch]
2024-08-25 Add 2024 avoidance robot
    [partitions.csv]
2024-08-25 Init 2024 supervisor board
2024-08-26 Revamp anti-bounce button library
2024-08-26 Implement stepper control
2024-10-13 Begin 2025 PAMI
    [MiAM_PAMI_2024_DC.kicad_pcb, MiAM_PAMI_2024_DC.kicad_sch]
2024-11-11 Add new PAMI PCB
    [MiAM_PAMI_2024_DC.kicad_pcb, MiAM_PAMI_2024_DC.kicad_sch]
2024-11-18 Add LED ring and better routing
    [MiAM_PAMI_2024_DC.kicad_pcb, MiAM_PAMI_2024_DC.kicad_sch]
2024-12-01 Fix PAMI pcb
    [MiAM_PAMI_2024_DC.kicad_pcb, MiAM_PAMI_2024_DC.kicad_sch]
2024-12-01 Add additional breakout for BW16
    [MiAM_PAMI_2024_DC.kicad_pcb, MiAM_PAMI_2024_DC.kicad_sch]
2025-01-02 Update PCB
    [MiAM_PAMI_2024_DC.kicad_pcb]
2025-01-02 Add 2025 robot code
    [partitions.csv]
2025-01-03 Add communication using BW16
    [partitions.csv]
2025-02-22 Update PAMI code: leds and fix pid
    [I2CHandler.cpp, I2CHandler.hpp, I2CHandler_ssd1306.cpp, I2CHandler_vl53l0x.cpp, MotionController.cpp, ServoHandler.cpp, Strategy.cpp, TelemetryHandler.cpp]
2025-02-22 Add LED ring to PAMI
2025-02-23 Switch lcd library to TFT_eSPI
2025-02-23 Rework tft drawables into lib
    [PAMIDrawable.cpp, PAMIDrawable.hpp, TFTScreen.cpp, TFTScreen.hpp]
2025-02-23 Init presentation board code
2025-04-20 AvoidanceRobot: Use ESP32 remote instead of bt
    [MessageHandler.cpp, PAMIRemoteArduino.ino, main.cpp]
2025-04-20 Fix avoidance robot movement
    [main.cpp, parameters.hpp]
2025-05-09 Add PAMI Tank and Remote & fix robotbasedc
    [partitions.csv]
2025-05-10 Fix avoidance robot code for new remote orientation
    [main.cpp]
2025-05-11 Fix issue with deadzone pamitank
    [main.cpp]
2025-05-11 Update tft presentation board
2025-05-25 Fix switch logic & add specific behavior at match start
    [I2CHandler_vl53l0x.cpp, MotionController.cpp, Strategy_defaults.cpp, TelemetryHandler.cpp, parameters.hpp]
2025-05-25 Add blink mode for presentation board
2025-05-26 Fix PAMI trajs v1
    [Strategy_defaults.cpp, parameters.hpp]
2025-05-26 Add leds for avoidance robot
    [main.cpp]
2025-05-26 Fix sup board 100s & implement integration in AvoidanceRobot
    [main.cpp]
2025-07-05 Rename folders according to yearing conventions
    [partitions.csv]
2026-02-07 Revert mqtt changes for eurobot 2026
    [MessageReceiver.cpp, MessageReceiver.hpp, Robot.cpp]
2026-03-29 Revert slave board to old code
    [WiFiSlave.ino]
2026-04-25 Add leds on vlx reader
2026-04-26 Add global proximity led
2026-05-10 Update supervisor board code for squirel
2026-05-11 Working pump code
2026-05-12 Kind of working squirel avoidance
    [I2CHandler.cpp, I2CHandler_vl53l0x.cpp, MotionController.cpp, MotionControllerSlowdown.cpp, ServoHandler.cpp, TelemetryHandler.cpp, main.cpp]
2026-05-12 New pami code with new arm
2026-05-14 3rd match code & fix false positive avoidance
    [I2CHandler.hpp, I2CHandler_vl53l0x.cpp, Strategy.cpp]
2026-05-15 Fix Squirel code & 4th match code
    [MotionController.cpp, MotionController.hpp, MotionControllerSlowdown.cpp, Robot.cpp, Robot.hpp, Strategy.cpp, Strategy.hpp, TelemetryHandler.cpp]
2026-05-15 Add esp32 s3 zero symbol
2026-05-16 5th match code go forward 20mm
